ultrazohm/uz_d_encoder/Testing/Pictures/20201110_153028.jpg

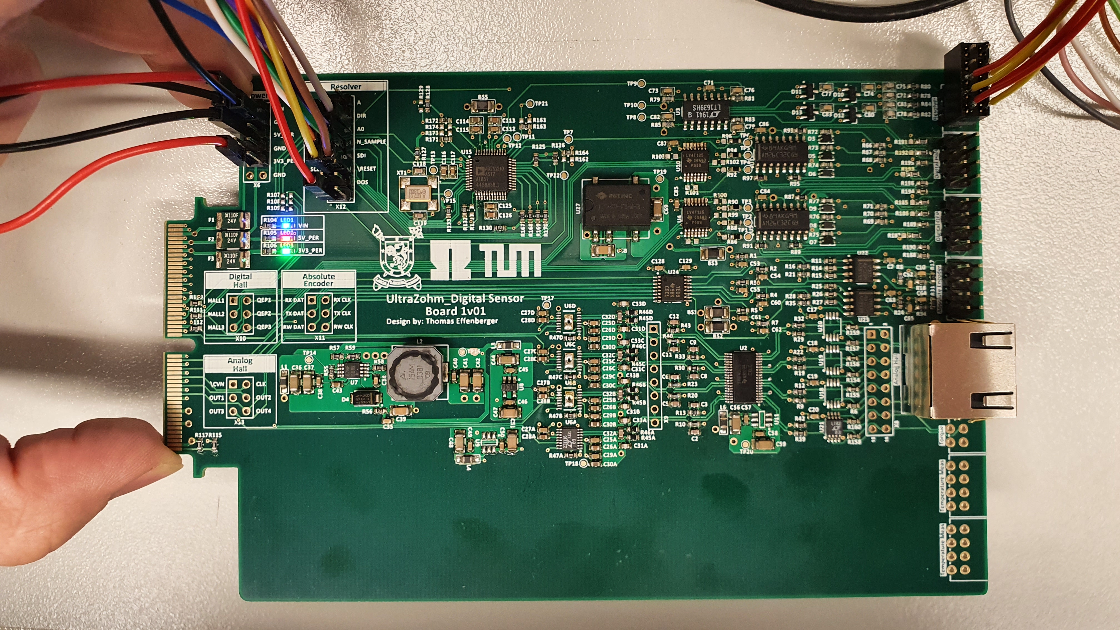
Testing/Pictures/20201110_153028.jpg
