ultrazohm/uz_d_encoder/Testing/Pictures/20201110_152825.jpg

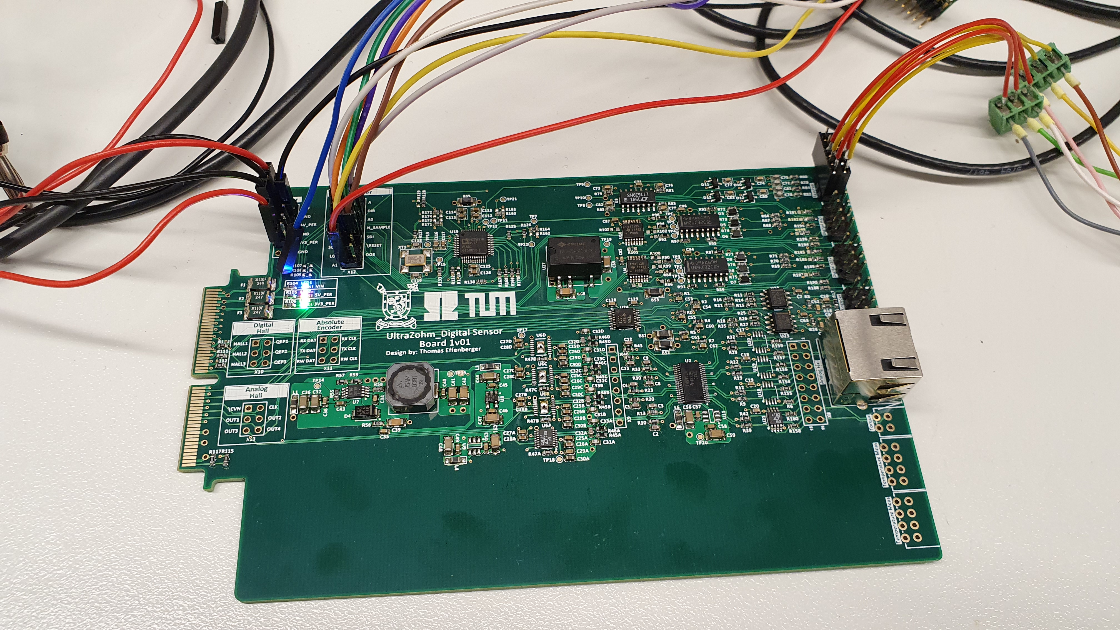
Testing/Pictures/20201110_152825.jpg
