ultrazohm/uz_d_encoder/Testing/Incremental_Encoder_Test/Incremental Sensor Pinout.txt

YE	HALL1_N	  |2	1|	HALL1_P	GN
PK	HALL2_N	  |4	3|	HALL2_P	GY
RD	HALL3_N	  |6	5|	HALL3_P	BU
WH	GND	  |8	7|	+5V	BN
