ultrazohm/uz_d_encoder/IP-Core/Resolver/Resolver.runs/impl_1/.init_design.begin.rst

<?xml version="1.0"?>
<ProcessHandle Version="1" Minor="0">
    <Process Command=".planAhead." Owner="ga63zix" Host="TUEIEAL-TS09" Pid="8820">
    </Process>
</ProcessHandle>
