ultrazohm/uz_d_encoder/IP-Core/Resolver/Resolver.runs/impl_1/.vivado.begin.rst

<?xml version="1.0"?>
<ProcessHandle Version="1" Minor="0">
    <Process Command="vivado.bat" Owner="ga63zix" Host="TUEIEAL-TS09" Pid="7052" HostCore="4" HostMemory="017000308736">
    </Process>
</ProcessHandle>
