ultrazohm/uz_d_encoder/pinout_table.xlsx

Carrier Connector | Default Variant | Net Name (Default) | Resolver Variant | Net Name (Resolver) | FPGA - 18 pins of D5
DIG_IO_00 | Resolver | DIR |  |  | NC
DIG_IO_01 | Resolver | CS |  |  | NC
DIG_IO_02 | Resolver | A0 |  |  | NC
DIG_IO_03 | Resolver | FSYNC |  |  | NC
DIG_IO_04 | Resolver | N_SAMPLE |  |  | NC
DIG_IO_05 | Resolver | SDO |  |  | NC
DIG_IO_06 | Resolver | SDI
DIG_IO_07 | Resolver | SCLK
DIG_IO_08 | Resolver | Reset
DIG_IO_09 | Resolver | A1
DIG_IO_10 | Resolver | LOT (Loss of Tracking) | Resolver | DOS (Degradation of signal)
DIG_IO_11 | Incremental Encoder 1 | A | Resolver | A
DIG_IO_12 | Incremental Encoder 1 | B | Resolver | B
DIG_IO_13 | Incremental Encoder 1 | 0 | Resolver | 0
DIG_IO_14 | Incremental Encoder 2 | A | Resolver | 1
DIG_IO_15 | Incremental Encoder 2 | B | Resolver | 2
DIG_IO_16 | Incremental Encoder 2 | 0 | Resolver | 3
DIG_IO_17 | Absolute Encoder | RX-S_DATA_SH | Resolver | 4
DIG_IO_18 | Absolute Encoder | TX-S_DATA_SH | Resolver | 5
DIG_IO_19 | Absolute Encoder | READ_WRITE_DATA_SH | Resolver | 6
DIG_IO_20 | Absolute Encoder | RX-S_CLOCK_SH | Resolver | 7
DIG_IO_21 | Absolute Encoder | TX-S_CLOCK_SH | Resolver | 8
DIG_IO_22 | Absolute Encoder | READ_WRITE_CLOCK_SH | Resolver | 9
DIG_IO_23 | Analog Hall | CNV | Resolver | 10
DIG_IO_24 | Analog Hall | CLK | Resolver | 11 | NC
DIG_IO_25 | Analog Hall | ADC1 | Resolver | 12 | NC
DIG_IO_26 | Analog Hall | ADC2 | Resolver | 13 | NC
DIG_IO_27 | Analog Hall | ADC3 | Resolver | 14 | NC
DIG_IO_28 | Analog Hall | ADC4 | Resolver | 15 | NC
DIG_IO_29 | Resolver | DOS (Degradation of signal) | Resolver | 16 | NC
