ultrazohm/uz_d_encoder/BOM UltraZohm_Digital_Sensor_Board.xls

Comment | Description | Designator | Footprint | LibRef | Quantity | Value | Manufacturer Part-Number | Supplier 1 | Supplier 2 | Supplier Part Number 1 | Supplier Part Number 2
RJ-45 Modulo | Modulo RJ-45 modulo Horizontal | A1 | RJ45 - 1x1 | RJ45 1 modulo Horizontal | 1 |  | 1-5406299-1 | Digikey |  | A121568-ND
Ferrite bead | 6A | BS1, BS2, BS3, BS5 | RES_1206 | Bead | 4 |  | HI1206T500R-10 | Digikey |  | 240-2412-1-ND
56pF | Capacitor Ceramic | C2, C3, C5, C6, C8, C9, C11, C12 | CAPC1608X07N | Cap_0603 | 8 | 56pF | VJ0603A560JXACW1BC | Mouser |  | 77-VJ0603A560JXACBC
100nF | Capacitor | C7, C53, C54, C55, C60, C61, C62, C63, C67, C71, C84, C85, C86, C87, C128, C129, C13, C14, C15, C16, C17, C18, C19, C20, C21, C22, C23, C24, C25A, C25B, C25C, C25D, C27A, C27B, C27C, C27D, C29A, C29B, C29C, C29D, C38, C40, C45, C46, C49, C50, C57, C58 | CAPC1608X07N | Cap_0603 | 48 | 100n | 885012206071 | Mouser |  | 710-885012206071
1nF | Capacitor | C10, C52, C64, C65, C73, C74, C76, C77, C79, C80, C82, C83 | CAPC1608X07N | Cap_0603 | 12 | 1nF | C0603C102K3GACTU | Digikey |  | 399-7833-1-ND
1uF | Capacitor | C26A, C26B, C26C, C26D, C28A, C28B, C28C, C28D | CAPC1608X07N | Cap_0603 | 8 | 1uF | LMK107B7105KA-T | Mouser |  | 963-LMK107B7105KA-T
10uF | Capacitor Ceramic | C30A, C30B, C30C, C30D, C114 | CAPC1608X07N | Cap_0603 | 5 | 10uF | JMK107ABJ106KA-T | Mouser |  | 963-JMK107ABJ106KA-T
680pF | Capacitor | C31A, C31B, C31C, C31D, C33A, C33B, C33C, C33D | CAPC1608X07N | Cap_0603 | 8 | 680pF | VJ0603A681GXJCW1BC | Mouser |  | 77-VJ0603A681GXJCBC
470pF | Capacitor | C32A, C32B, C32C, C32D | CAPC1608X07N | Cap_0603 | 4 | 470pF | VJ0603A471GXJPW1BC | Mouser |  | 77-VJ0603A471GXJPBC
10nF | Capacitor | C34, C112, C115, C117, C125 | CAPC1608X07N | Cap_0603 | 5 | 10nF | 885012206065 | Mouser |  | 710-885012206065
7.5nF | Capacitor | C35 | CAPC1608X07N | Cap_0603 | 1 | 7.5nF | C0603C752J3GACTU | Mouser |  | 80-C0603C752J3GACTU
10µF | Capacitor Ceramic | C36, C37, C44, C48, C56 | C_1206 |  | 5 | 10µF | GRM319R6YA106KA12D | Mouser |  | 81-GRM319R6YA106KA2D
0.027µF | Capacitor 1206 | C39 | C_1206 |  | 1 | 0.027µF | GRM3195C1H273JA01D | Mouser |  | 81-GRM315C1H273JA01D
47µF | Capacitor 1206 | C41, C42, C47, C51, C59 | C_1206 |  | 5 | 47µF | GRM31CR61A476ME15L | Mouser |  | 81-GRM31CR61A476ME5L
1uF | Capacitor Ceramic | C43 | CAPC1608X07N | Cap_0603 | 1 | 1uF | 885012106022 | Mouser |  | 710-885012106022
120pF | Capacitor Ceramic | C66, C70 | CAP_0603 | Cap_0603 | 2 | 120pF | 06033A121JAT2A | Digikey |  | 478-11799-1-ND
1uF | Capacitor Ceramic | C68 | RES_1206 | Cap_1206 | 1 | 1uF | CC1206ZRY5V9BB105 | Digikey |  | 311-2013-1-ND
2.2uF | Capacitor Ceramic | C69 | RES_1206 | Cap_1206 | 1 | 2.2uF | C1206C225K5RACTU | Digikey |  | 399-8181-1-ND
100pF | Capacitor Ceramic | C72, C75, C78, C81 | CAP_0603 | Cap_0603 | 4 | 100pF | CC0603JRNPO8BN101 | Digikey |  | 311-3949-1-ND
4.7uF | Capacitor Ceramic | C113, C116, C126 | CAP_0603 | Cap_0603 | 3 | 4.7uF | CL10A475KA8NQNC | Digikey |  | 1276-1900-1-ND
20pF | Capacitor Ceramic | C118, C119 | CAP_0603 | Cap_0603 | 2 | 20pF | CC0603JRNPO9BN200 | Digikey |  | 311-1424-1-ND
470nF | Capacitor Ceramic | C121 | CAP_0603 | Cap_0603 | 1 | 470nF | GRM188R61A474KA61D | Digikey |  | 490-1539-1-ND
Conector 4x2 Horizontal | CONN HEADER R/A 8POS 2.54MM Through Hole | CONN1, CONN3, CONN4, CONN6A, CONN6B | Conector 4x2 TH Horizontal | Conector 4x2 Horizontal | 5 |  | IPL1-104-01-L-D-RA-K | Digikey |  | SAM9596-ND
Conector 2x2 Horizontal | CONN HEADER R/A 4 POS 2.54MM Through Hole | CONN2 | Conector 2x2 TH Horizontal | Conector 2x2 Horizontal | 1 |  | IPL1-102-01-L-D-RA-K | Digikey |  | SAM8823-ND
Conector 3x2 Horizontal | CONN HEADER R/A 6 POS 2.54MM Through Hole | CONN5 | Conector 3x2 TH Horizontal | Conector 3x2 Horizontal | 1 |  | IPL1-103-01-L-D-RA-K | Digikey |  | SAM9096-ND
Conector 1x2 Horizontal | CONN HEADER R/A 2POS 2.54MM Through Hole | CONN7 | Conector 1x2 TH Horizontal | Conector 1x2 Horizontal | 1 |  | IPL1-102-01-S-S-RA-K | Digikey |  | SAM12667-ND
Header 6X2 | Header, 12-Pin, Dual row | CONN6 |  |  | 1
Header 8X2 | Header, 16-Pin, Dual row | CONN8
Header 8X1 | Header, 8-Pin, Dual row | CONN9
Diode Array | DIODE ARRAY GP 100V 215MA SOT23 | D1, D2 | SOT-23 | Diode Array | 2 |  | BAV99,235 | Digikey |  | 1727-4311-1-ND
TVS DIODE | TVS DIODE 5V 13.5V SOD323 | D3, D5, D6, D7, D8, D9 | SOD-323 | Diodo TVS | 6 |  | CDSOD323-T05S | Digikey |  | CDSOD323-T05SCT-ND
BYS12-90 | Schottky Diode | D4 | DIOM4227X23N | BYS12-90 | 1 |  | BYS12-90-E3/TR | Digikey |  | BYS12-90-E3/GICT-ND
Diode Array Schottky | DIODE SCHOTTKY 70V DUAL SOT23 | D10, D11, D12, D13 | SOT-23 | Diode Array Schottky | 4 |  | SBAS70-04LT1G | Digikey |  | SBAS70-04LT1GOSCT-ND
Isolated DC-DC Converter | DC DC CONVERTER 12V 1W | U27 | DC/DC 24V-->12V 1W Aislado | DC/DC +12V 1W | 1 |  | PDS1-S24-S12-M-TR | Digikey |  | 102-3406-1-ND
RS485 Transmitter | IC TRANSCEIVER HALF 1/1 8SOIC | U22, U23 | SOIC8_N | Transmisor RS485 | 2 |  | SN75HVD08DR | Digikey |  | 296-37893-1-ND
600Ω | WE-CBF SMD EMI Suppression Ferrite Bead, 0805, 600Ω | L1, L3, L4, L6 | WE-CBF_0805_High Current | WE-CBF, 742792040 | 4 | 600Ω | 742792040 | Farnell | Mouser | 2761567 (https://octopart-clicks.com/click/altium?sku=732-1620-1-ND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) | 710-742792040 (https://octopart-clicks.com/click/altium?sku=732-1620-1-ND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)
150mH | SMT power Inductor, 150uH, 320m DRC | L2 | SMT_inductor_1050_Performance | B82464G4154M | 1 | 150mH | B82464G4154M | Mouser |  | 871-B82464G4154M
Level Shifter 3.3V/5V | Level shifter bidireccional 6 canales | U24 | TSSO5x6-G16 | Level Shifter 1.8V/3.3V | 1 |  | TXB0106PWR | Digikey |  | 296-23759-1-ND
Transistor NPN | NPN Bipolar Transistor | Q1, Q3 | SOT-23 | NPN Transistor BC846 | 2 |  | BC846BLT3G | Digikey |  | BC846BLT3GOSCT-ND
Transistor PNP | PNP Bipolar Transistor | Q2, Q4 | SOT-23 | PNP Transistor BC846 | 2 |  | BC856B,215 | Digikey |  | 1727-2925-1-ND
1k | Resistor | R1, R2, R3, R4, R5, R7, R8, R9, R10, R12, R13, R18, R19, R20, R22, R23, R24, R29, R30, R32, R33, R34, R39, R40, R42, R43, R57, R59 | RESC1608X06N | R_0603 | 28 | 1k | RC0603FR-071KL | Mouser |  | 603-RC0603FR-071KL
0R | Resistor | R6, R14, R15, R26, R27, R47A, R47B, R47C, R47D, R98, R99, R100, R101, R102, R103, R104, R105, R106, R107, R108, R109, R110, R111, R112, R113, R114, R115, R116, R117, R118, R119, R154, R155, R156, R157, R158, R159, R160, R165, R166, R167, R168, R169, R170, R175, R176, R177, R178, R179, R180, R181, R182, R183, R184, R188, R189, R190, R194, R195, R196, R197, R198 | RESC1608X06N | R_0603 | 62 | 0R | CRCW06030000Z0EAC | Mouser |  | 71-CRCW06030000Z0EAC
22 | Resistor | R11, R25 | RESC1608X06N | R_0603 | 2 | 22 | CPF0603B22RE | Digikey |  | A119957CT-ND
10k | Resistor | R16, R21, R28, R35, R44, R48, R61, R161, R162, R163, R164, R171, R172, R173, R174 | RESC1608X06N | R_0603 | 15 | 10k | RC0603JR-0710KL | Digikey |  | 311-10KGRCT-ND
120 | Resistor | R17, R31 | RESC1608X06N | R_0603 | 2 | 120 | ERA-3AEB121V | Digikey |  | P120DBCT-ND
15.4k | Resistor | R36, R53 | RESC1608X06N | R_0603 | 2 | 15.4k | ERA-3AEB1542V | Digikey |  | P15.4KDBCT-ND
22k | Resistor | R37 | RESC1608X06N | R_0603 | 1 | 22k | RC0603JR-0722KL | Digikey |  | 311-22KGRCT-ND
2.2k | Resistor | R38, R52, R54, R65 | RESC1608X06N | R_0603 | 4 | 2.2k | ERJ-3GEYJ222V | Digikey |  | P2.2KGCT-ND
3.3 | Resistor | R41, R51, R60, R64 | RESC1608X06N | R_0603 | 4 | 3.3 | ERJ-3RQF3R3V | Digikey |  | P3.3AJCT-ND
24.9 | Resistor | R45A, R45B, R45C, R45D, R46A, R46B, R46C, R46D | RESC1608X06N | R_0603 | 8 | 24.9 | RC0603FR-0724R9L | Mouser |  | 603-RC0603FR-0724R9L
4.7k | Resistor | R49, R50, R62, R63, R79, R81, R83, R85 | RESC1608X06N | R_0603 | 8 | 4.7k | ERA-3AEB472V | Digikey |  | P4.7KDBCT-ND
162k | Resistor | R55 | RESC1608X06N | R_0603 | 1 | 162k | CRCW0603162KFKEA | Mouser |  | 71-CRCW0603-162K-E3
75k | Resistor | R56 | RESC1608X06N | R_0603 | 1 | 75k | RC0603FR-0775KL | Mouser |  | 603-RC0603FR-0775KL
133k | Resistor | R58 | RESC1608X06N | R_0603 | 1 | 133k | RC0603FR-07133KL | Mouser |  | 603-RC0603FR-07133KL
3.5k | Resistor | R66, R67, R68, R69, R70, R71, R72, R73, R74, R75, R76, R77 | RESC1608X06N | R_0603 | 12 | 3.5k | ERA-3AEB3481V | Digikey |  | P3.48KDBCT-ND
100 | Resistor | R78, R80, R82, R84, R87, R89, R91, R93, R95, R97 | RESC1608X06N | R_0603 | 10 | 100 | RC0603FR-07100RL | Digikey |  | 311-100HRCT-ND
dnp | Solder 0603 resistor/jumper between pads 1 and 2 for standard function. Solter resistor between pads 2 and 3 for alternative function | R86, R88, R90, R92, R94, R96, R185, R186, R187, R191, R192, R193 | 0603_Config | R_config | 12 | 10k | RC0603JR-0710KL | Digikey |  | 311-10KGRCT-ND
200R | WID SMD 1M 5% 0,25W | R150, R151, R152, R153 | RES_1206 |  | 4 | 200R | APC1206B200RN | Mouser |  | 284-APC1206B200RN
2 Channel Opamp | IC OPAMP GP 2 CIRCUIT 14SOIC | U1 | SOIC8_N | AD8662 | 1 |  | AD8662ARZ-REEL7 | Digikey |  | AD8662ARZ-REEL7CT-ND
THS4524 | IC OPAMP DIFF 95MHZ RRO 38TSSOP | U2 | TSSOP38 | THS4521 | 1 |  | THS4524IDBTR | Farnell | Mouser | 2496350 (https://octopart-clicks.com/click/altium?sku=296-24315-1-ND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) | 595-THS4524IDBTR (https://octopart-clicks.com/click/altium?sku=296-24315-1-ND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)
LT1639 | IC OPAMP GP 4 CIRCUIT 14SO | U3 | SOIC-14 | LT1639 | 1 |  | LT1639HS#PBF | Digikey |  | LT1639HS#PBF-ND
IC BUFFER NON-INVERT 5.5V US8 | 3 Channels | U4, U10 | 8-VSSOP | Buffer No inversor | 2 |  | SN74LVC3G17DCUR | Digikey |  | 296-18818-1-ND
Differential Receiver | Logic Differential to Single Ended | U5, U12 | SOIC-16 | Differential Receiver | 2 |  | AM26C32MDREP | Digikey |  | 296-23458-1-ND
LTC2311 | 16 Bit SAR ADC, 5MSps | U6A, U6B, U6C, U6D | LTC2311-16 | LTC2311-16 | 4 |  | LTC2311CMSE-16#PBF | Mouser | Digi-Key | 584-C2311CMSE-16PBF | LTC2311CMSE-16#PBF-ND
LM5007 | Buck Converter, 9-75Vin, 2.5-73Vout | U7 | TSOP65P490X110-8N | LM5007 | 1 |  | LM5007MM/NOPB | Farnell | Mouser | 9779345 (https://octopart-clicks.com/click/altium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) | 926-LM5007MM/NOPB (https://octopart-clicks.com/click/altium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)
TLV741P | 150mA, 2.5V LDO | U8 | SOT95P250X110-5N | TLV741P | 1 |  | TLV74125PDBVR | Mouser | Digi-Key | 595-TLV74125PDBVR | 296-49999-1-ND
LT6654 | Voltage Rerefence | U9, U11 | SOT95P280X100-6N | LT6654 | 2 |  | LT6654BIS6-2.5#TRMPBF | Farnell | Mouser | 2761960 (https://octopart-clicks.com/click/altium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) | 584-6654BIS65TRMPBF (https://octopart-clicks.com/click/altium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)
AD2S1210 | Variable Resolution, 10-Bit to 16-Bit R/D Converter with Reference Oscillator | U15 | LQFP-48_L | AD2S1210 | 1 | AD2S1210 | AD2S1210WDSTZRL7 | Mouser | Digi-Key | 584-AD2S1210WDSTZR7 | AD2S1210WDSTZRL7CT-ND
LT6203 | IC OPAMP GP 2 CIRCUIT 8MSOP | U18, U19, U20, U21 | 8-MSOP | LT6203 | 4 |  | LT6203CMS8#PBF | Digikey |  | LT6203CMS8#PBF-ND
8 MHz | CRYSTAL 8MHZ 18PF SMD | XT1 | CRYSTALOSC | Crystal_8MHz | 1 |  | ECS-80-18-30B-AGN-TR | Digikey |  | XC2709CT-ND
