ultrazohm/uz_d_encoder/Project Outputs for UZ_D_Encoder/Rev02/BOM/bom20211114.xlsx

Sheet: IC
Verfügbar | Comment | Description | Designator | Footprint | LibRef | Quantity | Value | Supplier 1 | Supplier 2 | Supplier Part Number 1 | Supplier Part Number 2
 | LTC6373IDFM#PBF | INST Amp Single ±18V 12-Pin DFN EP Tube | _x0013_A, _x0013_B, _x0013_C, _x0013_D | FP-LTC6373IDFM#PBF-MFG | CMP-09116-000044-1 | 4
 | SN74CBT16214CDGG | Multiplexer/Demultiplexer Bus Switch 1-Element CMOS 36-IN 56-Pin TSSOP Tube | MUX1, MUX2 | TSSOP50P810X120-56N | SN74CBT16214CDGG | 2 |  | Arrow Electronics |  | SN74CBT16214CDGG
 | BC846BLT3G | NPN Bipolar Transistor | Q1, Q3 | SOT-23 | NPN Transistor BC846 | 2 |  | Mouser | Digi-Key | 863-BC846BLT3G | BC846BLT3GOSCT-ND
 | BC856B,215 | PNP Bipolar Transistor | Q2, Q4 | SOT-23 | PNP Transistor BC846 | 2 |  | Mouser | Digi-Key | 771-BC856B-T/R | 1727-2925-1-ND
 | AD8662ARZ | IC OPAMP GP 2 CIRCUIT 14SOIC | U1 | SOIC8_N | AD8662 | 1 |  | Mouser | Digi-Key | 584-AD8662ARZ | AD8662ARZ-ND
 | TXB0108PWR | TXB0108 8-Bit Bidirectional Voltage-Level Translator with Auto-Direction Sensing and +/- 15-kV ESD Protection, 1.2 to 3.6 V, -40 to 85 degC, 20-Pin TSSOP (PW), Green (RoHS & no Sb/Br), Tape and Reel | U2A, U2B | PW0020A_L | CMP-2000-07337-1 | 2
 | LT1639HS#PBF | IC OPAMP GP 4 CIRCUIT 14SO | U3 | SOIC-14 | LT1639 | 1 |  | Mouser | Digikey | 584-LT1639HS#PBF | LT1639HS#PBF-ND
 | ISO7230CDWR | High-Speed, Triple-Channel Digital Isolator | U4, U12 | TI ISO7230 SOIC | TI ISO7230 | 2 |  | Mouser |  | 595-ISO7230CDWR
 | AM26LS32A | Quad Differential Line Receiver, 16-pin Narrow SOIC | U5, U13 | M16A_N | DS26LS32CM | 2 |  | Mouser |  | 595-AM26LS32AIDR
 | LTC2311 | 16 Bit SAR ADC, 5MSps | U6A, U6B, U6C, U6D | LTC2311-16 | LTC2311-16 | 4 |  | Mouser | Digi-Key | 584-C2311CMSE-16PBF | LTC2311CMSE-16#PBF-ND
 | LM5007 | Buck Converter, 9-75Vin, 2.5-73Vout | U7 | TSOP65P490X110-8N | LM5007 | 1 |  | Farnell | Mouser | 9779345 | 926-LM5007MM/NOPB
 | TLV74125PDBVR | 150mA, 2.5V LDO | U8 | SOT95P250X110-5N | TLV741P | 1 |  | Mouser | Digi-Key | 595-TLV74125PDBVR | 296-49999-1-ND
 | LT6654 |  | U9, | SOT95P280X100-6N | LT6654 | 1 |  | Farnell | Mouser | 2761960 | 584-6654BIS65TRMPBF, 584-6654BIS625TRMPBF
 | TMH 0505S | 5V/5V DC-DC Isolation Converter | U10, U14 | SIL-6(7) | TRACO TMH 0505S | 2
 | AD2S1210WDSTZR7 | Variable Resolution, 10-Bit to 16-Bit R/D Converter with Reference Oscillator | U15 | LQFP-48_L | AD2S1210 | 1 | AD2S1210 | Mouser | Digi-Key | 584-AD2S1210WDSTZR7 | AD2S1210WDSTZRL7CT-ND
 | LTC3265EFE#PBF | IC REG CHARG PUMP INV DL 20TSSOP | U16 | FP-FE-20-05-08-1663-MFG | CMP-09139-000006-1 | 1
 | LM3480IM3X-12 | 100 mA, Quasi Low-Dropout Linear Voltage Regulator, 3-pin SOT-23 | U17 | DBZ0003A_L | CMP-0056-00145-3 | 1
 | PCA9554ADGVR | Remote 8-Bit I2C and SMBus I/O Expander with Interrupt Output and Configuration Registers, 8 Outputs, 2.3 to 5.5 V, -40 to 85 degC, 16-pin TVSOP (DGV), Green (RoHS & no Sb/Br) | U18A, U18B, U18C | DGV0016A_L | CMP-0314-00393-2 | 3
 | SN75HVD08DR | IC TRANSCEIVER HALF 1/1 8SOIC | U22A, U22B, U23A, U23B | SOIC8_N | Transmisor RS485 | 4 |  | Mouser | Digi-Key | 595-SN75HVD08DR | 296-37893-1-ND
 | PDS1-S24-S12-M-TR | DC DC CONVERTER 12V 1W | U27 | DC/DC 24V-->12V 1W Aislado | DC/DC +12V 1W | 1 |  | Mouser | Digi-Key | 490-PDS1S24S12MTR | 102-3406-1-ND

Sheet: L
600Ω | WE-CBF SMD EMI Suppression Ferrite Bead, 0805, 600Ω | L1, L3, L4, L5, L6 | WE-CBF_0805_High Current | WE-CBF, 742792040 | 5 | 600Ω | Farnell | Mouser | 2761567 | 710-742792040
150mH | SMT power Inductor, 150uH, 320m DRC | L2 | SMT_inductor_1050_Performance | B82464G4154M | 1 | 150mH | Mouser |  | 871-B82464G4154M
782763102 | ALTERNATIVE Ferrite bead 6A | BS1A, BS1B, BS2A, BS2B, BS3, BS4, BS5 | RES_1206 | Bead | 7 |  | Mouser | Digi-Key | 875-HI1206T500R-10 | 240-2412-1-ND

Sheet: SW
206-126 | Switch DIP OFF ON SPDT 6 Raised Slide 0.05A 24VDC PC Pins 2.54mm Thru-Hole Tube | SW1A, SW1B, SW1C, SW1D, SW2, SW3 | 206-123 | 206-126 | 6 | Digi-Key | 206-126-ND

Sheet: CON
IPL1-104-01-L-D-RA-K | CONN HEADER R/A 8POS 2.54MM Through Hole | X1A, X1B, X3, X4 | Conector 4x2 TH Horizontal | Conector 4x2 Horizontal | 4 | Mouser | Digi-Key | 200-IPL110401LDRAK | SAM9596-ND
IPL1-102-01-L-D-RA-K | CONN HEADER R/A 4 POS 2.54MM Through Hole | X2 | Conector 2x2 TH Horizontal | Conector 2x2 Horizontal | 1 | Mouser | Digi-Key | 200-IPL110201LDRAK | SAM8823-ND
IPL1-103-01-L-D-RA-K | CONN HEADER R/A 6 POS 2.54MM Through Hole | X5 | Conector 3x2 TH Horizontal | Conector 3x2 Horizontal | 1 | Mouser | Digi-Key | 200-IPL110301LDRAK | SAM9096-ND
Header 6X2 | Header, 6-Pin, Dual row | X6 | HDR2X6 | Header 6X2 | 1
IPL1-102-01-S-S-RA-K | CONN HEADER R/A 2POS 2.54MM Through Hole | X7 | Conector 1x2 TH Horizontal | Conector 1x2 Horizontal | 1 | Mouser | Digi-Key | 200-IPL110201SSRAK | SAM12667-ND
Header 8X2 | Header, 8-Pin, Dual row | X8, X9 | HDR2X8 | Header 8X2 | 2
615008140621 | Modular Jack WR-MJ, Tab Up, Shielded, with EMI Panel Finger, Horizontal Entry, THT, 8P8C | X17 | 615008140621 | 615008140621 | 1 | Mouser | Digi-Key | 710-615008140621 | 732-2742-ND

Sheet: D
BAV99,215 | DIODE ARRAY GP 100V 215MA SOT23 | D1, D2 | SOT-23 | Diode Array | 2 |  | Mouser | Digi-Key | 771-BAV99235 | 1727-4311-1-ND
CDSOD323-T03C | TVS DIODE 3.3V 19V SOD323 | D3, D5, D6, D7, D8, D9 | SOD-323 | Diodo TVS | 6 |  | Mouser | Digi-Key | 652-CDSOD323-T03C | CDSOD323-T03CCT-ND
BYS12-90 | Schottky Diode | D4 | DIOM4227X23N | BYS12-90 | 1 |  | Farnell | Mouser | 2889144 | 625-BYS12-90-E3/TR3
SBAS70-04LT1G | DIODE SCHOTTKY 70V DUAL SOT23 | D10, D11, D12, D13 | SOT-23 | Diode Array Schottky | 4 |  | Mouser | Digi-Key | 863-SBAS70-04LT1G | SBAS70-04LT1GOSCT-ND
150060BS75000 | WL-SMCW SMD Mono-color Chip LED Waterclear, size 0603, Blue, 3.2 V, 140° | LED1 | WL-SMCW_0603 | LED_Blue_0603 | 1 | 150060BS75000 | Farnell | Mouser | 2322069 | 710-150060BS75000
150060RS75000 | WL-SMCW SMD Mono-color Chip LED Waterclear, size 0603, Red, 2 V, 140° | LED2 | WL-SMCW_0603 | LED_Red_0603 | 1 | 150060RS75000 | Farnell | Mouser | 2322071 | 710-150060RS75000
150060GS75000 | WL-SMCW SMD Mono-color Chip LED Waterclear, size 0603, Green, 3.2 V, 140° | LED3 | WL-SMCW_0603 | LED_Green_0603 | 1 | 150060GS75000 | Farnell | Mouser | 2322070 | 710-150060GS75000

Sheet: C
1uF |  | C1A, C1B, C1C, C1D, C26A, C26B, C26C, C26D, C28A, C28B, C28C, C28D, C43, C84, C89 | CAPC1608X07N | Cap_0603 | 15 | 1uF | Mouser | 963-LMK107B7105KA-T, 710-885012206071
100nF |  | C2A, C2B, C2C, C2D, C7A, C7B, C8A, C8B, C8C, C8D, C25A, C25B, C25C, C25D, C27A, C27B, C27C, C27D, C29A, C29B, C29C, C29D, C38, C40, C45, C46, C49, C50, C53A, C53B, C54A, C54B, C55A, C55B, C57, C58, C60A, C60B, C61A, C61B, C62A, C62B, C63A, C63B, C67, C71, C85, C86, C90, C91, C92, C93, C94, C95, C96A, C96B, C96C, C97A, C97B, C97C, C128A, C128B, C129A, C129B | CAPC1608X07N | Cap_0603 | 64 | 100nF | Mouser | 710-885012206071
680pF |  | C3A, C3B, C3C, C3D, C6A, C6B, C6C, C6D, C31A, C31B, C31C, C31D, C33A, C33B, C33C, C33D | CAPC1608X07N | Cap_0603 | 16 | 680pF | Mouser | 77-VJ0603A681GXJCBC
470pF |  | C4A, C4B, C4C, C4D, C32A, C32B, C32C, C32D | CAPC1608X07N | Cap_0603 | 8 | 470pF | Mouser | 77-VJ0603A471GXJPBC
180pF |  | C5A, C5B, C5C, C5D | CAPC1608X07N | Cap_0603 | 4 | 180pF | Mouser | 77-VJ0603A681GXJCBC
100nF | Capacitor | C9, C11, C16, C17 | RESC0805 | Cap | 4 | 100nF
1nF |  | C10A, C10B, C52A, C52B, C64A, C64B, C65A, C65B, C73, C74, C76, C77, C79, C80, C82, C83 | CAPC1608X07N | Cap_0603 | 16 | 1nF
10nF | Capacitor | C12, C13, C14, C18, C19, C21 | RESC0805 | Cap | 6 | 10nF
10uF | Capacitor | C15, C20 | CAPR5-4X5 | Cap2 | 2 | 10uF
10uF | Capacitor 1206 | C22, C23, C24, C36, C37, C44, C48, C56, C87, C88 | C_1206 | C_1206 | 10 | 10uF | Mouser | 81-GRM319R6YA106KA2D
10uF |  | C30A, C30B, C30C, C30D, C114 | CAPC1608X07N | Cap_0603 | 5 | 10uF | Mouser | 963-JMK107ABJ106KA-T
10nF |  | C34, C112, C115, C117, C125 | CAPC1608X07N | Cap_0603 | 5 | 10nF | Mouser | 710-885012206065
7.5nF |  | C35 | CAPC1608X07N | Cap_0603 | 1 | 7.5nF | Mouser | 80-C0603C752J3GACTU
0.027uF | Capacitor 1206 | C39 | C_1206 | C_1206 | 1 | 0.027uF | Mouser | 81-GRM315C1H273JA01D
47uF | Capacitor 1206 | C41, C42, C47, C51, C59 | C_1206 | C_1206 | 5 | 47uF | Mouser | 81-GRM31CR61A476ME5L
120pF |  | C66, C70 | CAPC1608X07N | Cap_0603 | 2 | 120pF
1uF | Capacitor | C68 | RES_1206 | Cap_1206 | 1 | 1uF
2.2uF | Capacitor | C69 | RES_1206 | Cap_1206 | 1 | 2.2uF
100pF |  | C72, C75, C78, C81 | CAPC1608X07N | Cap_0603 | 4 | 100pF
4.7uF |  | C113, C116, C126 | CAPC1608X07N | Cap_0603 | 3 | 4.7uF
20pF |  | C118, C119 | CAPC1608X07N | Cap_0603 | 2 | 20pF

Sheet: FUSE
PTC, 1.1A, 24V | Resettable PTC Polyfuse SMD, 1812, automotive | F1, F2, F3 | 1812_PTC_Polyfuse_Littelfuse | Littelfuse_PTC_1812 | 3 | PTC, 1.1A, 24V

Sheet: R
100k |  | R1A, R1B, R2A, R2B, R3A, R3B, R4A, R4B, R5A, R5B, R7A, R7B | RESC1608X06N | R_0603 | 12 | 100k
24R9 |  | R6A, R6B, R6C, R6D, R9A, R9B, R9C, R9D, R45A, R45B, R45C, R45D, R46A, R46B, R46C, R46D | RESC1608X06N | R_0603 | 16 | 24R9
1k |  | R8A, R8B, R18A, R18B, R24A, R24B, R34A, R34B, R57, R59 | RESC1608X06N | R_0603 | 10 | 1k
10k |  | R10A, R10B, R10C, R10D, R12A, R12B, R12C, R12D, R13A, R13B, R13C, R13D, R16A, R16B, R21A, R21B, R28A, R28B, R32, R35A, R35B, R39, R40, R42, R43, R44, R48, R61, R87, R125, R126, R128, R129, R131, R132, R134, R135, R136, R137, R138, R139, R143, R144, R145, R161, R162, R163, R164, R167, R168, R169, R170, R171, R172, R173, R174 | RESC1608X06N | R_0603 | 56 | 10k
22R |  | R11A, R11B, R25A, R25B | RESC1608X06N | R_0603 | 4 | 22R
0R |  | R14A, R14B, R15A, R15B, R26A, R26B, R27A, R27B, R47A, R47B, R47C, R47D, R115, R117, R188, R189, R190, R194, R195, R196 | RESC1608X06N | R_0603 | 20 | 0R
120 |  | R17A, R17B, R31A, R31B | RESC1608X06N | R_0603 | 4 | 120
15.4k |  | R36, R53 | RESC1608X06N | R_0603 | 2 | 15.4k
22k |  | R37 | RESC1608X06N | R_0603 | 1 | 22k
2.2k |  | R38, R52, R54, R65 | RESC1608X06N | R_0603 | 4 | 2.2k
3.3 |  | R41, R51, R60, R64 | RESC1608X06N | R_0603 | 4 | 3.3
4.7 |  | R49, R50, R62, R63 | RESC1608X06N | R_0603 | 4 | 4.7
162k |  | R55 | RESC1608X06N | R_0603 | 1 | 162k
75k |  | R56 | RESC1608X06N | R_0603 | 1 | 75k
133k |  | R58 | RESC1608X06N | R_0603 | 1 | 133k
3.5k |  | R66, R67, R68, R69, R70, R71, R72, R73, R74, R75, R76, R77 | RESC1608X06N | R_0603 | 12 | 3.5k
100 |  | R78, R80, R82, R84 | RESC1608X06N | R_0603 | 4 | 100
4.7k |  | R79, R81, R83, R85 | RESC1608X06N | R_0603 | 4 | 4.7k
VISHAY VSOR 47.K | Isolated Resistor Network | R92, R99 | SO-16_N | Res Pack3 | 2 | 4.7K
120 | Resistor | R93, R94, R95, R100, R101, R102 | RESC0805 | Resistor | 6 | 120
24.9k |  | R104 | RESC1608X06N | R_0603 | 1 | 24.9k
3.01k |  | R105 | RESC1608X06N | R_0603 | 1 | 3.01k
1.3k |  | R106 | RESC1608X06N | R_0603 | 1 | 1.3k
0 |  | R112, R113, R114, R116 | RESC1608X06N | R_0603 | 4 | 0
604k |  | R118, R119 | RESC1608X06N | R_0603 | 2 | 604k
52k3 |  | R120, R121 | RESC1608X06N | R_0603 | 2 | 52k3
15k |  | R127, R133 | RESC1608X06N | R_0603 | 2 | 15k
7.5k |  | R130 | RESC1608X06N | R_0603 | 1 | 7.5k
