ultrazohm/uz_d_encoder/Project Outputs for UZ_D_Encoder/Rev02/BOM/bom20211116.xlsx

Sheet: Mouser
Part Number | Menge
584-LTC6373IDFMPBF | 4
595-SN74CBT16214CDGG | 2
863-SBC846BLT3G | 2
771-BC856B-T/R | 2
584-AD8662ARZ | 1
584-LT1639HS#PBF | 1
595-AM26LS32AIDR | 1
595-ISO7230CDWR | 2
584-C2311IMSE-16PBF | 4
595-TLV74125PDBVR | 1
584-AD2S1210WDSTZR7 | 1
584-LTC3265EFE#PBF | 1
926-LM3480IM3X12NOPB | 1
595-PCA9554ADGVR | 3
595-SN75HVD08DR | 4
490-PDS1S24S12MTR | 1
520-80-18-30B-AGNT | 1
774-206126 | 6
710-742792040 | 5
871-B82464G4154M | 1
710-782763102 | 7
200-IPL110401LDRAK | 4
200-IPL110201LDRAK | 1
200-IPL110301LDRAK | 1
200-IPL110201SSRAK | 1
710-615008140621 | 1
571-1033286 | 1
571-5-146254-8 | 2
710-150060BS75000 | 1
710-150060GS75000 | 1
710-150060RS75000 | 1
625-BYS12-90-E3/TR3 | 1
576-1812L075/24DR | 3

Sheet: Res
100k |  | R1A, R1B, R2A, R2B, R3A, R3B, R4A, R4B, R5A, R5B, R7A, R7B | RESC1608X06N | R_0603 | 12 | 100k
24R9 |  | R6A, R6B, R6C, R6D, R9A, R9B, R9C, R9D, R45A, R45B, R45C, R45D, R46A, R46B, R46C, R46D | RESC1608X06N | R_0603 | 16 | 24R9
1k |  | R8A, R8B, R18A, R18B, R24A, R24B, R34A, R34B, R57, R59 | RESC1608X06N | R_0603 | 10 | 1k
10k |  | R10A, R10B, R10C, R10D, R12A, R12B, R12C, R12D, R13A, R13B, R13C, R13D, R16A, R16B, R21A, R21B, R28A, R28B, R32, R35A, R35B, R39, R40, R42, R43, R44, R48, R61, R87, R125, R126, R128, R129, R131, R132, R134, R135, R136, R137, R138, R139, R143, R144, R145, R161, R162, R163, R164, R167, R168, R169, R170, R171, R172, R173, R174 | RESC1608X06N | R_0603 | 56 | 10k
22R |  | R11A, R11B, R25A, R25B | RESC1608X06N | R_0603 | 4 | 22R
0R |  | R14A, R14B, R15A, R15B, R26A, R26B, R27A, R27B, R47A, R47B, R47C, R47D, R115, R117, R188, R189, R190, R194, R195, R196 | RESC1608X06N | R_0603 | 20 | 0R
120 |  | R17A, R17B, R31A, R31B | RESC1608X06N | R_0603 | 4 | 120
15.4k |  | R36, R53 | RESC1608X06N | R_0603 | 2 | 15.4k
22k |  | R37 | RESC1608X06N | R_0603 | 1 | 22k
2.2k |  | R38, R52, R54, R65 | RESC1608X06N | R_0603 | 4 | 2.2k
3.3 |  | R41, R51, R60, R64 | RESC1608X06N | R_0603 | 4 | 3.3
4.7 |  | R49, R50, R62, R63 | RESC1608X06N | R_0603 | 4 | 4.7
162k |  | R55 | RESC1608X06N | R_0603 | 1 | 162k
75k |  | R56 | RESC1608X06N | R_0603 | 1 | 75k
133k |  | R58 | RESC1608X06N | R_0603 | 1 | 133k
3.5k |  | R66, R67, R68, R69, R70, R71, R72, R73, R74, R75, R76, R77 | RESC1608X06N | R_0603 | 12 | 3.5k
100 |  | R78, R80, R82, R84 | RESC1608X06N | R_0603 | 4 | 100
4.7k |  | R79, R81, R83, R85 | RESC1608X06N | R_0603 | 4 | 4.7k
VISHAY VSOR 47.K | Isolated Resistor Network | R92, R99 | SO-16_N | Res Pack3 | 2 | 4.7K
120 | Resistor | R93, R94, R95, R100, R101, R102 | RESC0805 | Resistor | 6 | 120
24.9k |  | R104 | RESC1608X06N | R_0603 | 1 | 24.9k
3.01k |  | R105 | RESC1608X06N | R_0603 | 1 | 3.01k
1.3k |  | R106 | RESC1608X06N | R_0603 | 1 | 1.3k
0 |  | R112, R113, R114, R116 | RESC1608X06N | R_0603 | 4 | 0
604k |  | R118, R119 | RESC1608X06N | R_0603 | 2 | 604k
52k3 |  | R120, R121 | RESC1608X06N | R_0603 | 2 | 52k3
15k |  | R127, R133 | RESC1608X06N | R_0603 | 2 | 15k
7.5k |  | R130 | RESC1608X06N | R_0603 | 1 | 7.5k

Sheet: RS
709-9038 | TXB0108PWR | 3
103-7576 | BAV99,215 | 2

Sheet: Teile Sonst
LT6654BIS6-5#TRMPBF | Digikey
TMH 0505S | Digikey
SBAS70-04LT1G
652-CDSOD323-T03C

Sheet: Caps
1uF |  | C1A, C1B, C1C, C1D, C26A, C26B, C26C, C26D, C28A, C28B, C28C, C28D, C43, C84, C89 | CAPC1608X07N | Cap_0603 | 15 | 1uF |  |  | 25V
100nF |  | C2A, C2B, C2C, C2D, C7A, C7B, C8A, C8B, C8C, C8D, C9, C11, C16, C17, C25A, C25B, C25C, C25D, C27A, C27B, C27C, C27D, C29A, C29B, C29C, C29D, C38, C40, C45, C46, C49, C50, C53A, C53B, C54A, C54B, C55A, C55B, C60A, C60B, C61A, C61B, C62A, C62B, C63A, C63B, C67, C71, C85, C86, C90, C91, C92, C93, C94, C95, C96A, C96B, C96C, C97A, C97B, C97C, C98, C99, C128A, C128B, C129A, C129B | CAPC1608X07N | Cap_0603 | 68 | 100nF | Mouser | 710-885012206071 | 50V
680pF |  | C3A, C3B, C3C, C3D, C6A, C6B, C6C, C6D, C31A, C31B, C31C, C31D, C33A, C33B, C33C, C33D | CAPC1608X07N | Cap_0603 | 16 | 680pF | Mouser | 77-VJ0603A681GXJCBC | 16V
470pF |  | C4A, C4B, C4C, C4D, C32A, C32B, C32C, C32D | CAPC1608X07N | Cap_0603 | 8 | 470pF | Mouser | 77-VJ0603A471GXJPBC | 16V
180pF |  | C5A, C5B, C5C, C5D | CAPC1608X07N | Cap_0603 | 4 | 180pF | Mouser | 77-VJ0603A681GXJCBC | 16V
1nF |  | C10A, C10B, C52A, C52B, C64A, C64B, C65A, C65B, C73, C74, C76, C77, C79, C80, C82, C83 | CAPC1608X07N | Cap_0603 | 16 | 1nF |  |  | 25V
10nF |  | C12, C13, C14, C18, C19, C21, C34, C112, C115, C117, C125 | CAPC1608X07N | Cap_0603 | 11 | 10nF | Mouser | 710-885012206065 | 25V
10uF | Capacitor 1206 | C15, C20, C22, C23, C24, C30A, C30B, C30C, C30D, C36, C37, C44, C48, C87, C88, C114 | C_1206 | C_1206 | 16 | 10uF | Mouser | 81-GRM319R6YA106KA2D | 35V
7.5nF |  | C35 | CAPC1608X07N | Cap_0603 | 1 | 7.5nF | Mouser | 80-C0603C752J3GACTU | 25V
0.027uF | Capacitor 1206 | C39 | C_1206 | C_1206 | 1 | 0.027uF | Mouser | 81-GRM315C1H273JA01D | 50V
47uF | Capacitor 1206 | C41, C42, C47, C51 | C_1206 | C_1206 | 4 | 47uF | Mouser | 81-GRM31CR61A476ME5L | 10V
1uF | Capacitor | C56, C57, C58, C68 | RES_1206 | Cap_1206 | 4 | 1uF |  |  | 50V
120pF |  | C66, C70 | CAPC1608X07N | Cap_0603 | 2 | 120pF |  |  | 25V
100pF |  | C72, C75, C78, C81 | CAPC1608X07N | Cap_0603 | 4 | 100pF |  |  | 25V
4.7uF |  | C113, C116, C126 | CAPC1608X07N | Cap_0603 | 3 | 4.7uF |  |  | 25V
20pF |  | C118, C119 | CAPC1608X07N | Cap_0603 | 2 | 20pF |  |  | 50V
