ultrazohm/uz_d_encoder/Project Outputs for UZ_D_Encoder/Rev02/BOM/BOM20211031.xlsx

Comment | Description | Designator | Digikey Part-Number | Footprint | LibRef | Quantity | Value | Manufacturer Part Number 1 | Manufacturer Part Number 2 | Manufacturer Part-Number | Supplier 1 | Supplier 2 | Supplier Part Number 1 | Supplier Part Number 2
+C72 | Ferrite bead 6A | BS1, BS2, BS3, BS5 |  | RES_1206 | Bead | 4 |  |  |  |  | Mouser | Digi-Key | 875-HI1206T500R-10 | 240-2412-1-ND
56pF |  | C2, C3, C5, C6, C8, C9, C11, C12 |  | CAPC1608X07N | Cap_0603 | 8 | 56pF |  |  |  | Mouser |  | 77-VJ0603A560JXACBC
100nF |  | C7, C13, C14, C15, C16, C17, C18, C19, C20, C21, C22, C23, C24, C25A, C25B, C25C, C25D, C27A, C27B, C27C, C27D, C29A, C29B, C29C, C29D, C38, C40, C45, C46, C49, C50, C53, C54, C55, C57, C58, C60, C61, C62, C63, C67, C71, C84, C85, C86, C87, C128, C129 |  | CAPC1608X07N | Cap_0603 | 48 | 100nF |  |  |  | Mouser |  | 710-885012206071
1nF |  | C10, C52, C64, C65, C73, C74, C76, C77, C79, C80, C82, C83 |  | CAPC1608X07N | Cap_0603 | 12 | 1nF
1uF |  | C26A, C26B, C26C, C26D, C28A, C28B, C28C, C28D, C43 |  | CAPC1608X07N | Cap_0603 | 9 | 1uF |  |  |  | Mouser |  | 963-LMK107B7105KA-T
10uF |  | C30A, C30B, C30C, C30D, C114 |  | CAPC1608X07N | Cap_0603 | 5 | 10uF |  |  |  | Mouser |  | 963-JMK107ABJ106KA-T
680pF |  | C31A, C31B, C31C, C31D, C33A, C33B, C33C, C33D |  | CAPC1608X07N | Cap_0603 | 8 | 680pF |  |  |  | Mouser |  | 77-VJ0603A681GXJCBC
470pF |  | C32A, C32B, C32C, C32D |  | CAPC1608X07N | Cap_0603 | 4 | 470pF |  |  |  | Mouser |  | 77-VJ0603A471GXJPBC
10nF |  | C34, C112, C115, C117, C125 |  | CAPC1608X07N | Cap_0603 | 5 | 10nF |  |  |  | Mouser |  | 710-885012206065
7.5nF |  | C35 |  | CAPC1608X07N | Cap_0603 | 1 | 7.5nF |  |  |  | Mouser |  | 80-C0603C752J3GACTU
10uF | Capacitor 1206 | C36, C37, C44, C48, C56 |  | C_1206 |  | 5 | 10uF |  |  |  | Mouser |  | 81-GRM319R6YA106KA2D
0.027uF | Capacitor 1206 | C39 |  | C_1206 |  | 1 | 0.027uF |  |  |  | Mouser |  | 81-GRM315C1H273JA01D
47uF | Capacitor 1206 | C41, C42, C47, C51, C59 |  | C_1206 |  | 5 | 47uF |  |  |  | Mouser |  | 81-GRM31CR61A476ME5L
120pF |  | C66, C70 |  | CAPC1608X07N | Cap_0603 | 2 | 120pF
1uF | Capacitor | C68 |  | RES_1206 | Cap_1206 | 1 | 1uF
2.2uF | Capacitor | C69 |  | RES_1206 | Cap_1206 | 1 | 2.2uF
100pF |  | C72, C75, C78, C81 |  | CAPC1608X07N | Cap_0603 | 4 | 100pF
4.7uF |  | C113, C116, C126 |  | CAPC1608X07N | Cap_0603 | 3 | 4.7uF
20pF |  | C118, C119 |  | CAPC1608X07N | Cap_0603 | 2 | 20pF
BAV99,235 | DIODE ARRAY GP 100V 215MA SOT23 | D1, D2 |  | SOT-23 | Diode Array | 2 |  |  |  |  | Mouser | Digi-Key | 771-BAV99235 | 1727-4311-1-ND
CDSOD323-T03C | TVS DIODE 3.3V 19V SOD323 | D3, D5, D6, D7, D8, D9 |  | SOD-323 | Diodo TVS | 6 |  |  |  |  | Mouser | Digi-Key | 652-CDSOD323-T03C | CDSOD323-T03CCT-ND
BYS12-90 | Schottky Diode | D4 |  | DIOM4227X23N | BYS12-90 | 1 |  |  |  |  | Farnell | Mouser | 2889144 | 625-BYS12-90-E3/TR3
SBAS70-04LT1G | DIODE SCHOTTKY 70V DUAL SOT23 | D10, D11, D12, D13 |  | SOT-23 | Diode Array Schottky | 4 |  |  |  |  | Mouser | Digi-Key | 863-SBAS70-04LT1G | SBAS70-04LT1GOSCT-ND
PTC, 1.1A, 24V | Resettable PTC Polyfuse SMD, 1812, automotive | F1, F2, F3 |  | 1812_PTC_Polyfuse_Littelfuse | Littelfuse_PTC_1812 | 3 | PTC, 1.1A, 24V
600Ω | WE-CBF SMD EMI Suppression Ferrite Bead, 0805, 600Ω | L1, L3, L4, L6 |  | WE-CBF_0805_High Current | WE-CBF, 742792040 | 4 | 600Ω |  |  |  | Farnell | Mouser | 2761567 | 710-742792040
150mH | SMT power Inductor, 150uH, 320m DRC | L2 |  | SMT_inductor_1050_Performance | B82464G4154M | 1 | 150mH |  |  |  | Mouser |  | 871-B82464G4154M
150060BS75000 | WL-SMCW SMD Mono-color Chip LED Waterclear, size 0603, Blue, 3.2 V, 140° | LED1 |  | WL-SMCW_0603 | LED_Blue_0603 | 1 | 150060BS75000 |  |  |  | Farnell | Mouser | 2322069 | 710-150060BS75000
150060RS75000 | WL-SMCW SMD Mono-color Chip LED Waterclear, size 0603, Red, 2 V, 140° | LED2 |  | WL-SMCW_0603 | LED_Red_0603 | 1 | 150060RS75000 |  |  |  | Farnell | Mouser | 2322071 | 710-150060RS75000
150060GS75000 | WL-SMCW SMD Mono-color Chip LED Waterclear, size 0603, Green, 3.2 V, 140° | LED3 |  | WL-SMCW_0603 | LED_Green_0603 | 1 | 150060GS75000 |  |  |  | Farnell | Mouser | 2322070 | 710-150060GS75000
BC846BLT3G | NPN Bipolar Transistor | Q1, Q3 |  | SOT-23 | NPN Transistor BC846 | 2 |  |  |  |  | Mouser | Digi-Key | 863-BC846BLT3G | BC846BLT3GOSCT-ND
BC856B,215 | PNP Bipolar Transistor | Q2, Q4 |  | SOT-23 | PNP Transistor BC846 | 2 |  |  |  |  | Mouser | Digi-Key | 771-BC856B-T/R | 1727-2925-1-ND
100k |  | R1, R2, R3, R4, R5, R7 |  | RESC1608X06N | R_0603 | 6 | 100k |  |  |  | Mouser |  | 603-RC0603FR-071KL
0R |  | R6, R14, R15, R26, R27, R47A, R47B, R47C, R47D, R98, R99, R100, R101, R102, R103, R107, R108, R109, R110, R111, R112, R115, R117, R154, R155, R156, R157, R158, R159, R160, R188, R189, R190, R194, R195, R196 |  | RESC1608X06N | R_0603 | 36 | 0R |  |  |  | Mouser |  | 71-CRCW06030000Z0EAC
1k |  | R8, R9, R10, R12, R13, R18, R19, R20, R22, R23, R24, R29, R30, R32, R33, R34, R39, R40, R42, R43, R57, R59 |  | RESC1608X06N | R_0603 | 22 | 1k |  |  |  | Mouser |  | 603-RC0603FR-071KL
22R |  | R11, R25 |  | RESC1608X06N | R_0603 | 2 | 22R
10k |  | R16, R21, R28, R35, R44, R48, R61, R125, R126, R128, R129, R131, R132, R161, R162, R163, R164, R167, R168, R169, R170, R171, R172, R173, R174 |  | RESC1608X06N | R_0603 | 25 | 10k |  |  |  | Mouser |  | 71-CRCW06030000Z0EAC
120 |  | R17, R31, R87, R89, R91, R93, R95, R97 |  | RESC1608X06N | R_0603 | 8 | 120
15.4k |  | R36, R53 |  | RESC1608X06N | R_0603 | 2 | 15.4k |  |  |  | Mouser |  | 71-CRCW06030000Z0EAC
22k |  | R37 |  | RESC1608X06N | R_0603 | 1 | 22k
2.2k |  | R38, R52, R54, R65 |  | RESC1608X06N | R_0603 | 4 | 2.2k |  |  |  | Mouser |  | 71-CRCW06030000Z0EAC
3.3 |  | R41, R51, R60, R64 |  | RESC1608X06N | R_0603 | 4 | 3.3 |  |  |  | Mouser |  | 71-CRCW06030000Z0EAC
24R9 |  | R45A, R45B, R45C, R45D, R46A, R46B, R46C, R46D |  | RESC1608X06N | R_0603 | 8 | 24R9 |  |  |  | Mouser |  | 603-RC0603FR-0724R9L
4.7 |  | R49, R50, R62, R63 |  | RESC1608X06N | R_0603 | 4 | 4.7 |  |  |  | Mouser
162k |  | R55 |  | RESC1608X06N | R_0603 | 1 | 162k |  |  |  | Mouser |  | 71-CRCW0603-162K-E3
75k |  | R56 |  | RESC1608X06N | R_0603 | 1 | 75k |  |  |  | Mouser |  | 603-RC0603FR-0775KL
133k |  | R58 |  | RESC1608X06N | R_0603 | 1 | 133k |  |  |  | Mouser |  | 603-RC0603FR-07133KL
3.5k |  | R66, R67, R68, R69, R70, R71, R72, R73, R74, R75, R76, R77 |  | RESC1608X06N | R_0603 | 12 | 3.5k
100 |  | R78, R80, R82, R84 |  | RESC1608X06N | R_0603 | 4 | 100
4.7k |  | R79, R81, R83, R85 |  | RESC1608X06N | R_0603 | 4 | 4.7k
dnp | Solder 0603 resistor/jumper between pads 1 and 2 for standard function. Solter resistor between pads 2 and 3 for alternative function | R86, R88, R90, R92, R94, R96, R185, R186, R187, R191, R192, R193 |  | 0603_Config | R_config | 12 | 0R |  |  |  | Farnell |  | 2447230
24.9k |  | R104 |  | RESC1608X06N | R_0603 | 1 | 24.9k |  |  |  | Mouser |  | 71-CRCW060324K9FKEAC
3.01k |  | R105 |  | RESC1608X06N | R_0603 | 1 | 3.01k |  |  |  | Mouser |  | 71-CRCW060324K9FKEAC
1.3k |  | R106 |  | RESC1608X06N | R_0603 | 1 | 1.3k |  |  |  | Mouser |  | 71-CRCW060324K9FKEAC
15k |  | R127, R133 |  | RESC1608X06N | R_0603 | 2 | 15k |  |  |  | Mouser |  | 71-CRCW06030000Z0EAC
7.5k |  | R130 |  | RESC1608X06N | R_0603 | 1 | 7.5k |  |  |  | Mouser
VCC | Testpoint 1mm | TP1, TP2, TP3, TP4, TP5, TP6, TP7, TP8, TP9, TP10, TP11, TP12, TP13, TP15, TP16, TP19, TP21, TP22 |  | TP_1mm |  | 18 | Testpoint 1mm
VIN | Testpoint 1mm | TP14 |  | TP_1mm |  | 1 | Testpoint 1mm
OVCC | Testpoint 1mm | TP17 |  | TP_1mm |  | 1 | Testpoint 1mm
VREF | Testpoint 1mm | TP18 |  | TP_1mm |  | 1 | Testpoint 1mm
VCOM | Testpoint 1mm | TP20 |  | TP_1mm |  | 1 | Testpoint 1mm
AD8662ARZ | IC OPAMP GP 2 CIRCUIT 14SOIC | U1 |  | SOIC8_N | AD8662 | 1 |  |  |  |  | Mouser | Digi-Key | 584-AD8662ARZ | AD8662ARZ-ND
THS4524 |  | U2 |  | TSSOP38 | THS4521 | 1 |  |  |  |  | Farnell | Mouser | 2496350 | 595-THS4524IDBTR
LT1639HS#PBF | IC OPAMP GP 4 CIRCUIT 14SO | U3 |  | SOIC-14 | LT1639 | 1 |  |  |  |  | Mouser | Digikey | 584-LT1639HS#PBF | LT1639HS#PBF-ND
SN74LV4T125PWR | Single Power Supply Quadruple Buffer GATE w/ 3-State Output CMOS Logic Level Shifter, PW0014A, LARGE T&R | U4, U10 |  | PW0014A_N | SN74LV4T125PWR | 2 |  |  |  |  | Mouser | Digi-Key | 595-SN74LV4T125PWR | 296-40545-1-ND
AM26C32MDREP | Logic Differential to Single Ended | U5, U12 |  | SOIC-16 | Differential Receiver | 2 |  |  |  |  | Mouser | Digi-Key | 595-AM26C32MDREP | 296-23458-1-ND
LTC2311 | 16 Bit SAR ADC, 5MSps | U6A, U6B, U6C, U6D |  | LTC2311-16 | LTC2311-16 | 4 |  |  |  |  | Mouser | Digi-Key | 584-C2311CMSE-16PBF | LTC2311CMSE-16#PBF-ND
LM5007 | Buck Converter, 9-75Vin, 2.5-73Vout | U7 |  | TSOP65P490X110-8N | LM5007 | 1 |  |  |  |  | Farnell | Mouser | 9779345 | 926-LM5007MM/NOPB
TLV741P | 150mA, 2.5V LDO | U8 |  | SOT95P250X110-5N | TLV741P | 1 |  |  |  |  | Mouser | Digi-Key | 595-TLV74125PDBVR | 296-49999-1-ND
LT6654 |  | U9, U11 |  | SOT95P280X100-6N | LT6654 | 2 |  |  |  |  | Farnell | Mouser | 2761960 | 584-6654BIS65TRMPBF, 584-6654BIS625TRMPBF
AD2S1210 | Variable Resolution, 10-Bit to 16-Bit R/D Converter with Reference Oscillator | U15 |  | LQFP-48_L | AD2S1210 | 1 | AD2S1210 |  |  |  | Mouser | Digi-Key | 584-AD2S1210WDSTZR7 | AD2S1210WDSTZRL7CT-ND
LT6203 | IC OPAMP GP 2 CIRCUIT 8MSOP | U18, U19, U20, U21 |  | 8-MSOP | LT6203 | 4 |  |  |  |  | Mouser | Digi-Key | 584-LT6203CMS8#PBF | LT6203CMS8#PBF-ND
SN75HVD08DR | IC TRANSCEIVER HALF 1/1 8SOIC | U22, U23 |  | SOIC8_N | Transmisor RS485 | 2 |  |  |  |  | Mouser | Digi-Key | 595-SN75HVD08DR | 296-37893-1-ND
TXB0106PWR | Level shifter bidirectional 6 channels | U24 |  | TSSO5x6-G16 | Level Shifter 1.8V/3.3V | 1 |  |  |  |  | Mouser | Digi-Key | 595-TXB0106PWR | 296-23759-1-ND
PDS1-S24-S12-M-TR | DC DC CONVERTER 12V 1W | U27 |  | DC/DC 24V-->12V 1W Aislado | DC/DC +12V 1W | 1 |  |  |  |  | Mouser | Digi-Key | 490-PDS1S24S12MTR | 102-3406-1-ND
IPL1-104-01-L-D-RA-K | CONN HEADER R/A 8POS 2.54MM Through Hole | X1, X3, X4, X14, X15 |  | Conector 4x2 TH Horizontal | Conector 4x2 Horizontal | 5 |  |  |  |  | Mouser | Digi-Key | 200-IPL110401LDRAK | SAM9596-ND
IPL1-102-01-L-D-RA-K | CONN HEADER R/A 4 POS 2.54MM Through Hole | X2 |  | Conector 2x2 TH Horizontal | Conector 2x2 Horizontal | 1 |  |  |  |  | Mouser | Digi-Key | 200-IPL110201LDRAK | SAM8823-ND
IPL1-103-01-L-D-RA-K | CONN HEADER R/A 6 POS 2.54MM Through Hole | X5 |  | Conector 3x2 TH Horizontal | Conector 3x2 Horizontal | 1 |  |  |  |  | Mouser | Digi-Key | 200-IPL110301LDRAK | SAM9096-ND
Header 6X2 | Header, 6-Pin, Dual row | X6 |  | HDR2X6 | Header 6X2 | 1
IPL1-102-01-S-S-RA-K | CONN HEADER R/A 2POS 2.54MM Through Hole | X7 |  | Conector 1x2 TH Horizontal | Conector 1x2 Horizontal | 1 |  |  |  |  | Mouser | Digi-Key | 200-IPL110201SSRAK | SAM12667-ND
Header 8X2 | Header, 8-Pin, Dual row | X8, X12 |  | HDR2X8 | Header 8X2 | 2
Header 8 | Header, 8-Pin | X9 |  | HDR1X8 | Header 8 | 1
Header 3X2 | Header, 3-Pin, Dual row | X10, X11, X13 |  | HDR2X3 | Header 3X2 | 3
615008140621 | Modular Jack WR-MJ, Tab Up, Shielded, with EMI Panel Finger, Horizontal Entry, THT, 8P8C | X17 |  | 615008140621 | 615008140621 | 1 |  |  |  |  | Mouser | Digi-Key | 710-615008140621 | 732-2742-ND
ECS-80-18-30B-AGN-TR | CRYSTAL 8MHZ 18PF SMD | XT1 |  | CRYSTALOSC | Crystal_8MHz | 1 |  |  |  |  | Mouser | Digi-Key | 520-80-18-30B-AGNT | XC2709CT-ND
Beide PGA nicht in stock
