ultrazohm/uz_d_encoder/new 3D steps/IPS1-105-01-L-D-RA.stp

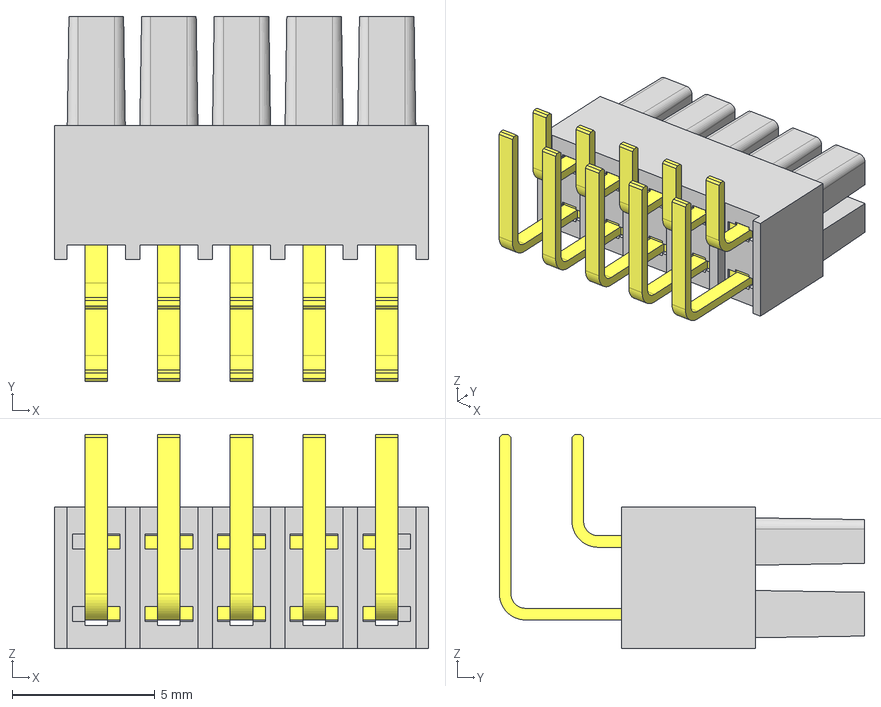
[picture p3: CAD file, 2020-08-25]
new 3D steps/IPS1-105-01-L-D-RA.stp
13.1 x 12.8 x 7.49 mm
_IPS1-105-01-L-D-RAt
_IPS1-105-01-D-RA_pin
