ultrazohm/uz_d_encoder/new 3D steps/Conector 5x2 TH Horizontal - IPL1-105-01-L-D-RA-K.stp

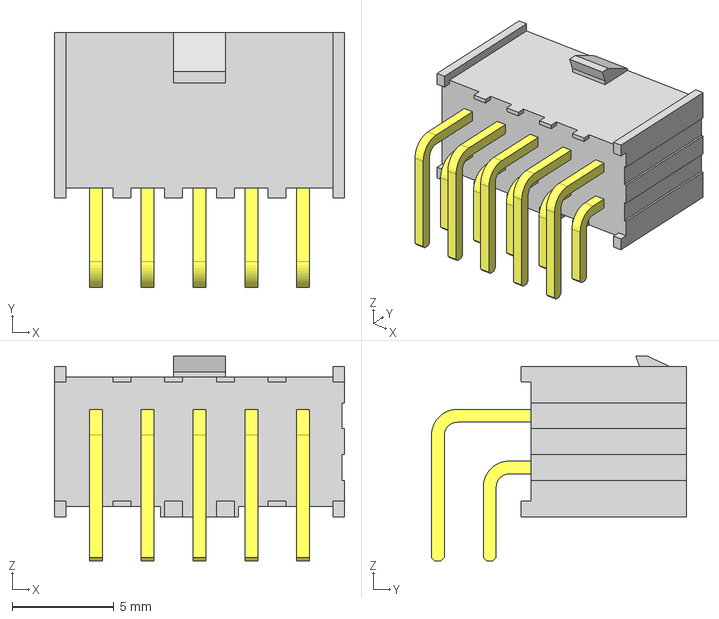
[picture p5: CAD file, 2020-08-25]
new 3D steps/Conector 5x2 TH Horizontal - IPL1-105-01-L-D-RA-K.stp
14.2 x 12.5 x 10.0 mm
_IPL1-105-01-D-RA-K_header
_T-1S64-01-05-D-RA
