ultrazohm/uz_d_encoder/new 3D steps/IPD1-04-D-K.stp

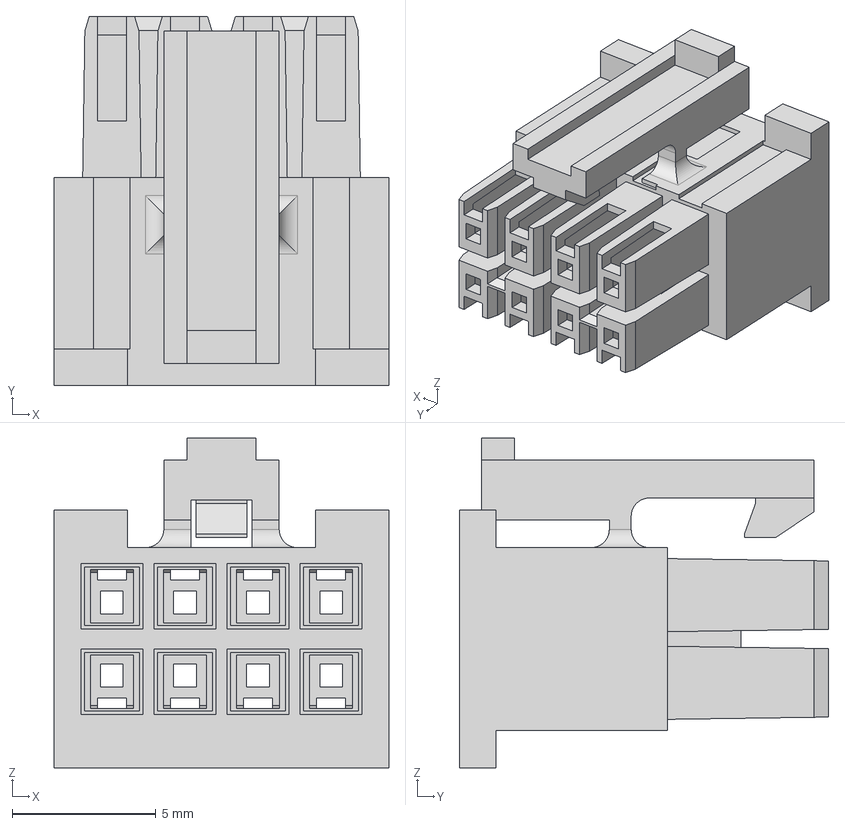
[picture p6: CAD file, 2020-08-25]
new 3D steps/IPD1-04-D-K.stp
11.6 x 12.8 x 11.5 mm
