ultrazohm/uz_d_encoder/new 3D steps/Conector 3x2 TH Horizontal - IPL1-103-01-L-D-RA-K.stp

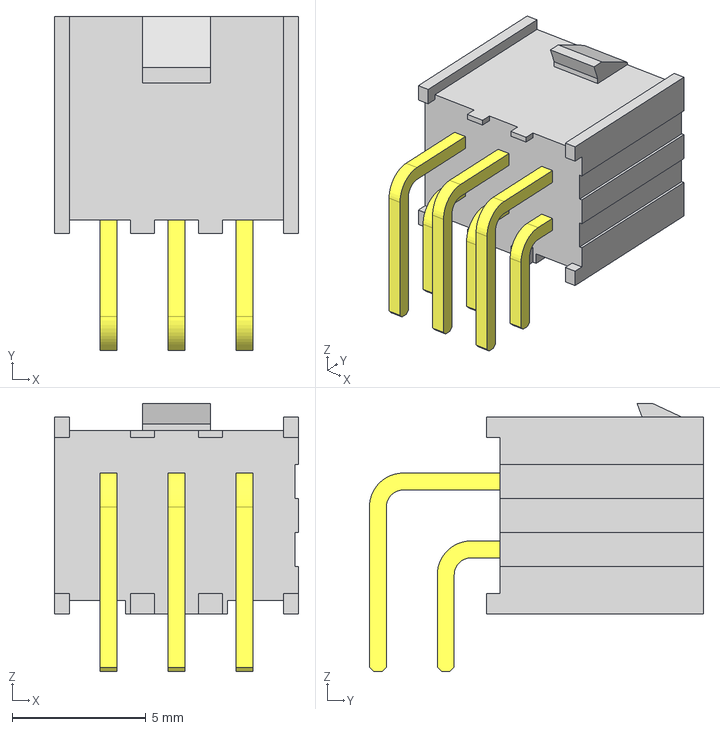
[picture p7: CAD file, 2020-08-25]
new 3D steps/Conector 3x2 TH Horizontal - IPL1-103-01-L-D-RA-K.stp
9.14 x 12.5 x 10.0 mm
_IPL1-103-01-D-RA-K_header
_T-1S64-01-03-D-RA
