ultrazohm/uz_d_encoder/Testing/Absolute_Encoder_Test/TEK00000.PNG

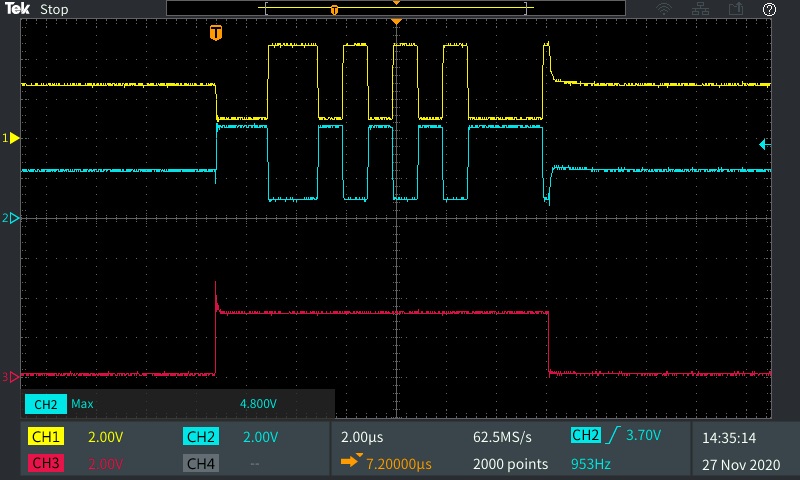
Testing/Absolute_Encoder_Test/TEK00000.PNG
