ultrazohm/uz_d_encoder/Testing/ADC_Test/ADC_Data_Plot.PNG

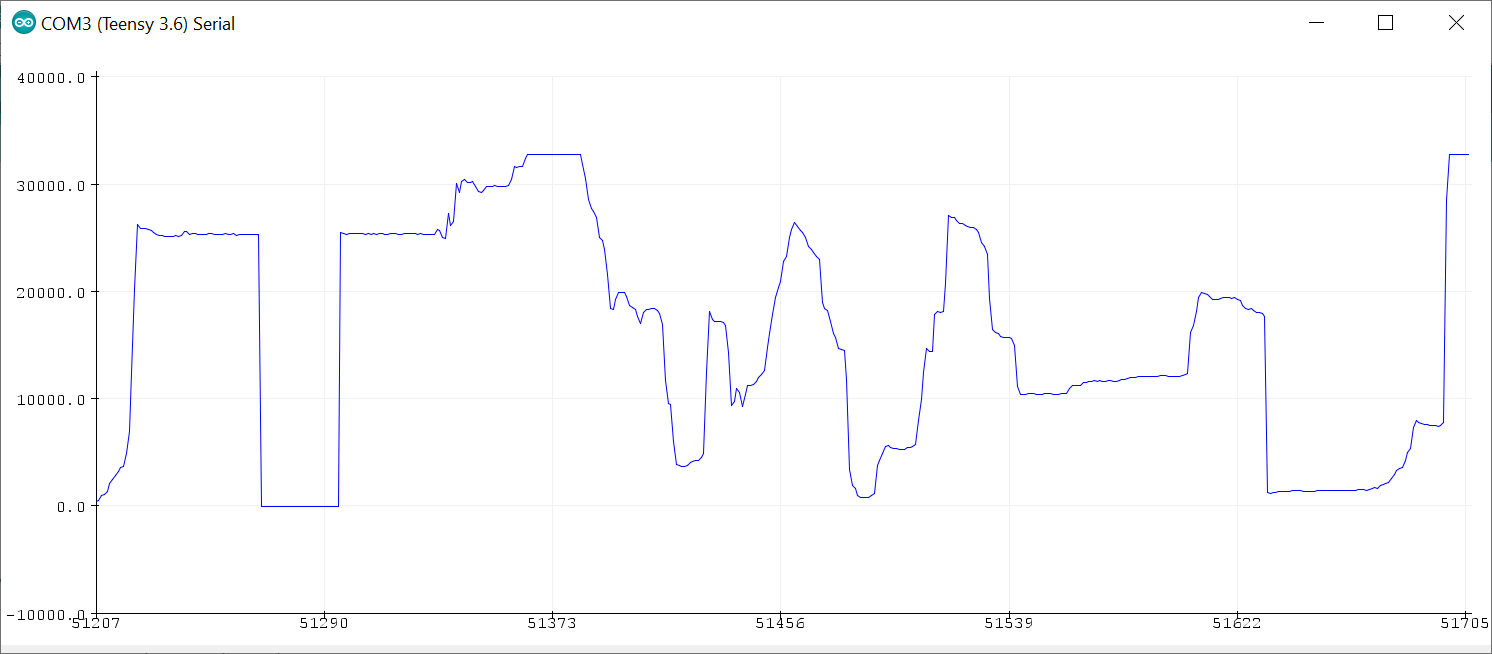
Testing/ADC_Test/ADC_Data_Plot.PNG
