ultrazohm/uz_d_encoder/Testing/ADC_Test/ADC_Data_Transmission_1.PNG

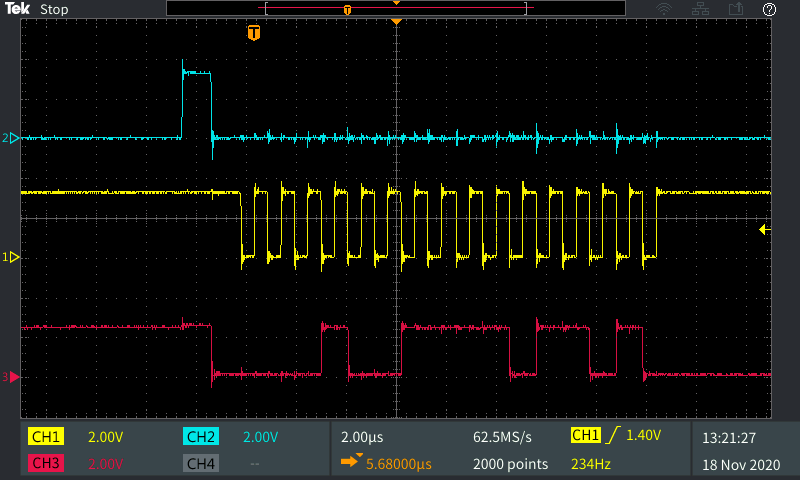
Testing/ADC_Test/ADC_Data_Transmission_1.PNG
