ultrazohm/uz_d_encoder/Testing/Incremental_Encoder_Test/Incremental_Encoder.PNG

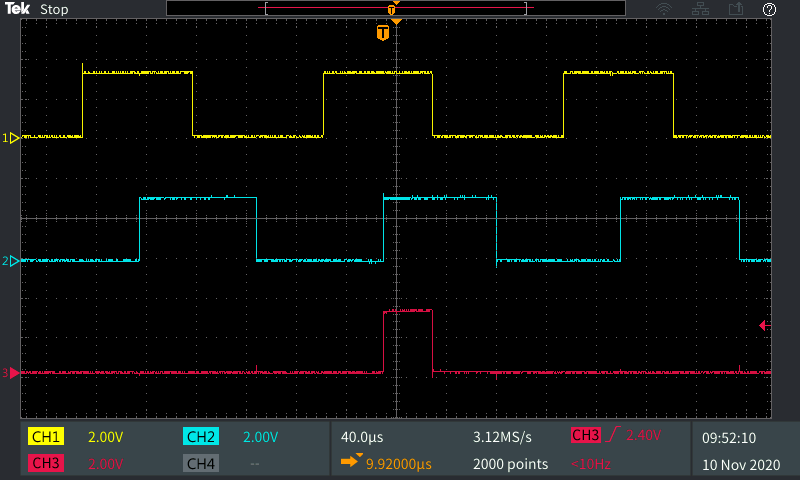
Testing/Incremental_Encoder_Test/Incremental_Encoder.PNG
