ultrazohm/uz_d_encoder/Testing/Pictures/20201110_152902.jpg

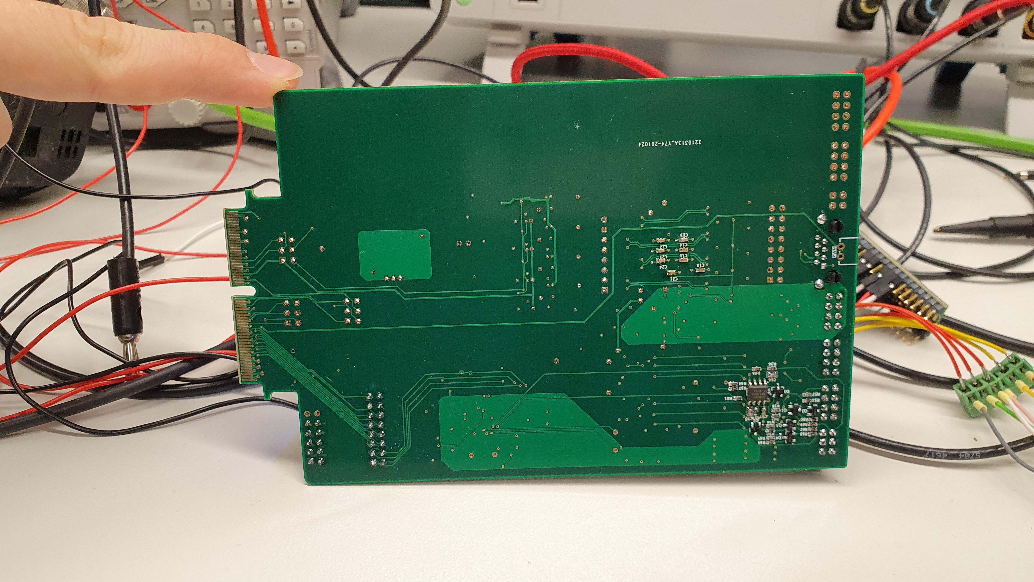
Testing/Pictures/20201110_152902.jpg
