ultrazohm/uz_d_encoder/Testing/Resolver_Test/Resolver_Emulated_Incremental_Encoder.PNG

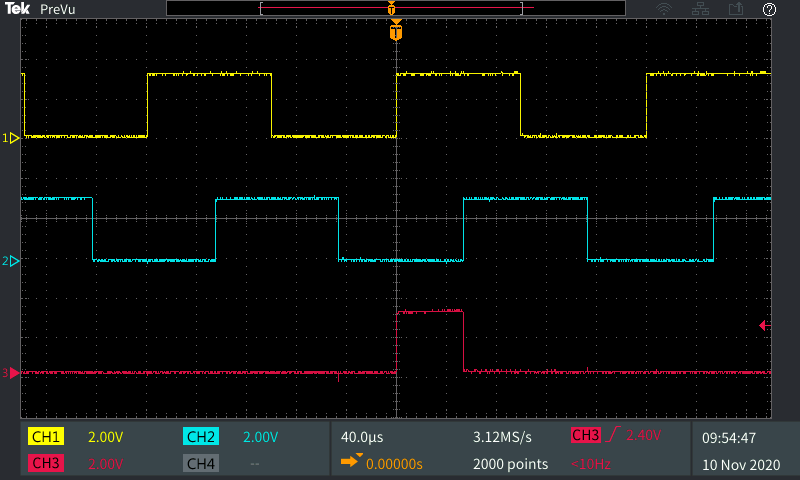
Testing/Resolver_Test/Resolver_Emulated_Incremental_Encoder.PNG
