ultrazohm/uz_d_encoder/IP-Core/Resolver/State_diagram.pdf

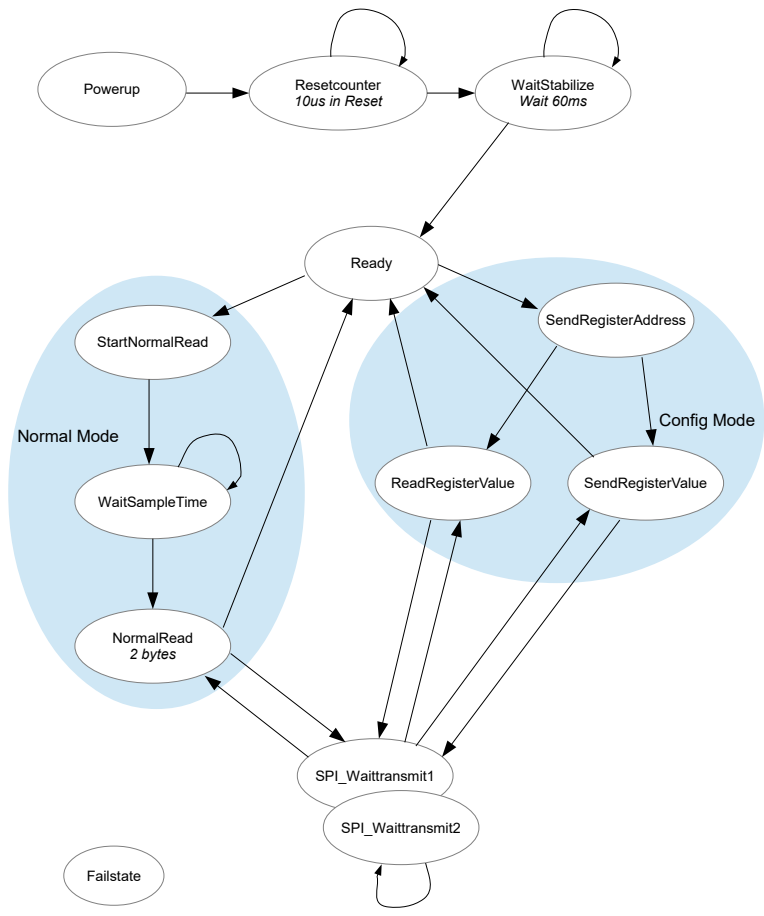
[picture p14: page 1]
Normal Mode; Config Mode; Powerup; Resetcounter; 10us in Reset; WaitStabilize Wait 60ms; Ready; StartNormalRead; WaitSampleTime; NormalRead 2 bytes; SendRegisterAddress; Failstate; SPI_Waittransmit1; SPI_Waittransmit2; ReadRegisterValue; SendRegisterValue
