ultrazohm/uz_d_encoder/Project Outputs for UZ_D_Encoder/Rev01/SCH_UltraZohm_Digital_Sensor_Board_1v01.PDF

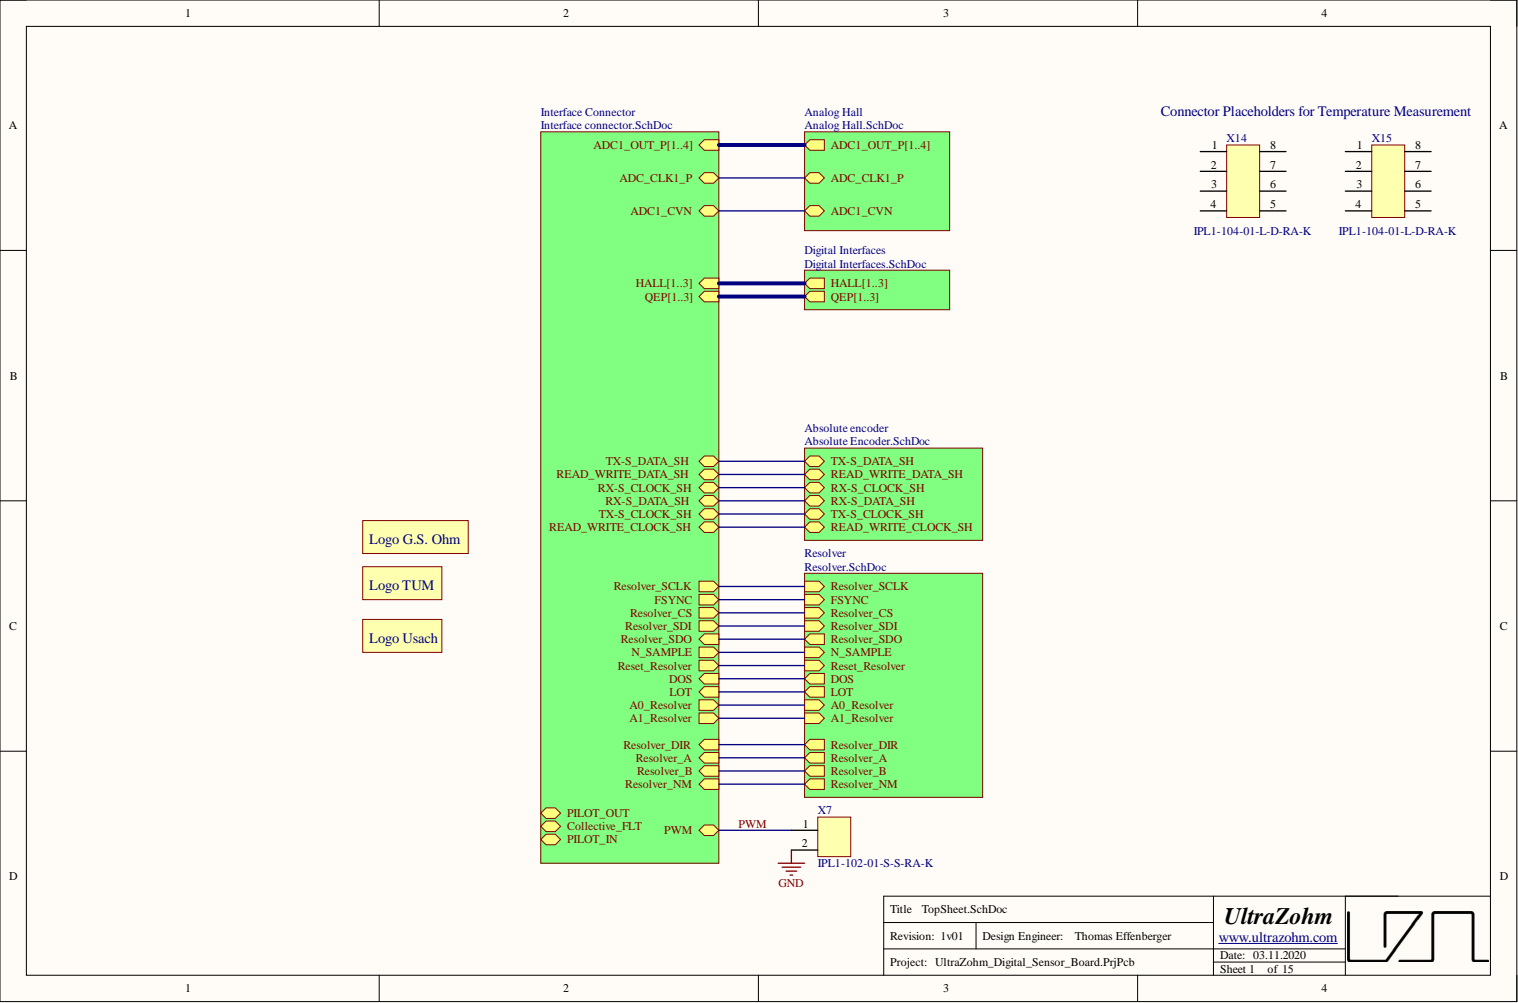
[picture p15: page 1]

Connector Placeholders for Temperature Measurement

Revision:

Date: 03.11.2020

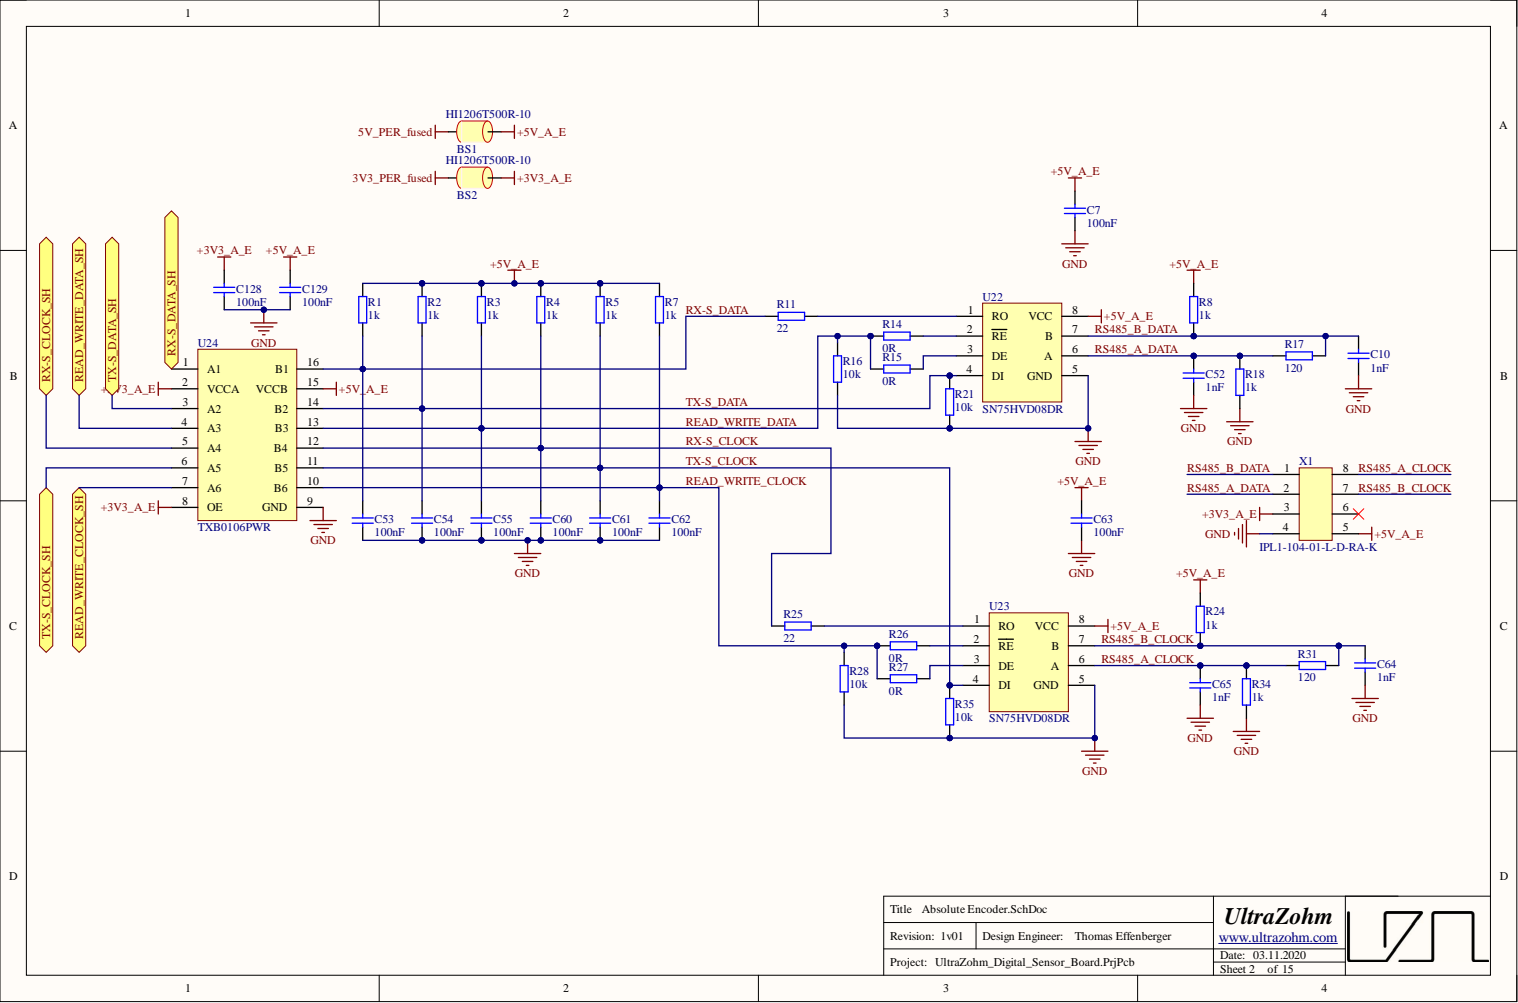
[picture p16: page 2]

T X-S_ D ATA

4 | | 1 3 | | | | | RE A D _ WRI T E _ D ATA
5 | | 1 2

1 1 | | | | | | T X-S_CL OCK

7 | | 1 0 | | | | | RE A D _ WRI T E _CL OCK

Rev i s i o n : v0 | Des i gn E n gi neer: T h o mas E ffen berger

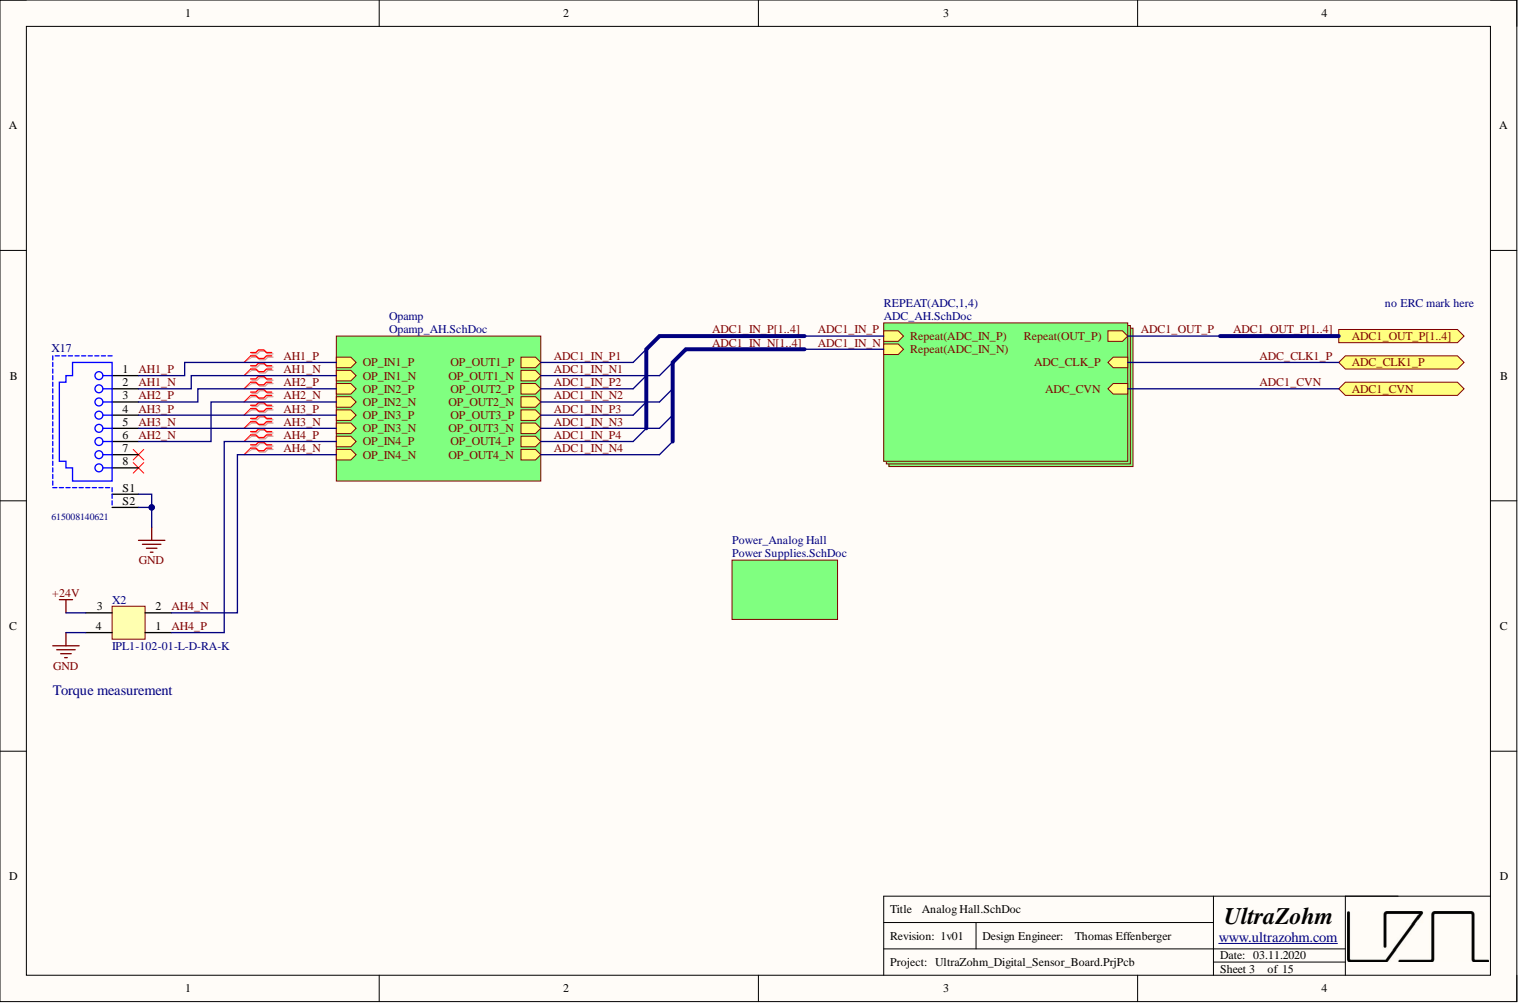
[picture p17: page 3]
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

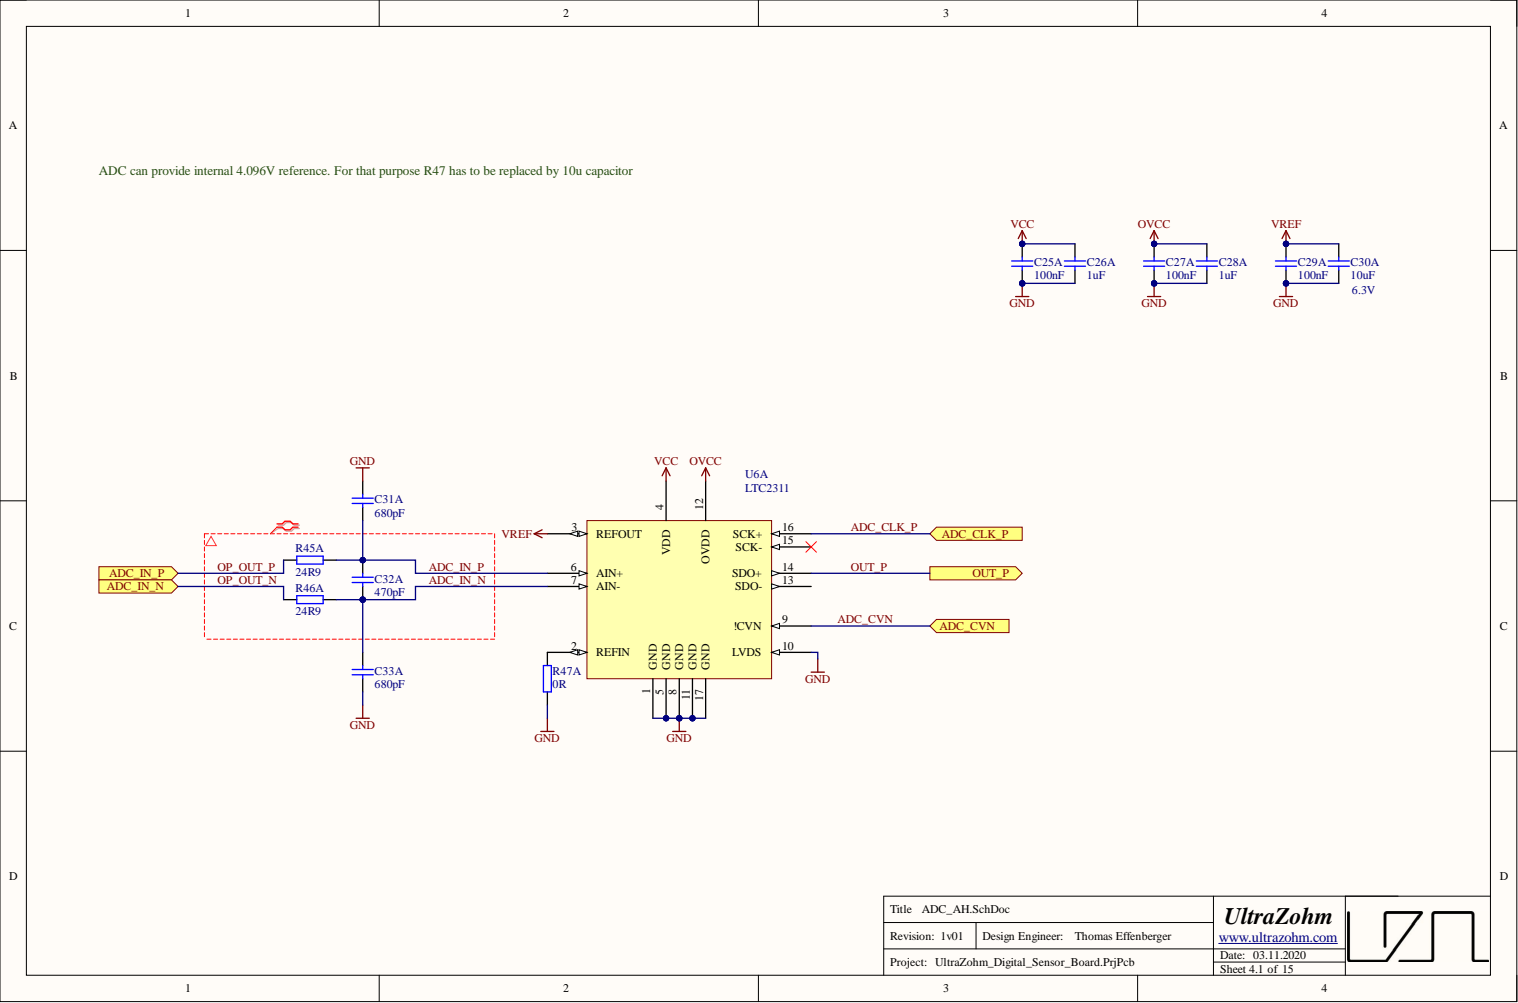
[picture p18: page 4]

ADC can provide internal 4.096V reference. For that purpose R47 has to be replaced by 10u capacitor

OP_OUT_P | | | ADC_IN_P
C32A OP_OUT_N ADC_IN_N | | AIN- 7

470pF | | | REFIN 2

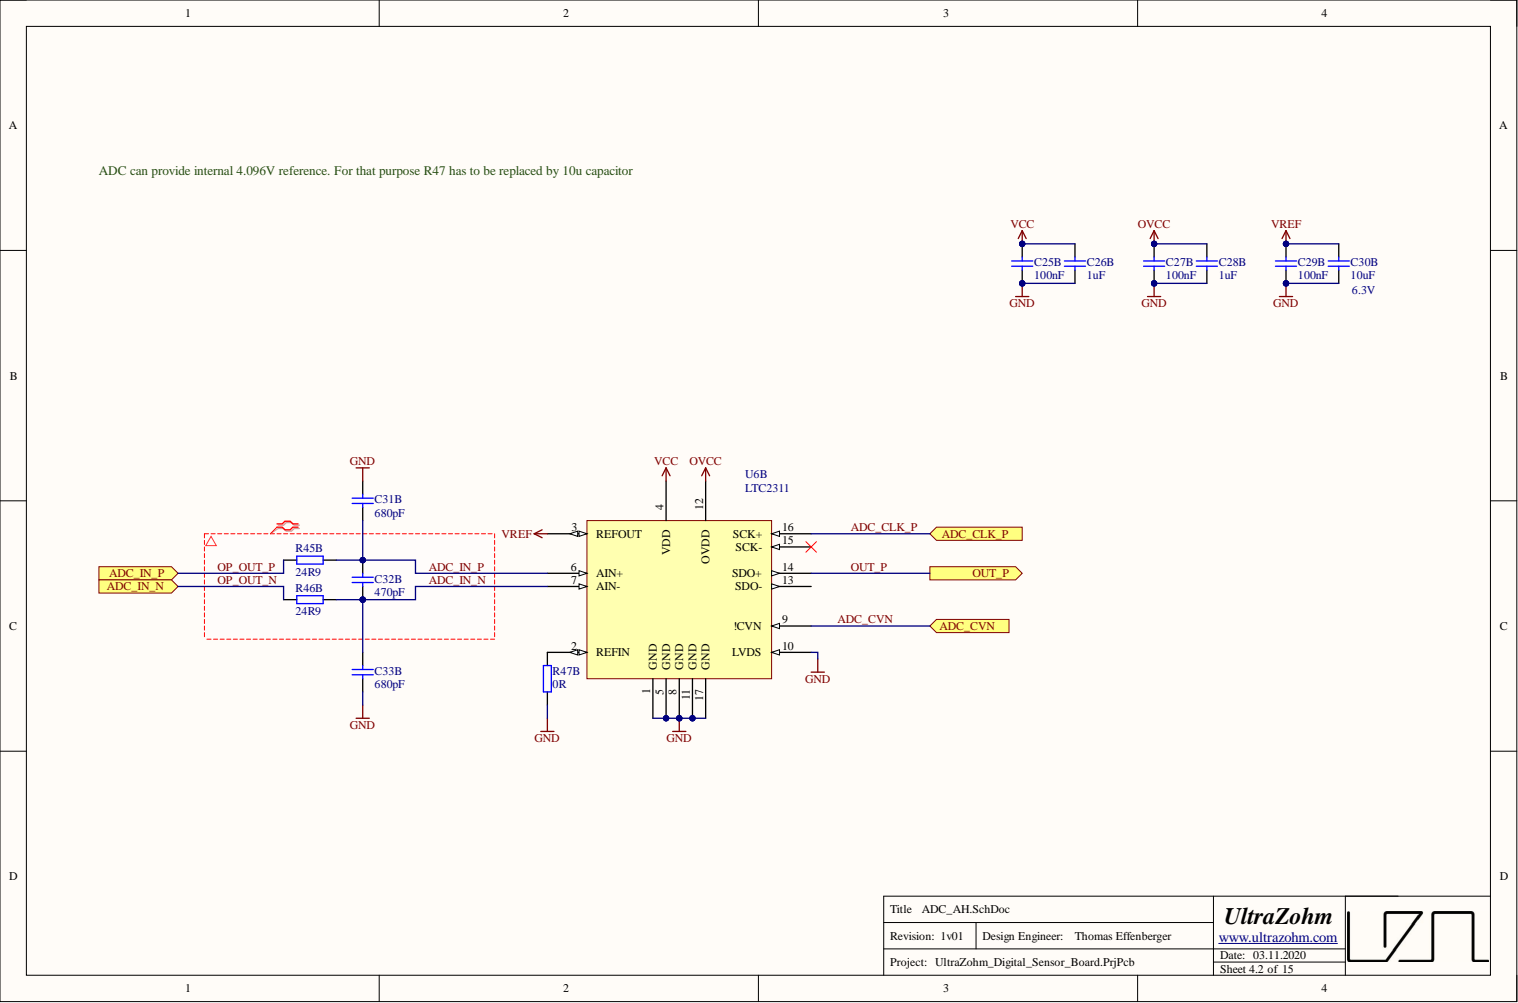
[picture p19: page 5]
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

OP_OUT_P | | | ADC_IN_P
C32B OP_OUT_N ADC_IN_N | | AIN- 7

470pF | | | REFIN 2

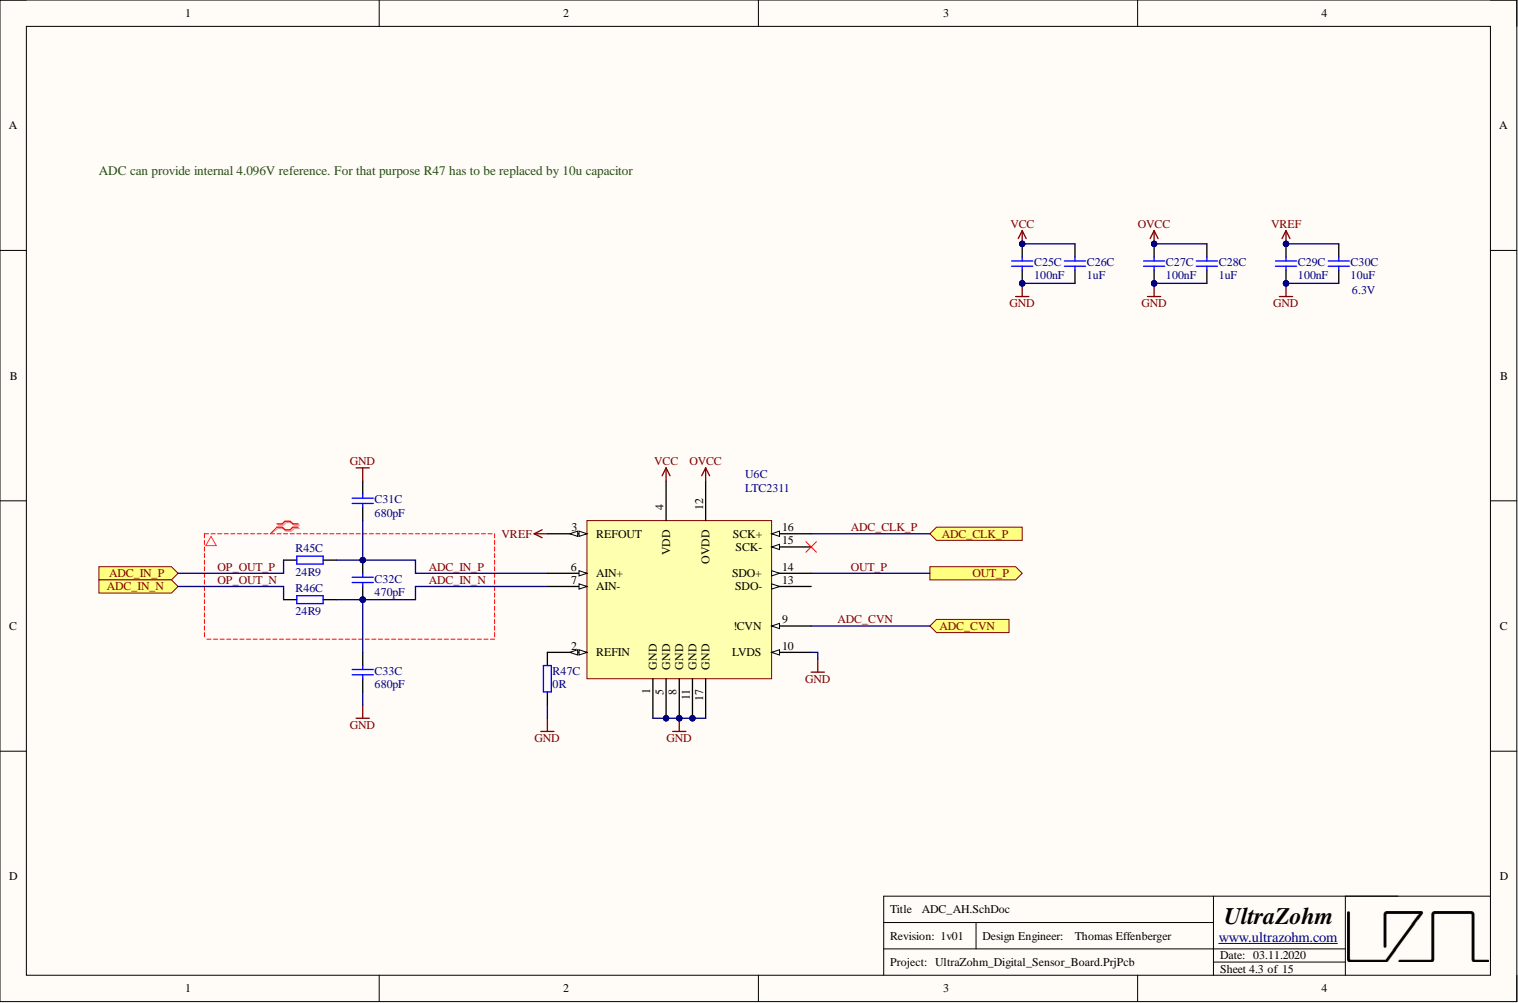
[picture p20: page 6]
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

OP_OUT_P | | | ADC_IN_P
C32C OP_OUT_N ADC_IN_N | | AIN- 7

470pF | | | REFIN 2

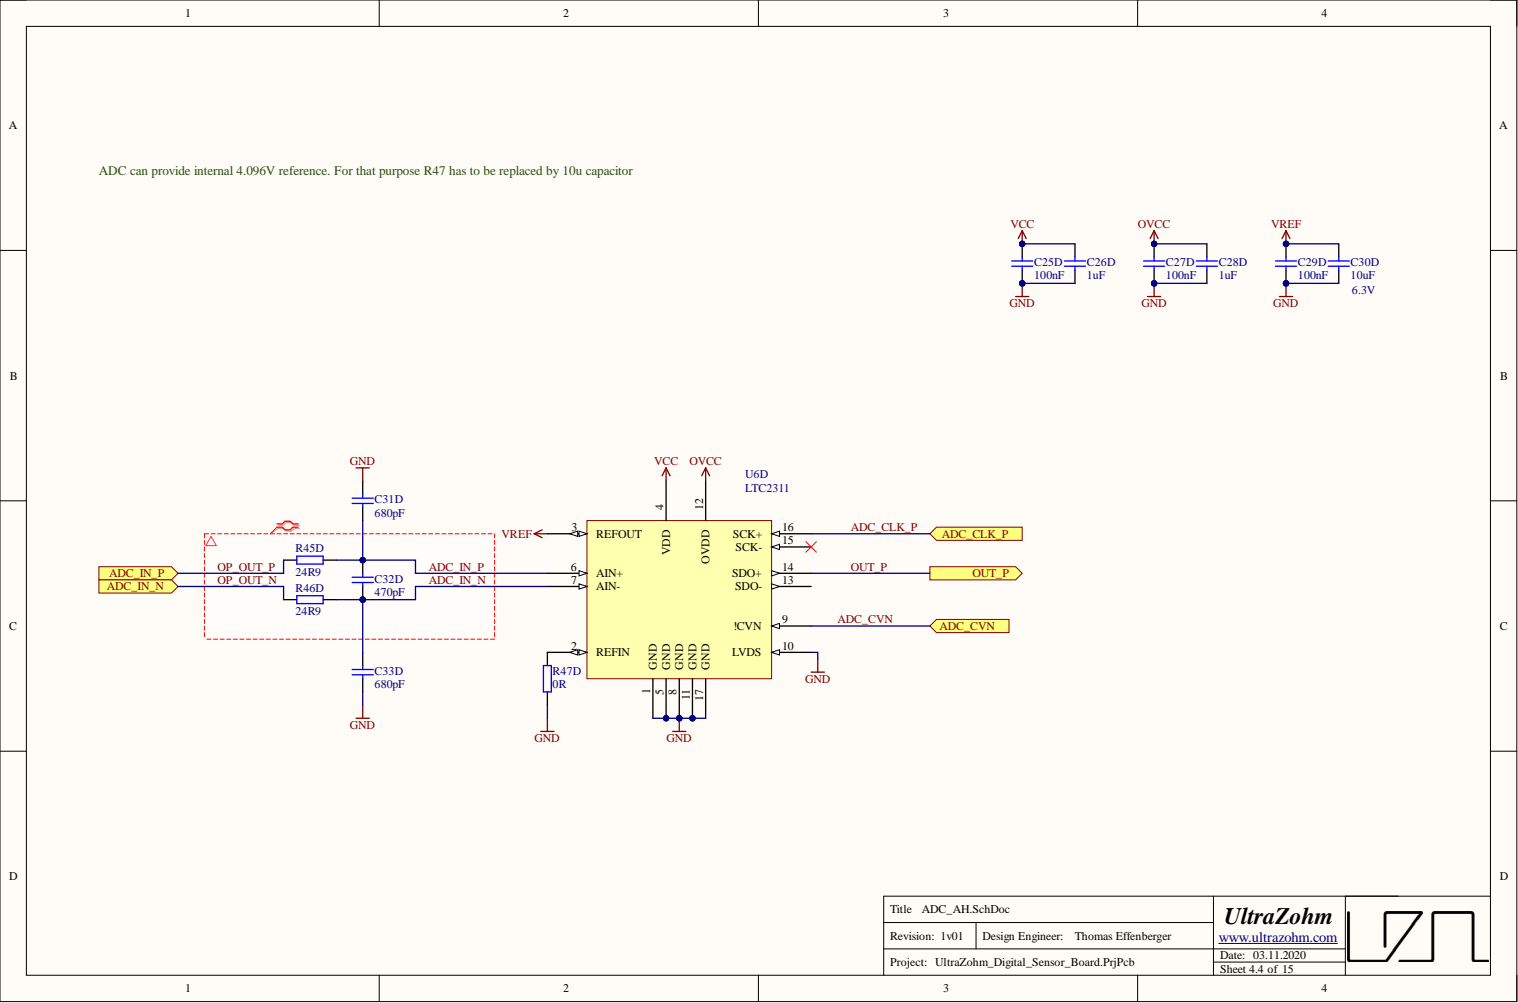
[picture p21: page 7]
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

OP_OUT_P | | | ADC_IN_P
C32D OP_OUT_N ADC_IN_N | | AIN- 7

470pF | | | REFIN 2

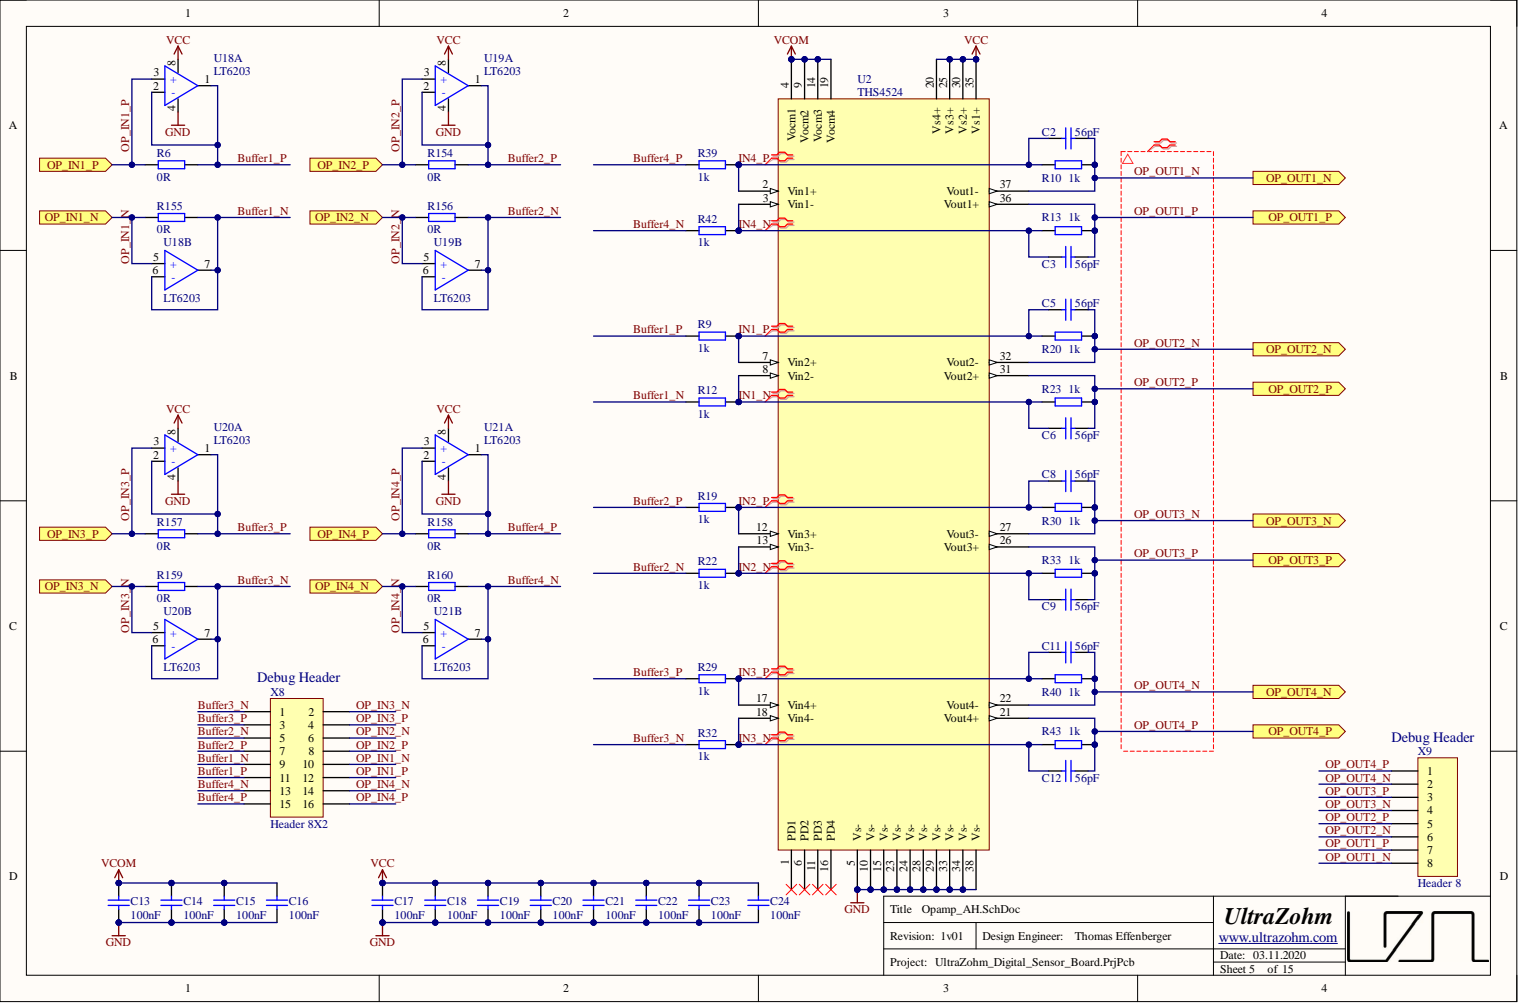
[picture p22: page 8]
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

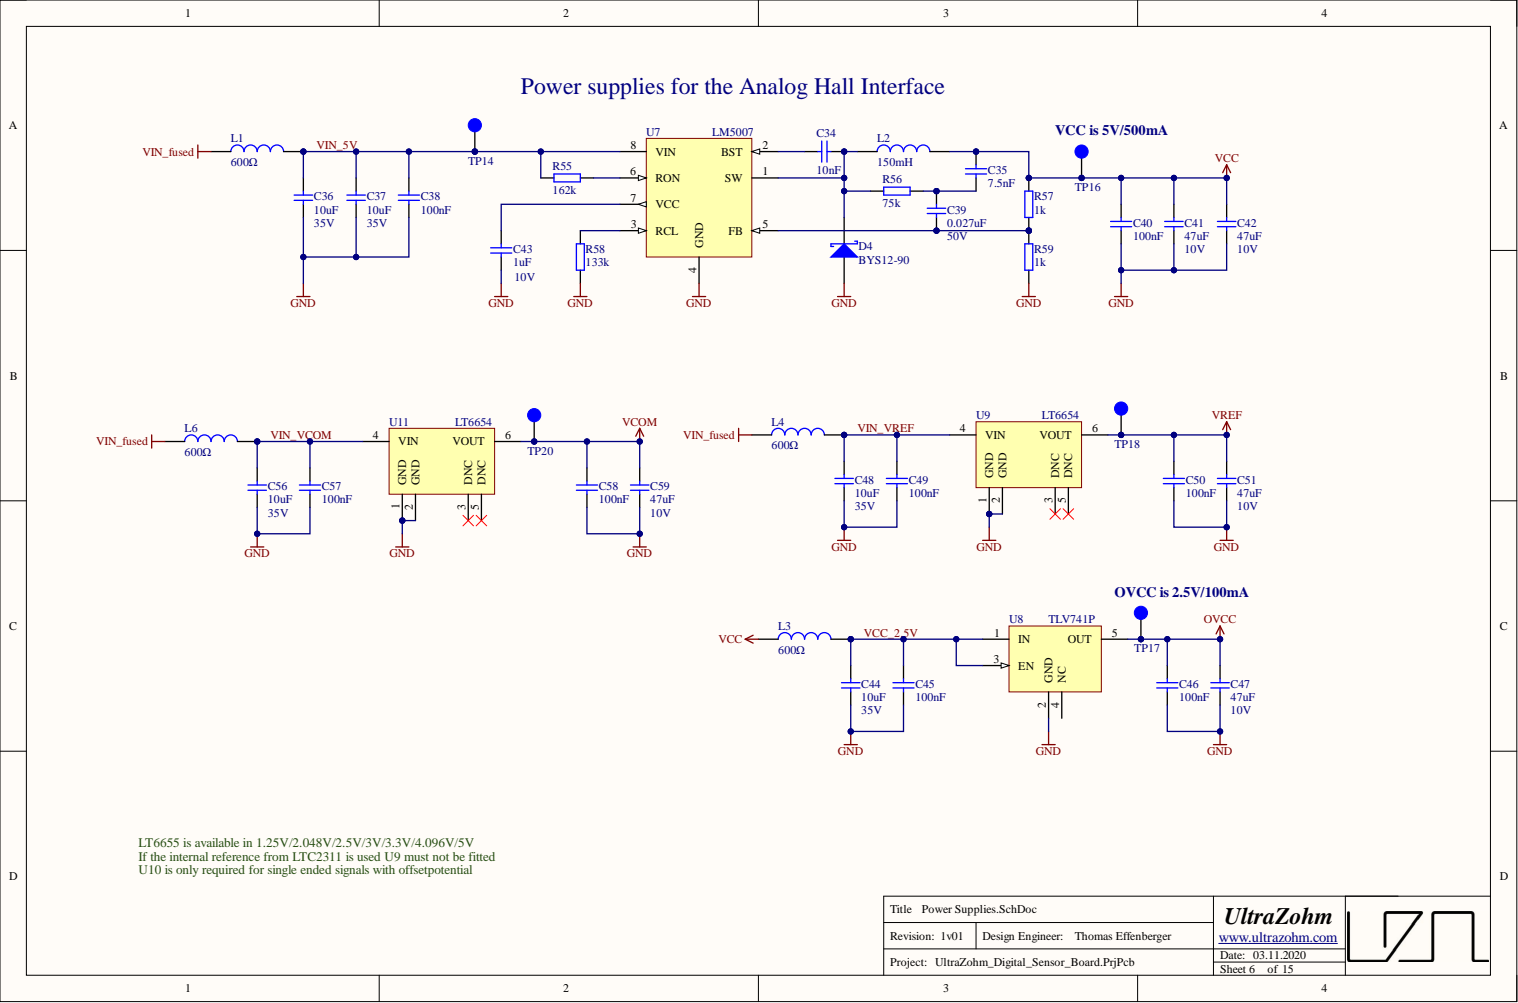
[picture p23: page 9]

Power supplies for the Analog Hall Interface

RCL 3

LT6655 is available in 1.25V/2.048V/2.5V/3V/3.3V/4.096V/5V
If the internal reference from LTC2311 is used U9 must not be fitted
U10 is only required for single ended signals with offsetpotential

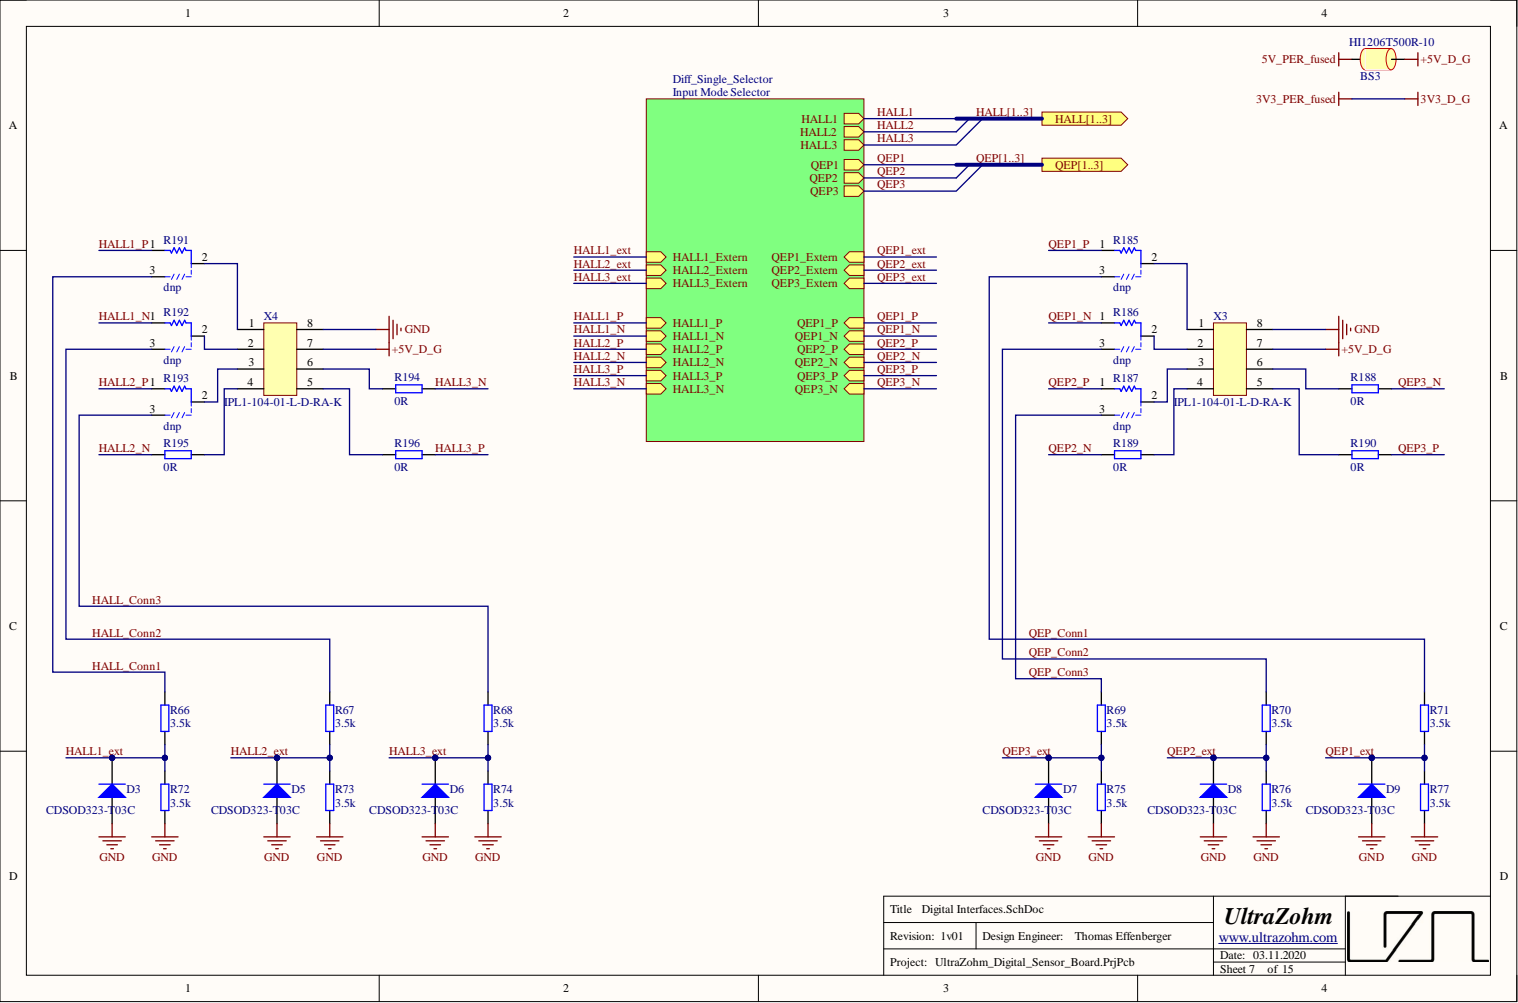
[picture p24: page 10]

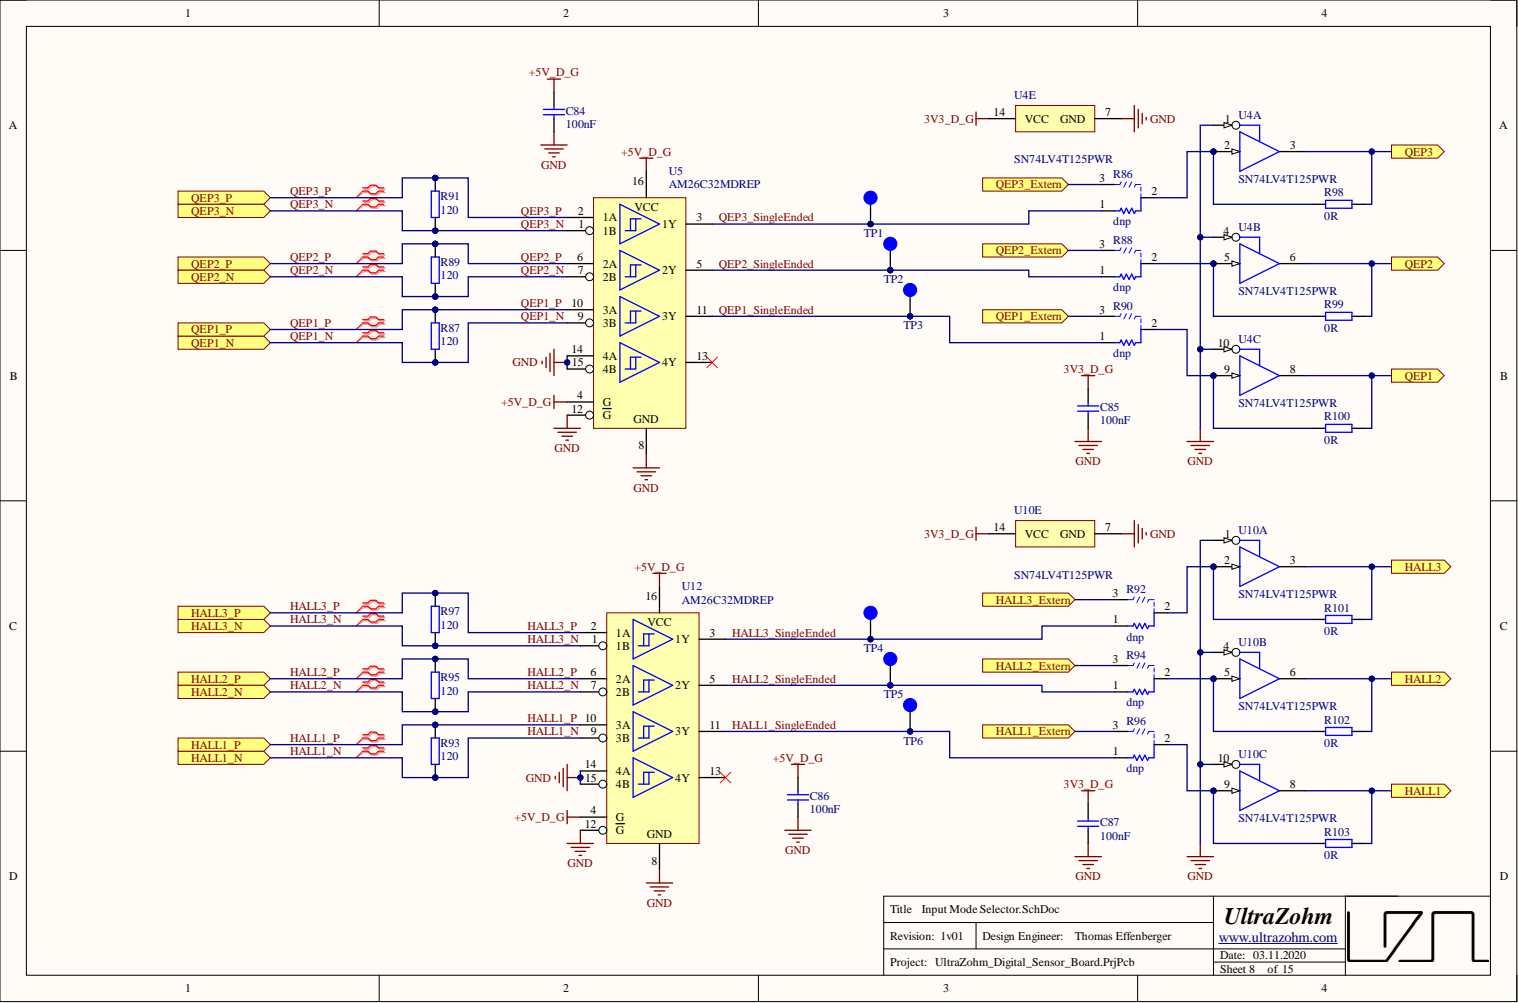
[picture p25: page 11]
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

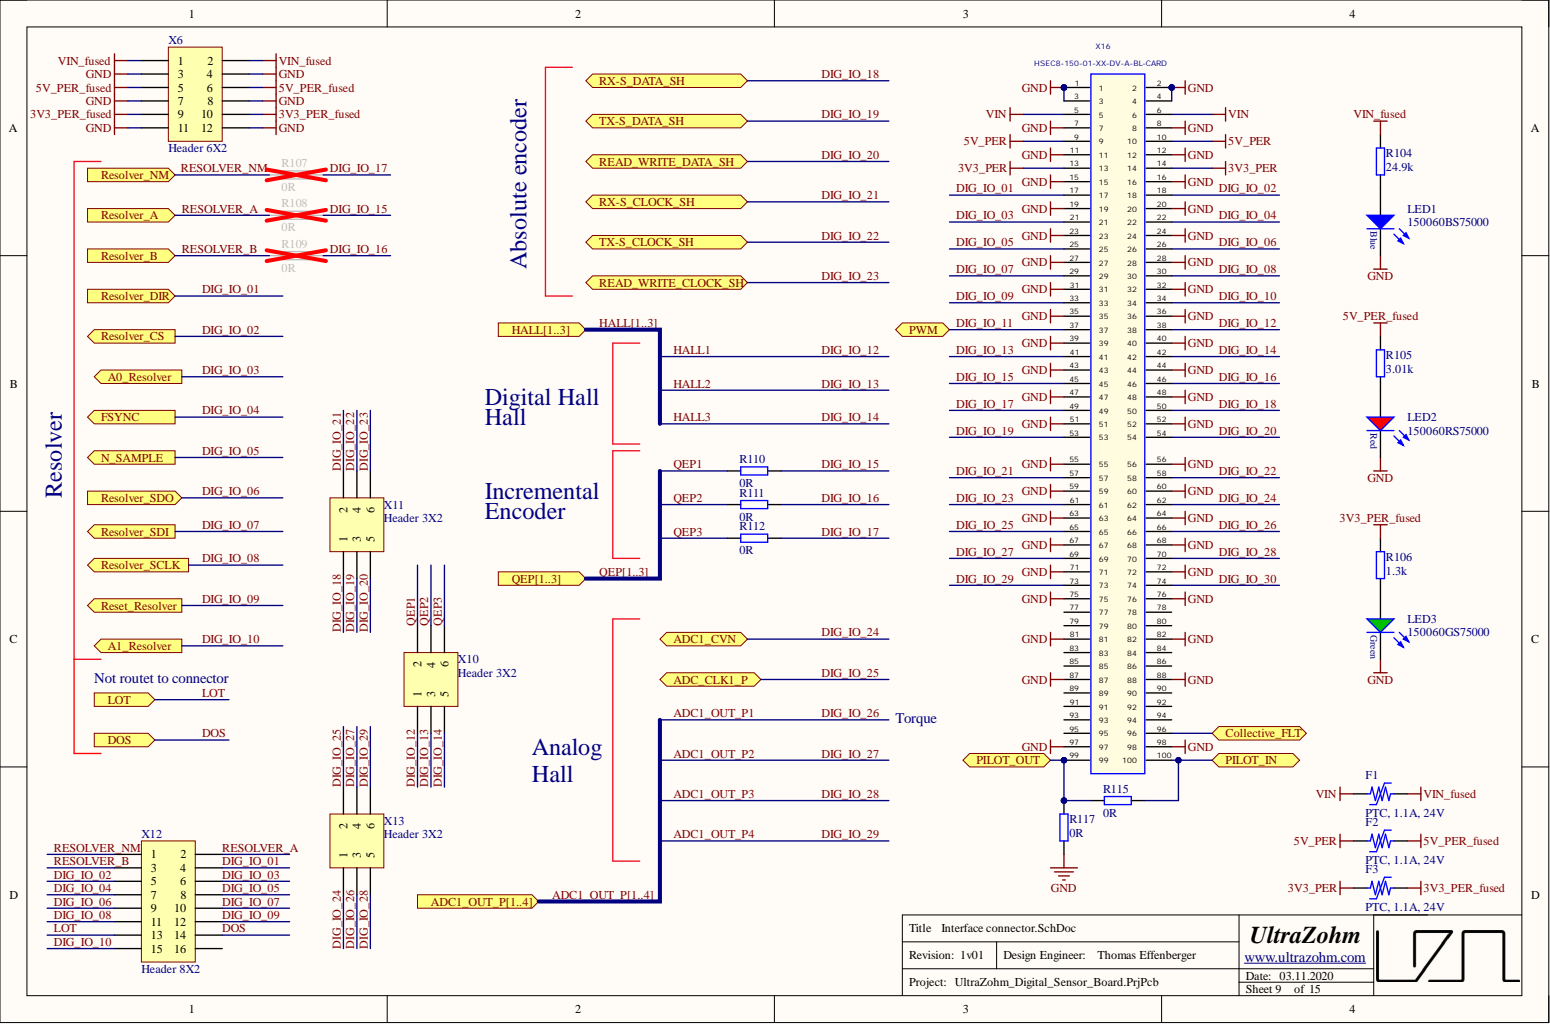
[picture p26: page 12]

HSEC8-150-01-XX-DV-A-BL-CARD

Not routet to connector

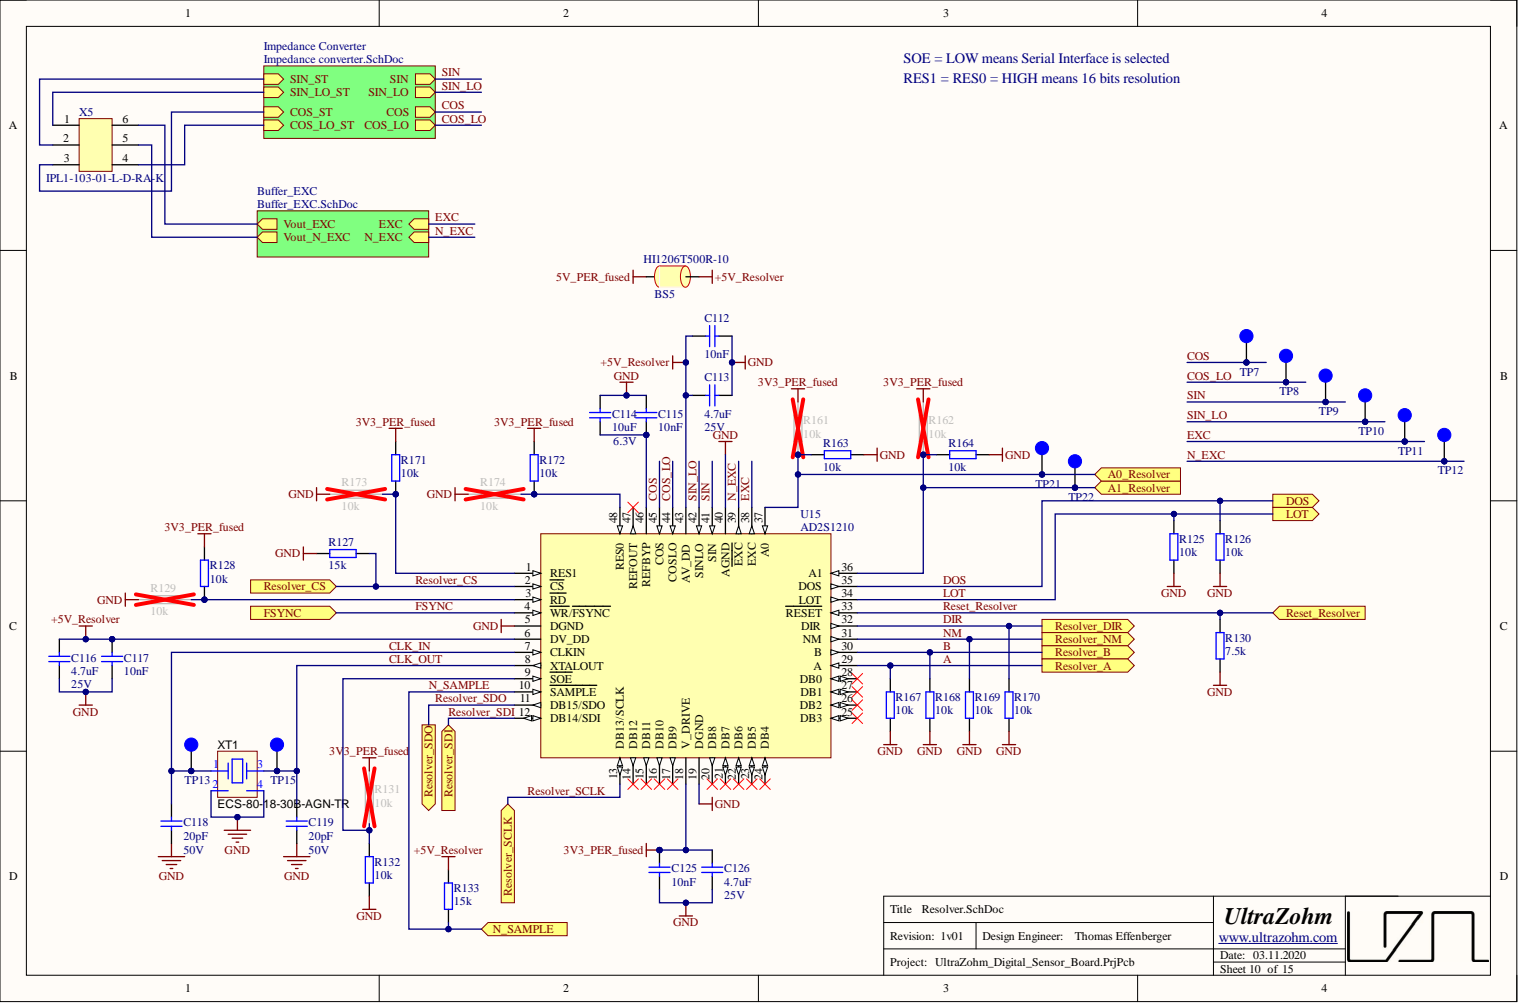
[picture p27: page 13]

SOE = LOW means Serial Interface is selected
RES1 = RES0 = HIGH means 16 bits resolution

A0 37 EXC 38 EXC 39 AGND 40 SIN 41 SINLO 42 AV_DD 43 COSLO 44 COS 45 REFBYP 46 REFOUT 47 RES0 48

CLK_IN | CLKIN 7 | B
CLK_OUT | | XTALOUT 8 | | A

SOE 9

Resolver_SDO | | DB15/SDO 11
Resolver_SDI | | DB14/SDI 12

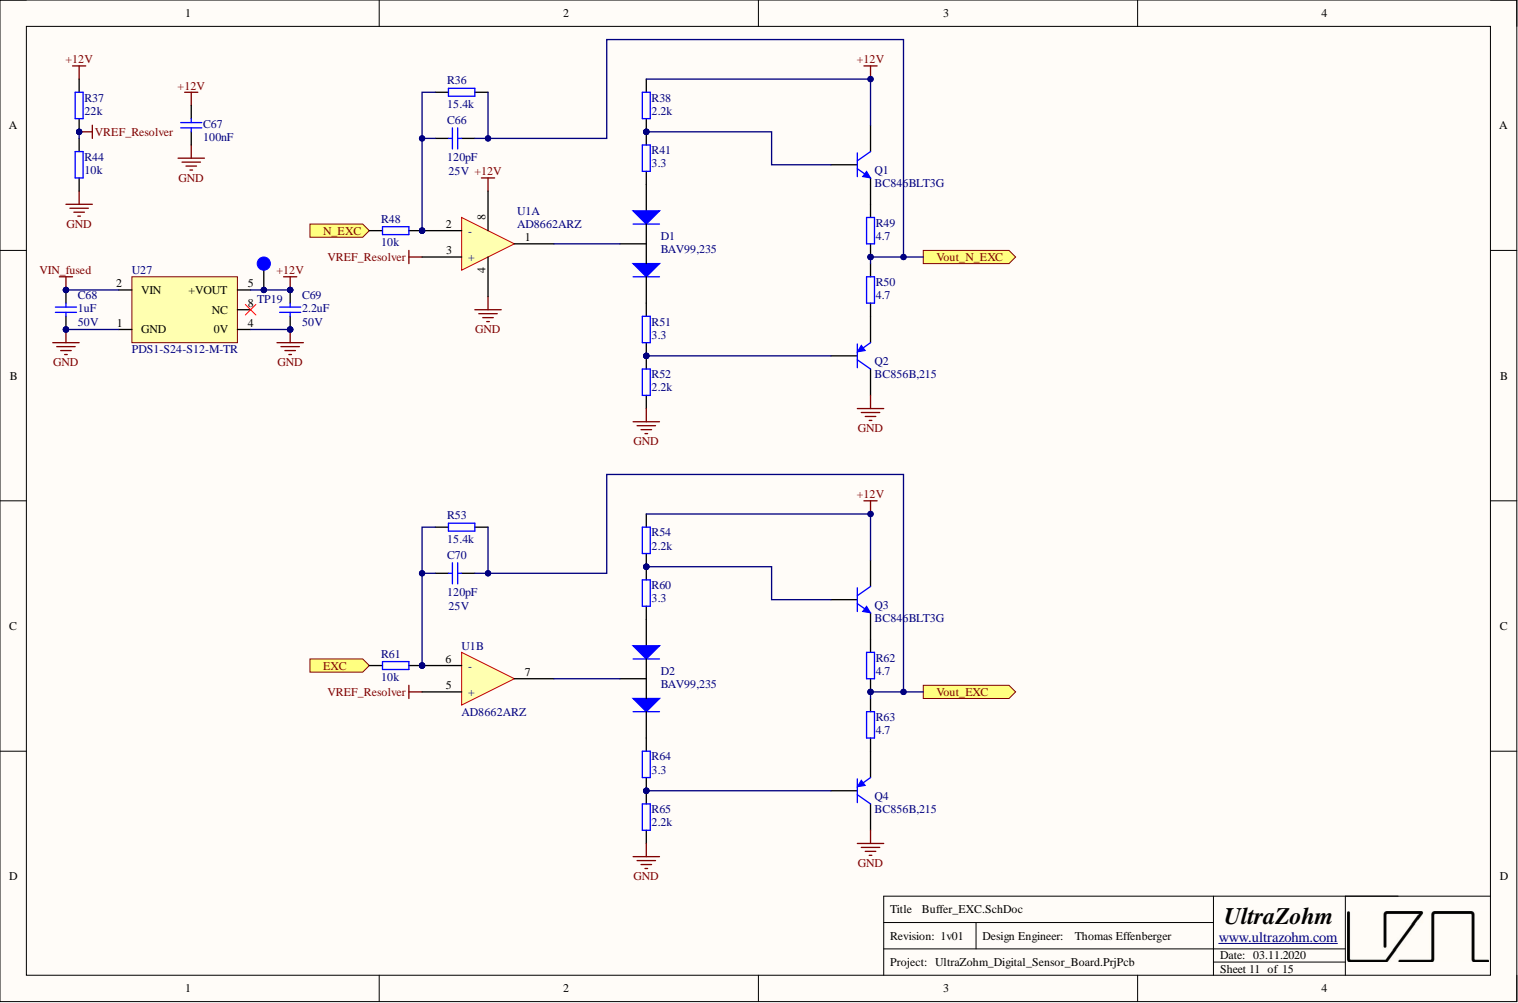
[picture p28: page 14]
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

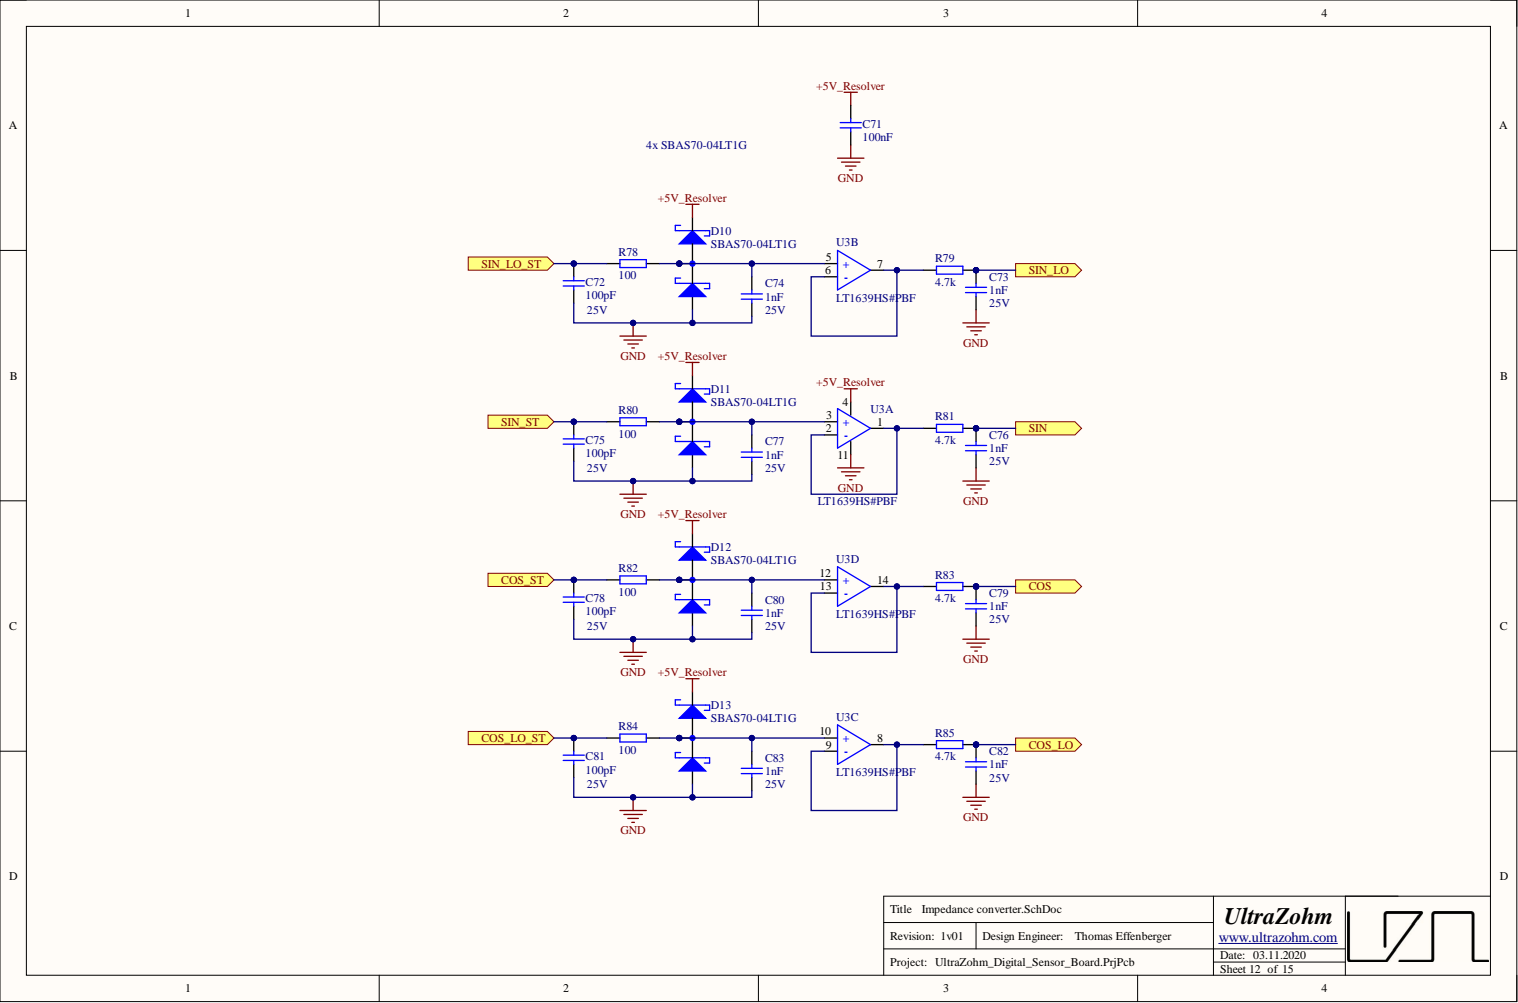
[picture p29: page 15]
