ultrazohm/uz_d_encoder/Project Outputs for UZ_D_Encoder/Rev01/ASM_UltraZohm_Digital_Sensor_Board_1v01.PDF

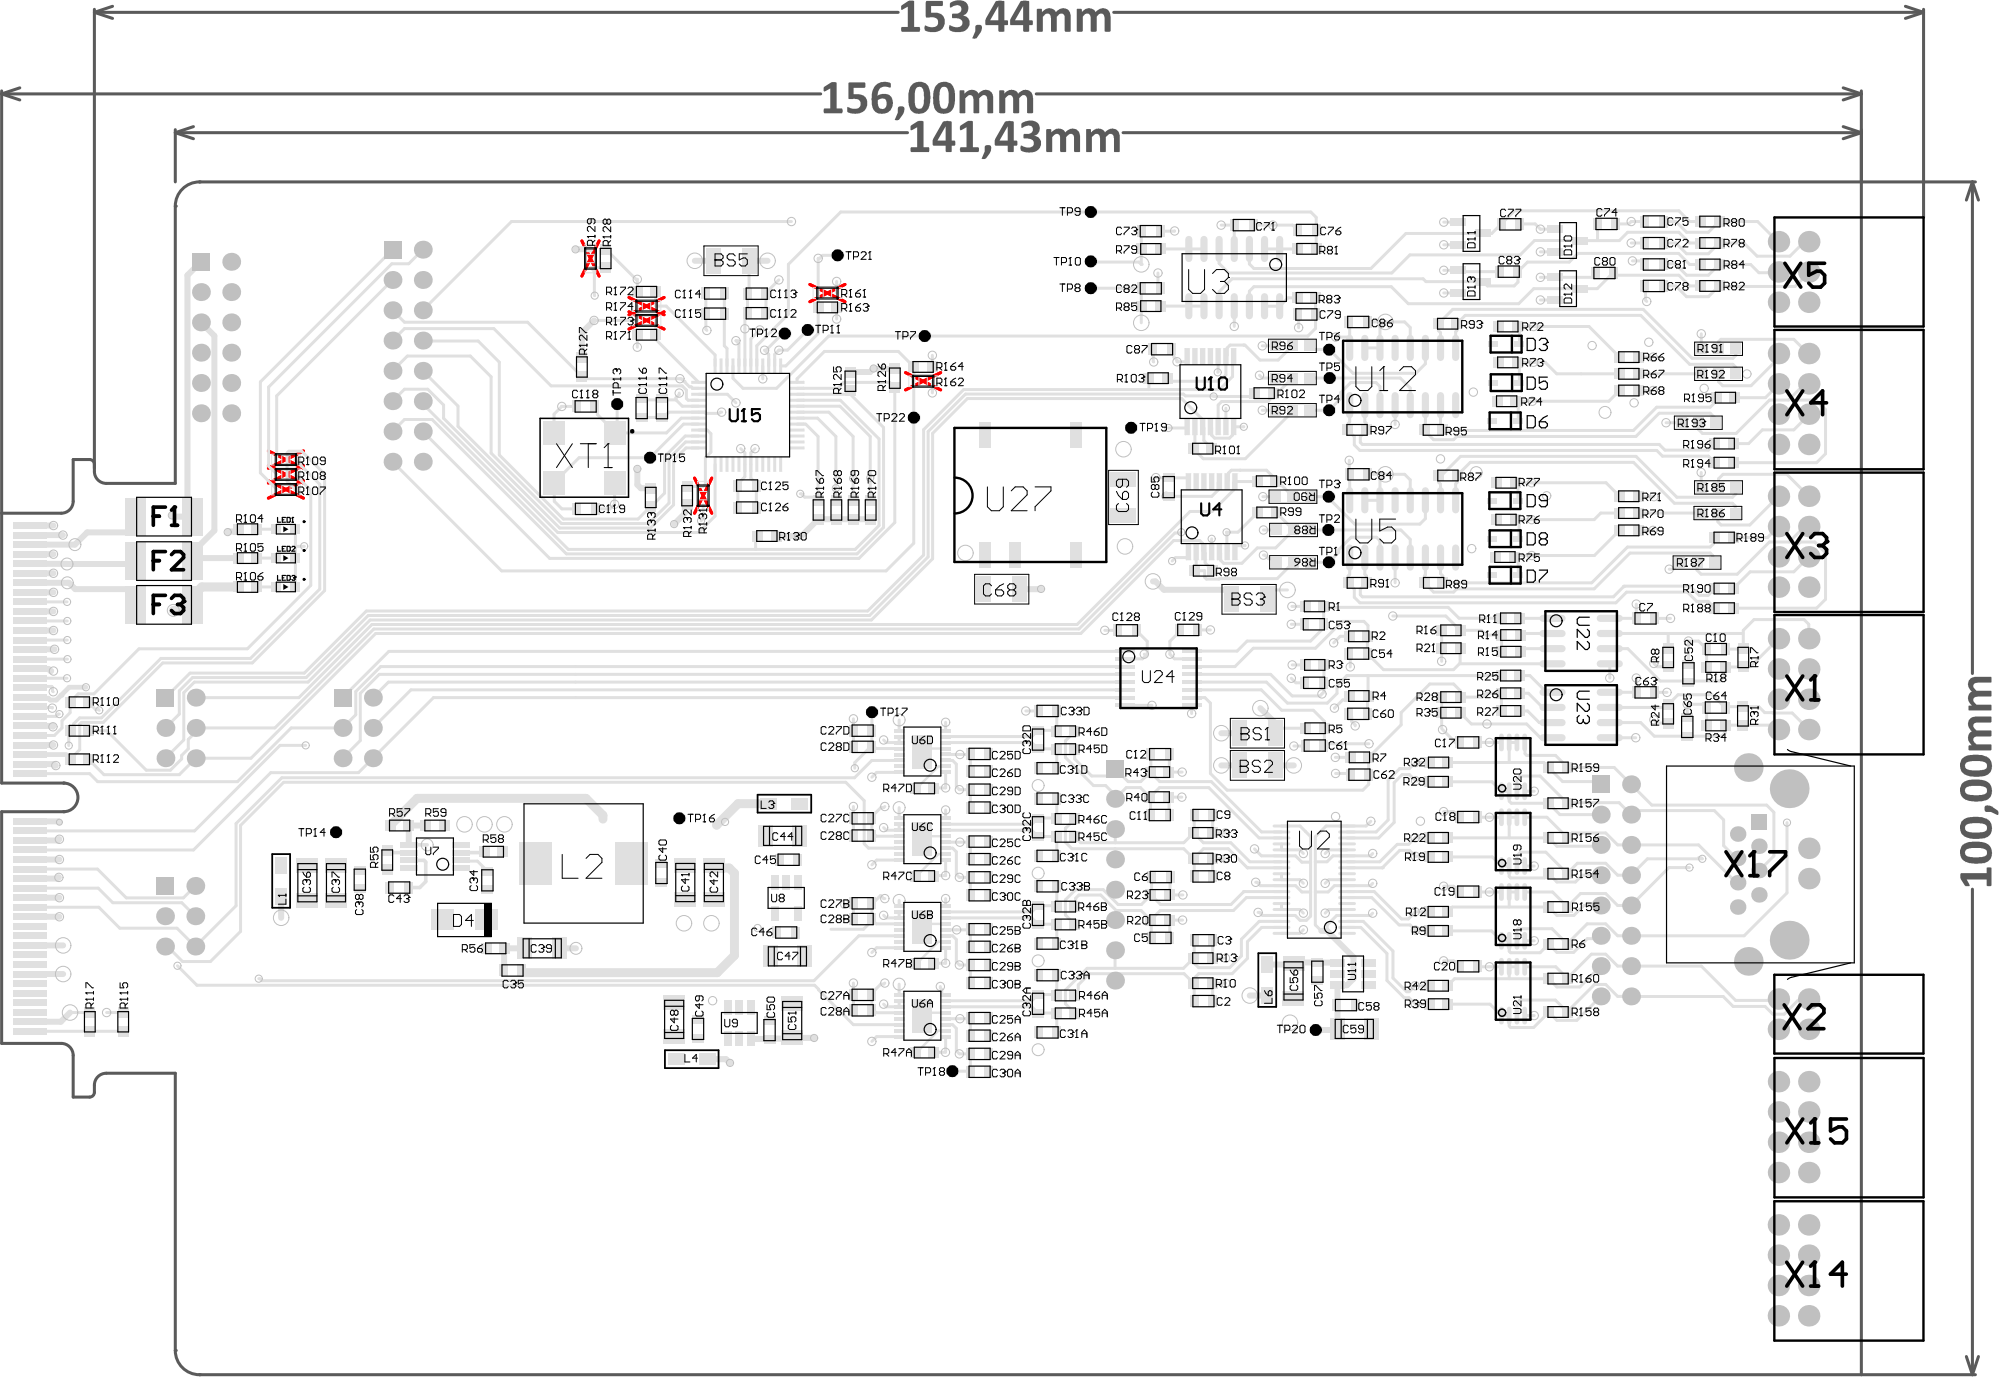
[picture p30: page 1]

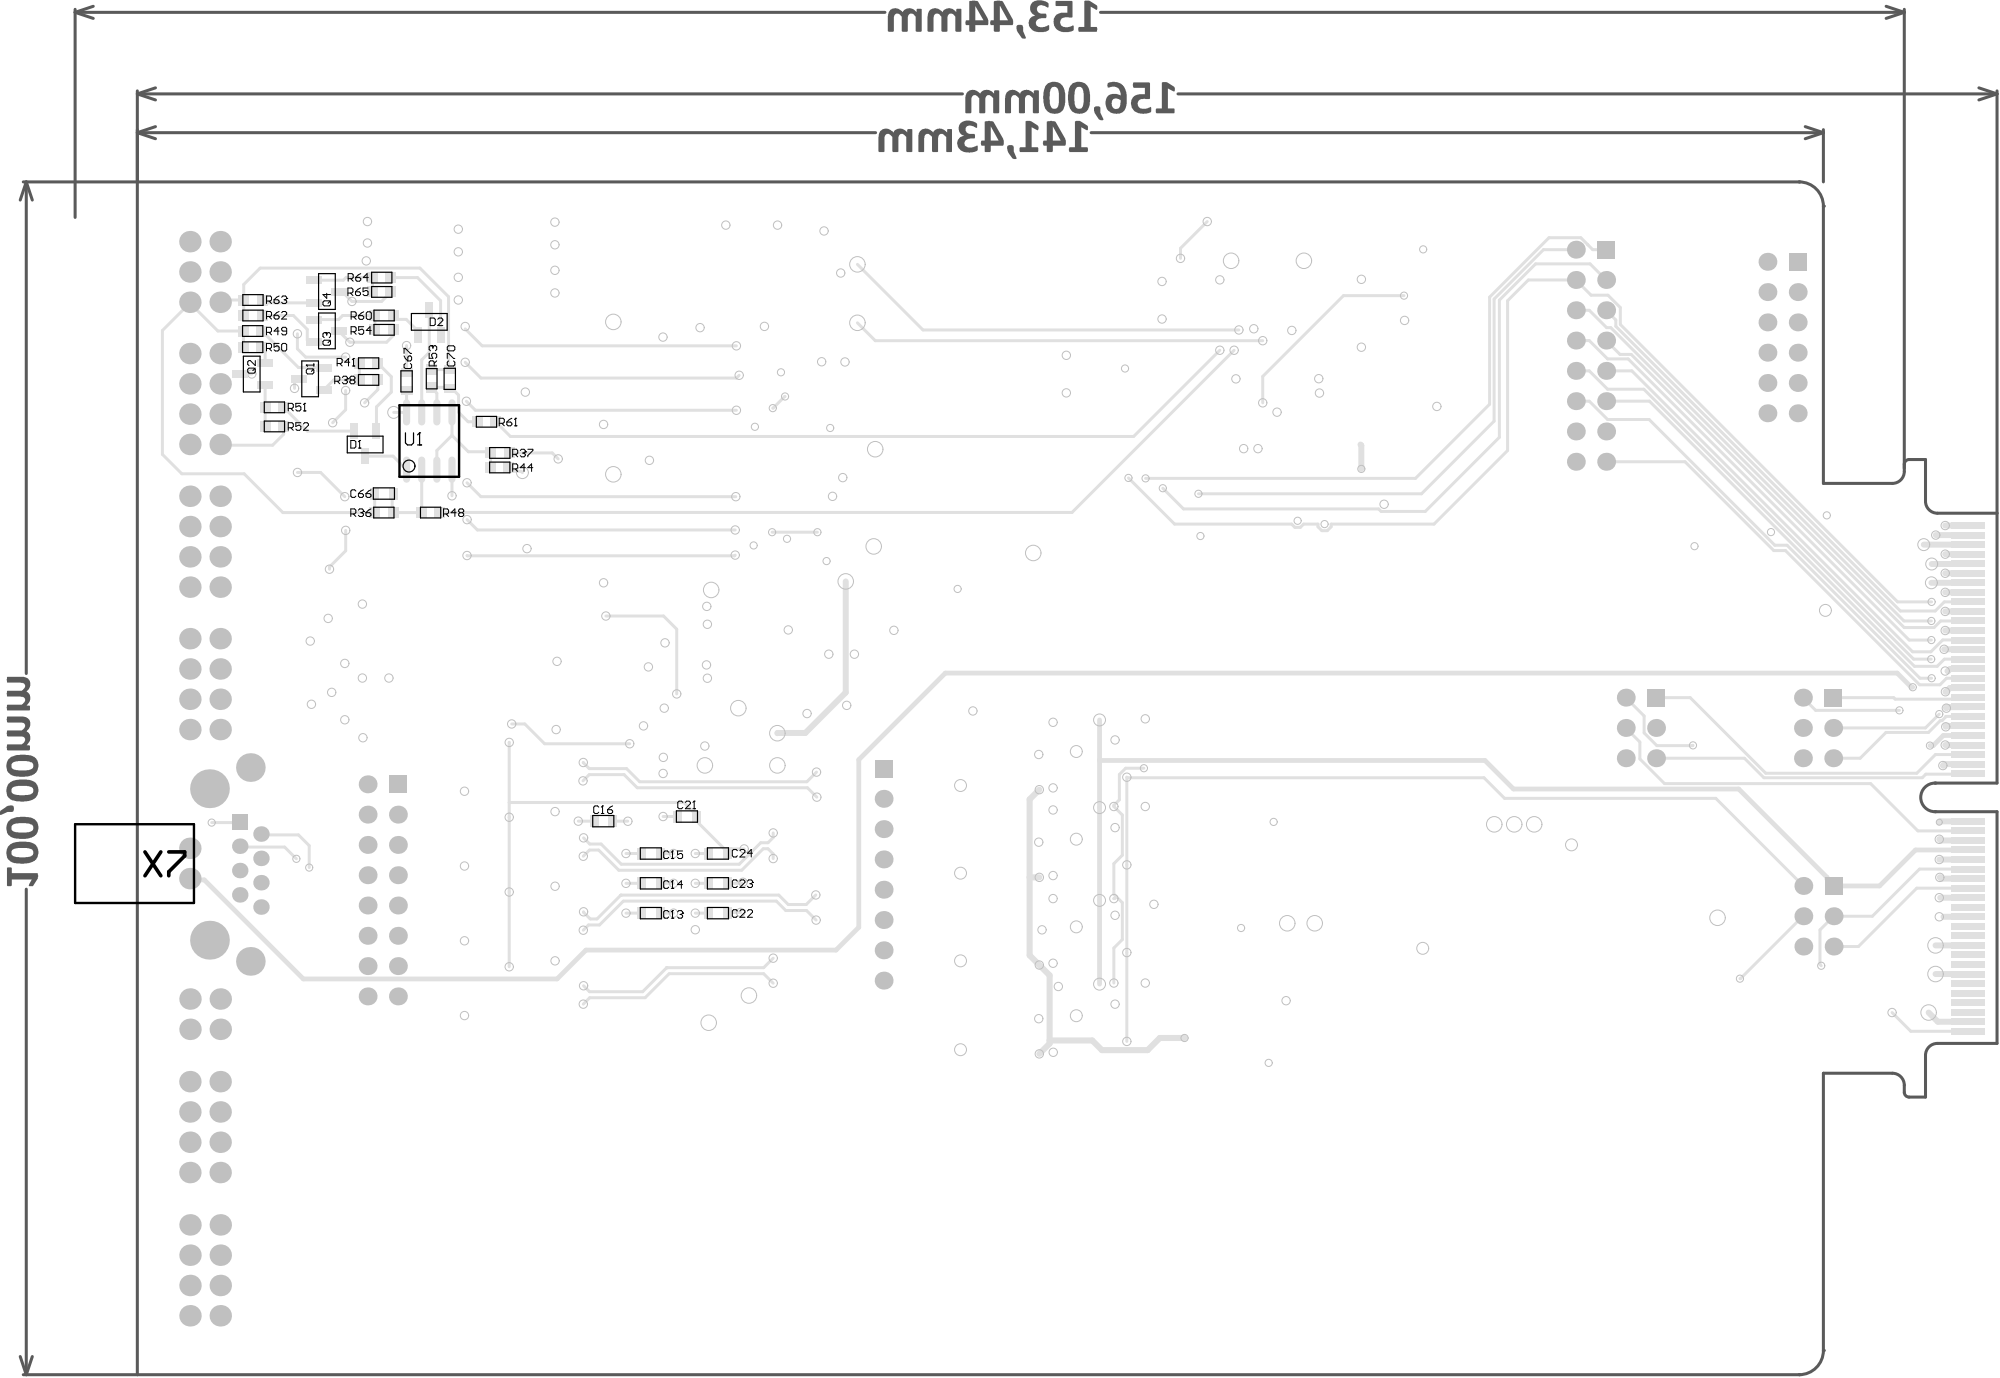
[picture p31: page 2]
