ultrazohm/uz_d_encoder/(list of files, drawings)

Other design files:
Absolute Encoder.SchDoc
AD_AD2S1210.PcbLib
AD_AD2S1210.SchLib
ADC_AH.SchDoc
Analog Hall.SchDoc
Buffer_EXC.SchDoc
Busswitch.SchDoc
Busswitch_A.SchDoc
Busswitch_B.SchDoc
Componentes_SOC.SchLib
Digital Interfaces.SchDoc
Export_Eagle/Imported Adapter_UARTSPI_RS485.PrjPcb/Adapter_UARTSPI_RS485.PcbDoc
Export_Eagle/Imported Adapter_UARTSPI_RS485.PrjPcb/Adapter_UARTSPI_RS485.PrjPcb
Export_Eagle/Imported Adapter_UARTSPI_RS485.PrjPcb/Adapter_UARTSPI_RS485_0.SchDoc
Export_Eagle/Imported Adapter_UARTSPI_RS485.PrjPcb/Adapter_UARTSPI_RS485_1.SchDoc
Goldfinger_Connector.SchDoc
I2CInterface.SchDoc
Impedance converter.SchDoc
Incremental Encoder.SchDoc
Input Mode Selector.SchDoc
Interface connector.SchDoc
Opamp_AH.SchDoc
Opamp_Temp.SchDoc
PortExpander.SchDoc
Power Supplies.SchDoc
PowerSupplies Temperature.SchDoc
Resolver.SchDoc
Samtec.PcbLib
Samtec.SCHLIB
Slow ADC.SchDoc
Temp Measurement.SchDoc
TopSheet.SchDoc
UltraZohm_ADC.SCHLIB
UltraZOhm_CarrierBoard.SchLib
UZ_D_Encoder.PrjPcb
UZ_D_Encoder.SCHLIB
uz_d_encoder_lib.PcbLib
uz_d_encoder_lib.SchLib
UZohmADC.PcbLib
