ultrazohm/uz_d_encoder/Export_Eagle/Imported Adapter_UARTSPI_RS485.PrjPcb/Adapter_UARTSPI_RS485.brd

## EAGLE design Export_Eagle/Imported Adapter_UARTSPI_RS485.PrjPcb/Adapter_UARTSPI_RS485.brd (2020-11-27)

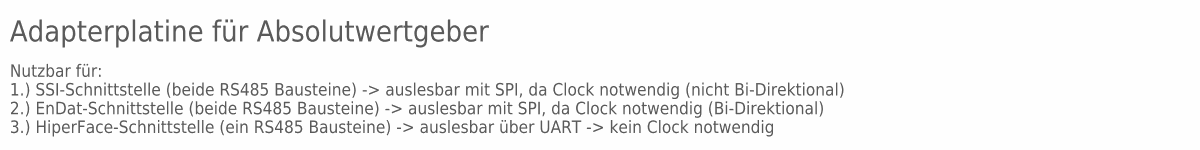
[picture p32: schematic Adapter_UARTSPI_RS485.sch, sheet 1]

Notes on the sheet:
Adapterplatine für Absolutwertgeber
Nutzbar für: 1.) SSI-Schnittstelle (beide RS485 Bausteine) -> auslesbar mit SPI, da Clock notwendig (nicht Bi-Direktional) 2.) EnDat-Schnittstelle (beide RS485 Bausteine) -> auslesbar mit SPI, da Clock notwendig (Bi-Direktional) 3.) HiperFace-Schnittstelle (ein RS485 Bausteine) -> auslesbar über UA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

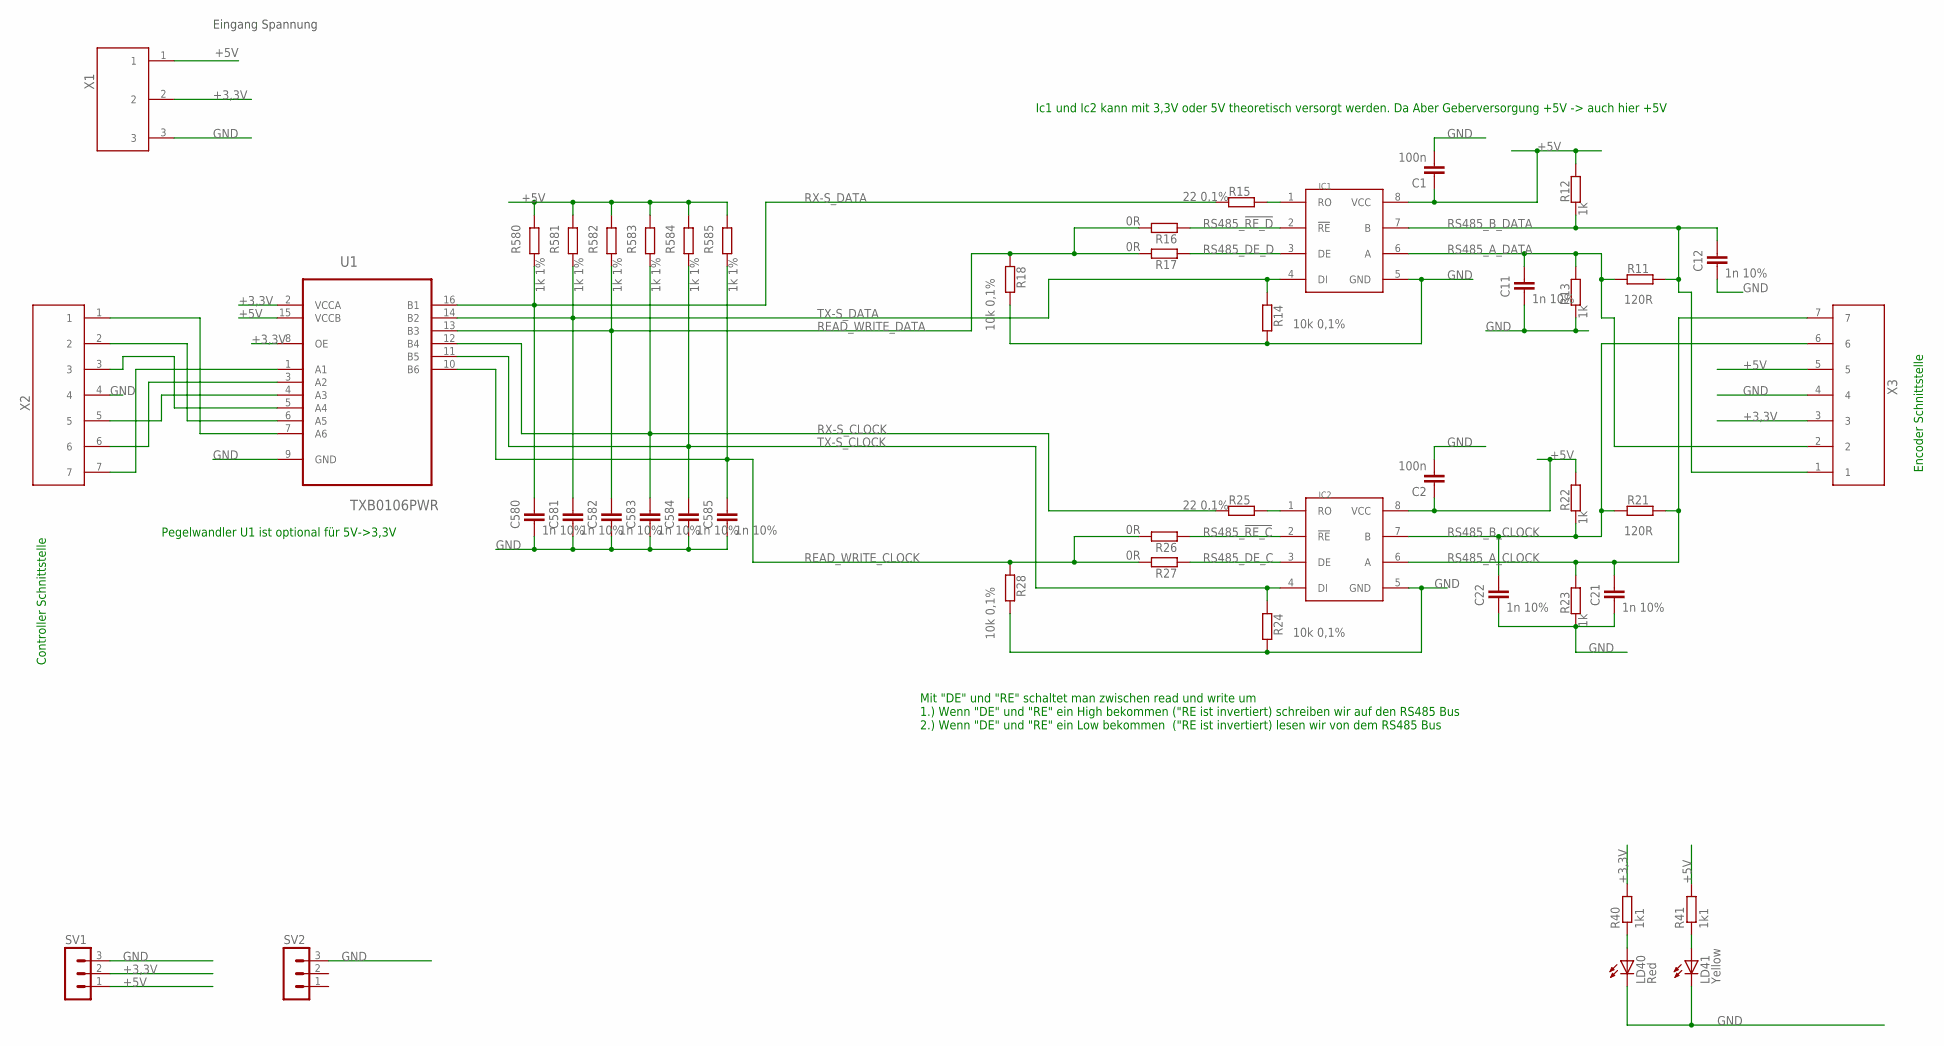
[picture p33: schematic Adapter_UARTSPI_RS485.sch, sheet 2, Schnittstellen]

Parts:
C1, C2: 100n; SMD-0603
C11, C12, C21, C22, C580, C581, C582, C583, C584, C585: 1n 10%; SMD-0603
IC1, IC2: RS485-MAXIM; SOIC8
LD40: Red; CHIP-LED0805
LD41: Yellow; CHIP-LED0805
R11, R21: 120R; R0603
R12, R13, R22, R23: 1k; R0603
R14, R18, R24, R28: 10k 0,1%; R0603
R15, R25: 22 0,1%; R0603
R16, R17, R26, R27: 0R; R0603
R40, R41: 1k1; R0805
R580, R581, R582, R583, R584, R585: 1k 1%; R0603
SV1, SV2: MA03-1
U1: TXB0106PWR; SOP65P640X120-16N
X1: KLEMME_3POLIG_2,54
X2, X3: KLEMME_7POLIG_2,54

Connections:
+3,3V: R40.2, SV1.2, U1.2 (VCCA), U1.8 (OE), X1.2, X3.3
+5V: C1.1, C2.1, IC1.8 (VCC), IC2.8 (VCC), R12.1, R22.1, R41.2, R580.2, R581.2, R582.2, R583.2, R584.2, R585.2, SV1.1, U1.15 (VCCB), X1.1, X3.5
GND: C1.2, C2.2, C11.2, C12.2, C21.2, C22.2, C580.2, C581.2, C582.2, C583.2, C584.2, C585.2, IC1.5 (GND), IC2.5 (GND), LD40.C, LD41.C, R13.2, R14.1, R18.1, R23.2, R24.1, R28.1, SV1.3, SV2.3, U1.9 (GND), X1.3, X2.4, X3.4
unnamed: IC2.1 (RO), R25.1
unnamed: LD41.A, R41.1
unnamed: LD40.A, R40.1
unnamed: IC1.1 (RO), R15.1
R/W_CLOCK: U1.7 (A6), X2.1
R/W_DATA: U1.4 (A3), X2.5
READ_WRITE_CLOCK: C585.1, R26.1, R27.1, R28.2, R585.1, U1.10 (B6)
READ_WRITE_DATA: C582.1, R16.1, R17.1, R18.2, R582.1, U1.13 (B3)
RS485_!RE_C: IC2.2 (!RE), R26.2
RS485_!RE_D: IC1.2 (!RE), R16.2
RS485_A_CLOCK: C21.1, IC2.6 (A), R21.1, R23.1, X3.7
RS485_A_DATA: C11.1, IC1.6 (A), R11.2, R13.1, X3.2
RS485_B_CLOCK: C22.1, IC2.7 (B), R21.2, R22.2, X3.6
RS485_B_DATA: C12.1, IC1.7 (B), R11.1, R12.2, X3.1
RS485_DE_C: IC2.3 (DE), R27.2
RS485_DE_D: IC1.3 (DE), R17.2
RX-S_CLOCK: C583.1, R25.2, R583.1, U1.12 (B4)
RX-S_DATA: C580.1, R15.2, R580.1, U1.16 (B1)
RX_CLOCK: U1.5 (A4), X2.3
RX_DATA: U1.1 (A1), X2.7
TX-S_CLOCK: C584.1, IC2.4 (DI), R24.2, R584.1, U1.11 (B5)
TX-S_DATA: C581.1, IC1.4 (DI), R14.2, R581.1, U1.14 (B2)
TX_CLOCK: U1.6 (A5), X2.2
TX_DATA: U1.3 (A2), X2.6

Notes on the sheet:
Eingang Spannung
Pegelwandler U1 ist optional für 5V->3,3V
Mit "DE" und "RE" schaltet man zwischen read und write um 1.) Wenn "DE" und "RE" ein High bekommen ("RE ist invertiert) schreiben wir auf den RS485 Bus 2.) Wenn "DE" und "RE" ein Low bekommen ("RE ist invertiert) lesen wir von dem RS485 Bus
Encoder Schnittstelle
Controller Schnittstelle
Ic1 und Ic2 kann mit 3,3V oder 5V theoretisch versorgt werden. Da Aber Geberversorgung +5V -> auch hier +5V

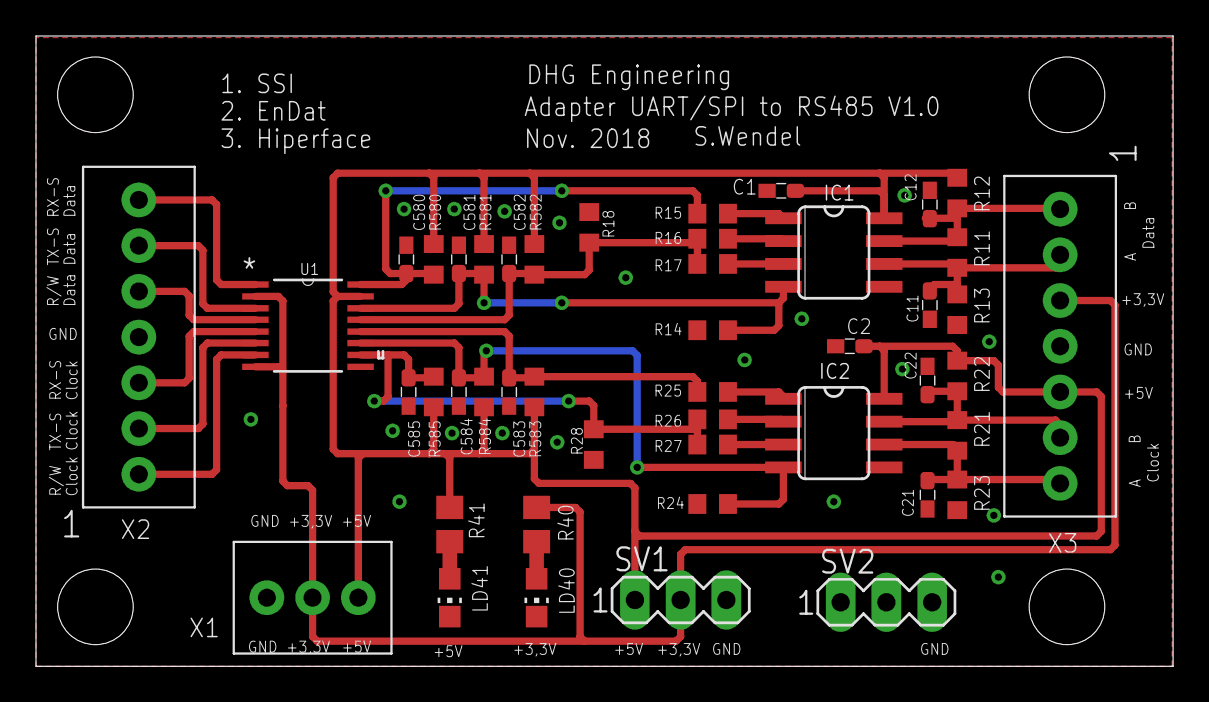
[picture p34: board Adapter_UARTSPI_RS485.brd from above]

Board: 4 copper layers, 63.2 x 35.0 mm, 46 parts (0 on the bottom side), 27 nets.
