ultrazohm/uz_d_encoder/IP-Core/Resolver/Resolver.srcs/sources_1/bd/design_1/hdl/design_1_wrapper.vhd

--Copyright 1986-2020 Xilinx, Inc. All Rights Reserved.
----------------------------------------------------------------------------------
--Tool Version: Vivado v.2020.1.1 (win64) Build 2960000 Wed Aug  5 22:57:20 MDT 2020
--Date        : Wed Oct 20 17:05:45 2021
--Host        : TUEIEAL-TL01 running 64-bit major release  (build 9200)
--Command     : generate_target design_1_wrapper.bd
--Design      : design_1_wrapper
--Purpose     : IP block netlist
----------------------------------------------------------------------------------
library IEEE;
use IEEE.STD_LOGIC_1164.ALL;
library UNISIM;
use UNISIM.VCOMPONENTS.ALL;
entity design_1_wrapper is
  port (
    DDR_addr : inout STD_LOGIC_VECTOR ( 14 downto 0 );
    DDR_ba : inout STD_LOGIC_VECTOR ( 2 downto 0 );
    DDR_cas_n : inout STD_LOGIC;
    DDR_ck_n : inout STD_LOGIC;
    DDR_ck_p : inout STD_LOGIC;
    DDR_cke : inout STD_LOGIC;
    DDR_cs_n : inout STD_LOGIC;
    DDR_dm : inout STD_LOGIC_VECTOR ( 3 downto 0 );
    DDR_dq : inout STD_LOGIC_VECTOR ( 31 downto 0 );
    DDR_dqs_n : inout STD_LOGIC_VECTOR ( 3 downto 0 );
    DDR_dqs_p : inout STD_LOGIC_VECTOR ( 3 downto 0 );
    DDR_odt : inout STD_LOGIC;
    DDR_ras_n : inout STD_LOGIC;
    DDR_reset_n : inout STD_LOGIC;
    DDR_we_n : inout STD_LOGIC;
    FIXED_IO_ddr_vrn : inout STD_LOGIC;
    FIXED_IO_ddr_vrp : inout STD_LOGIC;
    FIXED_IO_mio : inout STD_LOGIC_VECTOR ( 53 downto 0 );
    FIXED_IO_ps_clk : inout STD_LOGIC;
    FIXED_IO_ps_porb : inout STD_LOGIC;
    FIXED_IO_ps_srstb : inout STD_LOGIC;
    JA1 : out STD_LOGIC;
    JA2 : out STD_LOGIC;
    JA3 : out STD_LOGIC;
    JA4 : out STD_LOGIC;
    JA5 : in STD_LOGIC;
    JB1 : out STD_LOGIC;
    JB2 : out STD_LOGIC;
    JB3 : out STD_LOGIC;
    JB4 : out STD_LOGIC;
    btns_5bits_tri_i : in STD_LOGIC_VECTOR ( 4 downto 0 );
    leds_8bits_tri_o : out STD_LOGIC_VECTOR ( 7 downto 0 );
    sws_8bits_tri_i : in STD_LOGIC_VECTOR ( 7 downto 0 )
  );
end design_1_wrapper;

architecture STRUCTURE of design_1_wrapper is
  component design_1 is
  port (
    sws_8bits_tri_i : in STD_LOGIC_VECTOR ( 7 downto 0 );
    DDR_cas_n : inout STD_LOGIC;
    DDR_cke : inout STD_LOGIC;
    DDR_ck_n : inout STD_LOGIC;
    DDR_ck_p : inout STD_LOGIC;
    DDR_cs_n : inout STD_LOGIC;
    DDR_reset_n : inout STD_LOGIC;
    DDR_odt : inout STD_LOGIC;
    DDR_ras_n : inout STD_LOGIC;
    DDR_we_n : inout STD_LOGIC;
    DDR_ba : inout STD_LOGIC_VECTOR ( 2 downto 0 );
    DDR_addr : inout STD_LOGIC_VECTOR ( 14 downto 0 );
    DDR_dm : inout STD_LOGIC_VECTOR ( 3 downto 0 );
    DDR_dq : inout STD_LOGIC_VECTOR ( 31 downto 0 );
    DDR_dqs_n : inout STD_LOGIC_VECTOR ( 3 downto 0 );
    DDR_dqs_p : inout STD_LOGIC_VECTOR ( 3 downto 0 );
    leds_8bits_tri_o : out STD_LOGIC_VECTOR ( 7 downto 0 );
    FIXED_IO_mio : inout STD_LOGIC_VECTOR ( 53 downto 0 );
    FIXED_IO_ddr_vrn : inout STD_LOGIC;
    FIXED_IO_ddr_vrp : inout STD_LOGIC;
    FIXED_IO_ps_srstb : inout STD_LOGIC;
    FIXED_IO_ps_clk : inout STD_LOGIC;
    FIXED_IO_ps_porb : inout STD_LOGIC;
    btns_5bits_tri_i : in STD_LOGIC_VECTOR ( 4 downto 0 );
    JA1 : out STD_LOGIC;
    JA2 : out STD_LOGIC;
    JA3 : out STD_LOGIC;
    JA4 : out STD_LOGIC;
    JB1 : out STD_LOGIC;
    JB2 : out STD_LOGIC;
    JB3 : out STD_LOGIC;
    JB4 : out STD_LOGIC;
    JA5 : in STD_LOGIC
  );
  end component design_1;
begin
design_1_i: component design_1
     port map (
      DDR_addr(14 downto 0) => DDR_addr(14 downto 0),
      DDR_ba(2 downto 0) => DDR_ba(2 downto 0),
      DDR_cas_n => DDR_cas_n,
      DDR_ck_n => DDR_ck_n,
      DDR_ck_p => DDR_ck_p,
      DDR_cke => DDR_cke,
      DDR_cs_n => DDR_cs_n,
      DDR_dm(3 downto 0) => DDR_dm(3 downto 0),
      DDR_dq(31 downto 0) => DDR_dq(31 downto 0),
      DDR_dqs_n(3 downto 0) => DDR_dqs_n(3 downto 0),
      DDR_dqs_p(3 downto 0) => DDR_dqs_p(3 downto 0),
      DDR_odt => DDR_odt,
      DDR_ras_n => DDR_ras_n,
      DDR_reset_n => DDR_reset_n,
      DDR_we_n => DDR_we_n,
      FIXED_IO_ddr_vrn => FIXED_IO_ddr_vrn,
      FIXED_IO_ddr_vrp => FIXED_IO_ddr_vrp,
      FIXED_IO_mio(53 downto 0) => FIXED_IO_mio(53 downto 0),
      FIXED_IO_ps_clk => FIXED_IO_ps_clk,
      FIXED_IO_ps_porb => FIXED_IO_ps_porb,
      FIXED_IO_ps_srstb => FIXED_IO_ps_srstb,
      JA1 => JA1,
      JA2 => JA2,
      JA3 => JA3,
      JA4 => JA4,
      JA5 => JA5,
      JB1 => JB1,
      JB2 => JB2,
      JB3 => JB3,
      JB4 => JB4,
      btns_5bits_tri_i(4 downto 0) => btns_5bits_tri_i(4 downto 0),
      leds_8bits_tri_o(7 downto 0) => leds_8bits_tri_o(7 downto 0),
      sws_8bits_tri_i(7 downto 0) => sws_8bits_tri_i(7 downto 0)
    );
end STRUCTURE;
