ultrazohm/uz_d_encoder/(commit log)

2020-08-25 Initial version of the sensor board from Esteban and Sebastian
    [ADC_AH.SchDoc, AD_AD2S1210.PcbLib, AD_AD2S1210.SchLib, Absolute Encoder.SchDoc, Analog Hall.SchDoc, AnalogConnector.SchDoc, BOM UltraZohm_Digital_Sensor_Board.xls, Buffer_EXC.SchDoc]
2020-10-16 First Commit Rework Thomas Effenberger
    Datasheets added
    Part numbers added
    Minor schematic changes
    ERC and DRC Errors sovled
    PCB optimized
    [Absolute Encoder.SchDoc, Analog Hall.SchDoc, Buffer_EXC.SchDoc, Digital Interfaces.SchDoc, Impedance converter.SchDoc, Input Mode Selector.SchDoc, Opamp_AH.SchDoc, Opamp_Temp.SchDoc]
2020-10-16 Project file updated to last commit
    [UltraZohm_Digital_Sensor_Board.PrjPcb]
2020-10-16 Issues #3, #4, #12 solved
    [AnalogConnector.SchDoc, Input Mode Selector.SchDoc, Opamp_AH.SchDoc]
2020-10-16 Issues #6, #11 solved
    [Analog Hall.SchDoc, AnalogConnector.SchDoc, Digital Interfaces.SchDoc, Input Mode Selector.SchDoc, UltraZohm_Digital_Sensor_Board.PrjPcb]
2020-10-19 Issues #5, #7 solved
    [Absolute Encoder.SchDoc, BOM UltraZohm_Digital_Sensor_Board.xls, Buffer_EXC.SchDoc, Opamp_AH.SchDoc, PowerSupplies Temperature.SchDoc, Temp Measurement.SchDoc]
2020-10-19 Issues #2, #17 solved
    [BOM UltraZohm_Digital_Sensor_Board.xls, Interface connector.SchDoc, Opamp_Temp.SchDoc, PowerSupplies Temperature.SchDoc, Slow ADC.SchDoc, Temp Measurement.SchDoc, TopSheet.SchDoc, UltraZohm_Digital_Sensor_Board.PrjPcb]
2020-10-19 Issue #14 solved
    [BOM UltraZohm_Digital_Sensor_Board.xls, Buffer_EXC.SchDoc, Input Mode Selector.SchDoc, Interface connector.SchDoc, Opamp_AH.SchDoc, Resolver.SchDoc, UltraZohm_Digital_Sensor_Board.PrjPcb]
2020-10-21 Issues #8, #15, #16 solved
    - Every module has its own IO pins now
    - Debug headers for every IO pin
    [ADC_AH.SchDoc, Analog Hall.SchDoc, Buffer_EXC.SchDoc, Interface connector.SchDoc, Resolver.SchDoc, TopSheet.SchDoc]
2020-10-21 Issue #10 solved
    [Digital Interfaces.SchDoc, Input Mode Selector.SchDoc]
2020-10-22 Issues #1, #13, #19 solved
    [Absolute Encoder.SchDoc, Analog Hall.SchDoc, Digital Interfaces.SchDoc, Interface connector.SchDoc, Opamp_AH.SchDoc, Resolver.SchDoc, TopSheet.SchDoc]
2020-10-22 Issue #20 solved
    [Interface connector.SchDoc, TopSheet.SchDoc, UltraZohm_Digital_Sensor_Board.PrjPcb]
2020-10-23 Issues #21, #23, #25 solved
    [Absolute Encoder.SchDoc, Buffer_EXC.SchDoc, Digital Interfaces.SchDoc, Input Mode Selector.SchDoc, Interface connector.SchDoc, Power Supplies.SchDoc, Resolver.SchDoc, UltraZohm_Digital_Sensor_Board.PrjPcb]
2020-10-23 Issues #24, #26 solved
    [ADC_AH.SchDoc, Absolute Encoder.SchDoc, Analog Hall.SchDoc, Buffer_EXC.SchDoc, Digital Interfaces.SchDoc, Impedance converter.SchDoc, Input Mode Selector.SchDoc, Interface connector.SchDoc]
2020-10-23 Issue #28 solved
    [Resolver.SchDoc, UltraZohm_Digital_Sensor_Board.PrjPcb]
2020-10-23 Issue #31 solved
    [Interface connector.SchDoc, UltraZohm_Digital_Sensor_Board.PrjPcb]
2020-10-23 ordered PCB version
    [Ad2S1210_diff.xlsx]
2020-10-26 added missing libraries
    [Componentes_SOC.SchLib]
2020-10-26 Issue #36 solved
    [Absolute Encoder.SchDoc, Analog Hall.SchDoc, Buffer_EXC.SchDoc, Digital Interfaces.SchDoc, Impedance converter.SchDoc, Input Mode Selector.SchDoc, Opamp_AH.SchDoc, Resolver.SchDoc]
2020-10-26 Componentes Update
    [UltraZohm_Digital_Sensor_Board.PrjPcb]
2020-10-26 Componentes Update 2
    [Componentes_SOC.SchLib]
2020-10-26 BOM connected
    [UltraZohm_Digital_Sensor_Board.PrjPcb]
2020-10-26 More suppliers added
    [Analog Hall.SchDoc, Input Mode Selector.SchDoc, Opamp_AH.SchDoc]
2020-10-26 Issue #38 solved
    [Absolute Encoder.SchDoc, Buffer_EXC.SchDoc, Componentes_SOC.SchLib, Impedance converter.SchDoc]
2020-10-26 BOM Cleanup
    [Absolute Encoder.SchDoc, Buffer_EXC.SchDoc, Power Supplies.SchDoc, Resolver.SchDoc]
2020-10-27 Mechanical Layer Cleanup
    [Interface connector.SchDoc, UZohmADC.PcbLib, UltraZohm_Digital_Sensor_Board.PrjPcb]
2020-10-27 Issue #35 solved, Layer Cleanup
    Minor Layout changes around some 0603 parts due to unifying footprints
    [Buffer_EXC.SchDoc, Impedance converter.SchDoc, Interface connector.SchDoc, Power Supplies.SchDoc, Resolver.SchDoc, UZohmADC.PcbLib]
2020-10-28 Double Side Layers Added
    [UZohmADC.PcbLib, UltraZohm_Digital_Sensor_Board.PrjPcb]
2020-10-29 Issues #37, #40 solved
    [Analog Hall.SchDoc, Componentes_SOC.SchLib, Input Mode Selector.SchDoc, Interface connector.SchDoc, UZohmADC.PcbLib, UltraZohm_Digital_Sensor_Board.PrjPcb]
2020-11-05 Digital Interfaces bugs removed
    R98-R103 marked as DNP
    "DNP" option resistors values changed to 0R
    [Digital Interfaces.SchDoc, Input Mode Selector.SchDoc, UltraZohm_Digital_Sensor_Board.PrjPcb]
2020-11-12 Changed ADC Buffer Bypass Resistors to Optional Placement
    [Analog Hall.SchDoc, Opamp_AH.SchDoc, UltraZohm_Digital_Sensor_Board.PrjPcb]
2020-11-18 ADC Test results and code added
2020-11-27 reference design UART SPI RS485
    [Adapter_UARTSPI_RS485.PcbDoc, Adapter_UARTSPI_RS485.PrjPcb, Adapter_UARTSPI_RS485.brd, Adapter_UARTSPI_RS485.sch, Adapter_UARTSPI_RS485_0.SchDoc, Adapter_UARTSPI_RS485_1.SchDoc]
2020-11-27 Absolute Encoder Tests added
    Absolute Encoder Testcode created
    Placement option for logic lines pullups added
    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
    [Absolute Encoder.SchDoc, UltraZohm_Digital_Sensor_Board.PrjPcb]
2020-12-22 ADC Capacitors moved to TOP
2021-01-14 Issue #42 solved
    Renamed "Digital HALL" to "Incremental Encoder"
    [Incremental Encoder.SchDoc, Input Mode Selector.SchDoc, Interface connector.SchDoc, TopSheet.SchDoc, UltraZohm_Digital_Sensor_Board.PrjPcb]
2021-02-01 Issue #45 solved
    Digital IO Pins are now zero-based
    [Interface connector.SchDoc]
2021-05-20 Removed University Logos
    [TopSheet.SchDoc]
2021-06-10 PCB Project updated
    [UltraZohm_Digital_Sensor_Board.PrjPcb]
2021-06-24 added pinout table for carrier board interface cleaned up absolute encoder schematic
    [Absolute Encoder.SchDoc, pinout_table.xlsx]
2021-07-23 IP-Core AXI Update
    [Registers.xlsx]
2021-07-30 AXI Port Interface finished, IP Core Documentation updated
    [Registers.xlsx]
2021-10-20 Added resolver VHDL test block with ZedBoard IO connections
    [design_1_wrapper.vhd]
2021-10-28 Added issue table + interface
    [Issues.xlsx, serial_parallel_interface.xlsx]
2021-10-28 updated pinout table prepared schematics
    [Busswitch - Copy.SchDoc, Busswitch.SchDoc, Input Mode Selector.SchDoc, UltraZohm_Digital_Sensor_Board.PrjPcb, serial_parallel_interface.xlsx]
2021-11-08 most of the hardware changes (schematic) finished, i2c port expander missing
    [ADC_AH.SchDoc, Analog Hall.SchDoc, BOM20211031.xlsx, Busswitch.SchDoc, Busswitch_A.SchDoc, Busswitch_B.SchDoc, Goldfinger_Connector.SchDoc, Interface connector.SchDoc]
2021-11-08 schematics completed
    [ADC_AH.SchDoc, Absolute Encoder.SchDoc, Busswitch.SchDoc, Busswitch_A.SchDoc, Busswitch_B.SchDoc, Interface connector.SchDoc, TopSheet.SchDoc, UltraZohm_Digital_Sensor_Board.PrjPcb]
2021-11-17 schematics update after review
    [ADC_AH.SchDoc, Absolute Encoder.SchDoc, Analog Hall.SchDoc, Busswitch.SchDoc, Busswitch_A.SchDoc, Busswitch_B.SchDoc, Goldfinger_Connector.SchDoc, I2CInterface.SchDoc]
2021-11-28 alles platziert
    [ADC_AH.SchDoc, Absolute Encoder.SchDoc, Analog Hall.SchDoc, Buffer_EXC.SchDoc, Busswitch.SchDoc, Impedance converter.SchDoc, Input Mode Selector.SchDoc, Interface connector.SchDoc]
2021-11-29 layout 0.2
    [Analog Hall.SchDoc, Busswitch_B.SchDoc]
2021-11-30 v0.1 (86 traces unrouted, cleaned up others)
    [Input Mode Selector.SchDoc]
2021-11-30 routing v1 finished
    [UltraZohm_Digital_Sensor_Board.PrjPcb]
2021-12-01 prep'd for changing schematic
2021-12-01 Adapted incremental schem - made it more readable
    [Incremental Encoder.SchDoc, Input Mode Selector.SchDoc]
2021-12-01 incr enc spacing 1mm
    [Input Mode Selector.SchDoc]
2021-12-02 all designators sorted and placed - all layout schematic requests til now finished
    [Input Mode Selector.SchDoc, TopSheet.SchDoc, UltraZohm_Digital_Sensor_Board.PrjPcb, uz_d_encoder_lib.PcbLib, uz_d_encoder_lib.SchLib]
2021-12-08 hardwareänderungen eingebaut
    [Incremental Encoder.SchDoc, Resolver.SchDoc, UltraZohm_Digital_Sensor_Board.PrjPcb]
2021-12-09 added LOS und DOT to Portexpander to have this signal available
    [Analog Hall.SchDoc, Resolver.SchDoc, TopSheet.SchDoc]
2021-12-14 updated project naming and readded thermals
    [Incremental Encoder.SchDoc, UZ_D_Encoder.PrjPcb, UltraZohm_Digital_Sensor_Board.PrjPcb]
2021-12-19 several small tweaks on layout and schematic basically added ser num field changed pull up for cvn signal to 3v3 instead of 5v referred dvdd of resolver to 5v fused instead of analog supply (filtered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
    [Goldfinger_Connector.SchDoc, Resolver.SchDoc, TopSheet.SchDoc]
2021-12-22 all changes implemented
    [Goldfinger_Connector.SchDoc, Interface connector.SchDoc]
2021-12-23 generated output files for Rev02 folder clean up
    [BOM20211031.xlsx, Issues.xlsx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]
2022-04-04 finished hardware
    [ADC_AH.SchDoc, Absolute Encoder.SchDoc, Buffer_EXC.SchDoc, Goldfinger_Connector.SchDoc, Impedance converter.SchDoc, Input Mode Selector.SchDoc, Interface connector.SchDoc, Power Supplies.SchDoc]
2022-04-19 small adaptions (rounded edges, quarz traces vias tented)
2022-06-11 commit to switch branches. only altium autosve
    [Interface connector.SchDoc, UZ_D_Encoder.PrjPcb]
